Hoektronics/Shukongji/scripts/pcb-gcode-3.6.0.1/docs/images/isolation.jpg

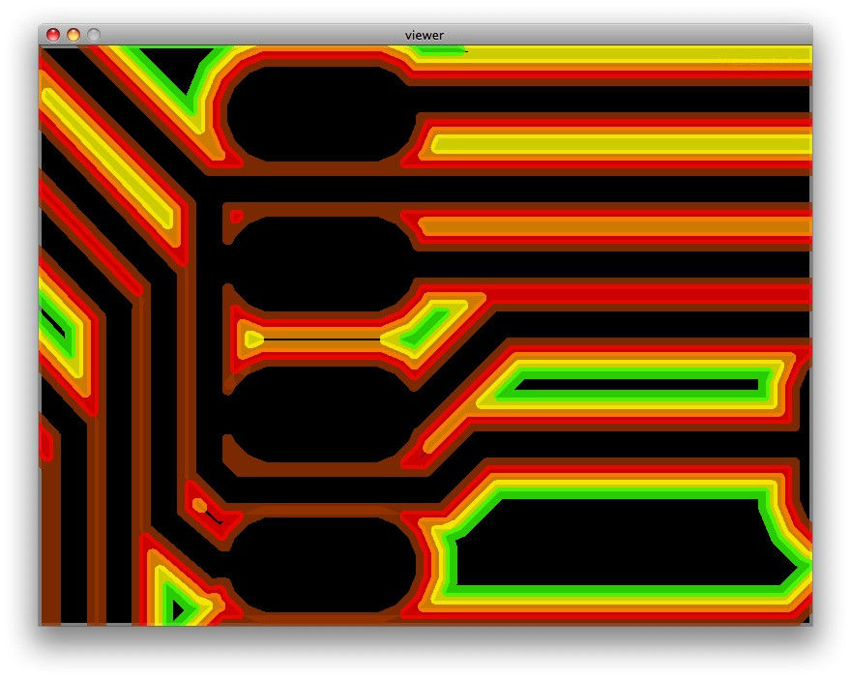
scripts/pcb-gcode-3.6.0.1/docs/images/isolation.jpg
