Hoektronics/Shukongji/scripts/pcb-gcode-3.6.0.1/docs/images/0_007.jpg

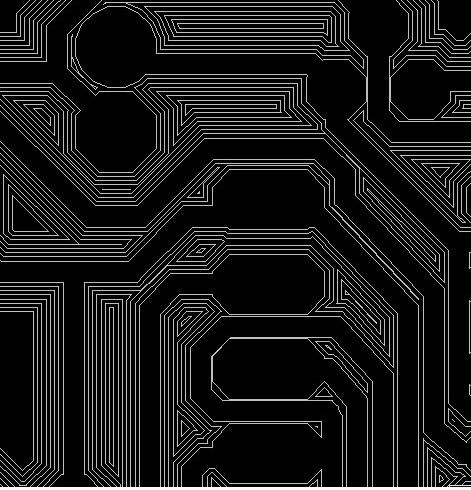
scripts/pcb-gcode-3.6.0.1/docs/images/0_007.jpg
