Hoektronics/Shukongji/scripts/pcb-gcode-3.6.0.1/docs/images/clr0_007.jpg

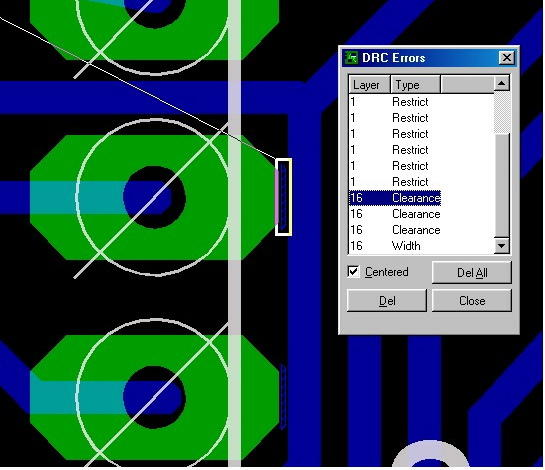
scripts/pcb-gcode-3.6.0.1/docs/images/clr0_007.jpg
