Hoektronics/Shukongji/scripts/pcb-gcode-3.6.0.1/docs/images/isolation_settings.jpg

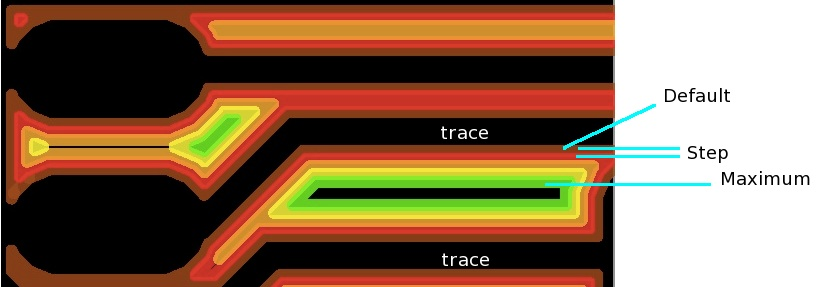
scripts/pcb-gcode-3.6.0.1/docs/images/isolation_settings.jpg
