Hoektronics/Shukongji/scripts/pcb-gcode-3.6.0.1/docs/images/pcb.jpg

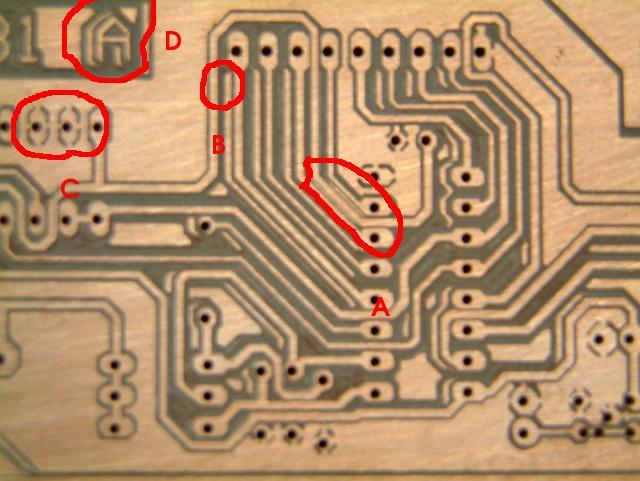
scripts/pcb-gcode-3.6.0.1/docs/images/pcb.jpg
