Hoektronics/Shukongji/scripts/pcb-gcode-3.6.0.1/docs/images/setting_other_clr_0_007.jpg

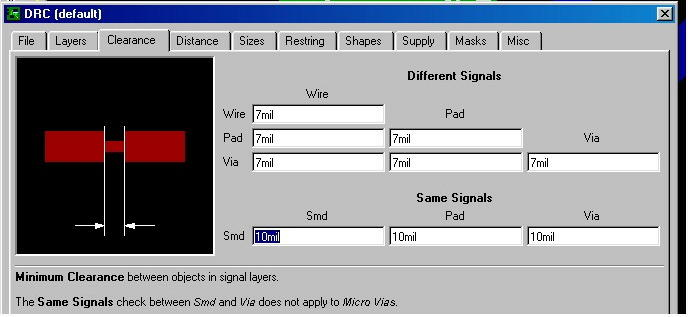
scripts/pcb-gcode-3.6.0.1/docs/images/setting_other_clr_0_007.jpg
