Hoektronics/Shukongji/electronics/hoekdrive17/bill-of-materials.xls

Qty | Value | Device | Parts | Manufacturer | Manufacturer P/N
2 | 8 pins | .100" pitch breakaway header, male | JP1, JP2
1 | 680nF | CAPACITOR - 0805 - 10% - 25V | C1
2 | 220nF | CAPACITOR - 0603 - 10% - 25V | C2, C7
3 | 100nF | CAPACITOR - 0603 - 10% - 25V | C3, C5, C6
1 | 33k | RESISTOR - 0603 - 1% | R1
4 | 100k | RESISTOR - 0603 - 5% | R2, R3, R4, R6
1 | 12k | RESISTOR - 0603 - 1% | R5
2 | 0.27R | RESISTOR - 0805 - 1% | R7, R8
1 | 1k | RESISTOR - 0805 - 5% | R9
1 | GREEN | LED - 0805 - GREEN | POWER
1 | A4982 | A4982 | A4982 | Allegro | A4982SETTR-T
