Hoektronics/Shukongji/electronics/cnc-controller/mega-pin-allocation.xls

Sheet: Overview
i/o requirements:
module | pins | instances | total
usb / serial | 2 | 1 | 2 | ok
axes steppers | 3 | 5 | 15 | ok
endstops | 1 | 6 | 6 | ok
sd card | 1 | 1 | 1 | ok
buzzer | 1 | 1 | 1 | ok
debug led | 1 | 1 | 1 | ok
led mosfets | 3 | 1 | 3 | ok
spi | 3 | 1 | 3 | ok
tool zeroing | 1 | 1 | 1 | ok
door | 1 | 1 | 1 | ok
spindle rpm | 1 | 1 | 1 | ok
spindle on/off | 1 | 1 | 1 | ok
vacuum on/off | 1 | 1 | 1 | ok
spindle speed (spi) | 1 | 1 | 1 | ok
user uarts | 2 | 3 | 6 | ok
i2c | 2 | 1 | 2 | ok
lcd interface | 6 | 1 | 6
 |  | total | 52
 |  | available | 54
 |  | remaining | 2

Sheet: Pin Allocation
Pin Name | Alt1 | Alt2 | Alt3 | My Usage | peripheral allocation
D0 | RX0 |  |  | USB SERIAL | uart0 | serial
D1 | TX0 |  |  | USB SERIAL | uart1 | user
D2 | PWM | INTERRUPT |  | TACHOMETER | uart2 | user
D3 | PWM | INTERRUPT |  | VACUUM RELAY | uart3 | user
D4 | PWM |  |  | SPINDLE SPEED | i2c | user
D5 | PWM |  |  | BUZZER | spi | sd / digipot / user
D6 | PWM |  |  | GREEN
D7 | PWM |  |  | RED
D8 | PWM |  |  | BLUE
D9 | PWM |  |  | LCD_RS
D10 | PWM |  |  | LCD_EN
D11 | PWM |  |  | LCD_D7
D12 | PWM |  |  | LCD_D6
D13 | PWM | DEBUG |  | DEBUG LED
D14 | TX3 |  |  | ENC_A
D15 | RX3 |  |  | ENC_B
D16 | TX2 |  |  | user
D17 | RX2 |  |  | user
D18 | TX1 | INTERRUPT |  | user
D19 | RX1 | INTERRUPT |  | user
D20 | SDA | INTERRUPT |  | I2C
D21 | SCL | INTERRUPT |  | I2C
D22 |  |  |  | LCD_D5
D23 |  |  |  | LCD_D4
D24 |  |  |  | OK_BUTTON
D25 |  |  |  | DOOR
D26 |  |  |  | TOOLZERO
D27 |  |  |  | XMIN
D28 |  |  |  | XMAX
D29 |  |  |  | YMIN
D30 |  |  |  | YMAX
D31 |  |  |  | ZMIN
D32 |  |  |  | ZMAX
D33 |  |  |  | XSTEP
D34 |  |  |  | XDIR
D35 |  |  |  | XENABLE
D36 |  |  |  | YSTEP
D37 |  |  |  | YDIR
D38 |  |  |  | YENABLE
D39 |  |  |  | ZSTEP
D40 |  |  |  | ZDIR
D41 |  |  |  | ZENABLE
D42 |  |  |  | ASTEP
D43 |  |  |  | ADIR
D44 | PWM |  |  | AENABLE
D45 | PWM |  |  | BSTEP
D46 | PWM |  |  | BDIR
D47 |  |  |  | BENABLE
D48 |  |  |  | DIGIPOT SELECT
D49 |  |  |  | SD SELECT
D50 | MISO |  |  | SPI
D51 | MOSI |  |  | SPI
D52 | SCK |  |  | SPI
D53 | SS |  |  | SPI
