Hoektronics/Shukongji/electronics/cnc-controller/power-budget.xls

Sheet: Sheet1
power budget |  | 3.3V (mA) |  |  | 5V (mA) |  |  | 24V (A)
module | qty | min | max | total | min | max | total | min | max | total
axes steppers | 4 | 0 | 0 | 0 | 0 | 5 | 20 | 0 | 4.8 | 19.2
lcpxpresso | 1 |  |  | 0 |  | 100 | 100 |  |  | 0
sd card | 1 |  | 100 | 100 |  |  | 0 |  |  | 0
level shifters | 2 |  | 100 | 200 |  | 50 | 100 |  |  | 0
bluetooth | 1 |  | 50 | 50 |  |  | 0 |  |  | 0
wifi | 1 |  | 212 | 212 |  |  | 0 |  |  | 0
3.3V | 1 |  |  | 0 |  | 370.92 | 370.92 |  |  | 0
5v | 1 |  |  | 0 |  |  | 0 |  | 0.1231083333 | 0.1231083333
 | total |  |  | 562 |  |  | 590.92 |  |  | 19.32310833

Sheet: Sheet2
Left Row |  |  | Right Row |  |  | Extras
Pin Name | Function | My Usage | Pin Name | Function | My Usage | Pin Name | Function | My Usage
P0.9 | MOSI | SD Card | P0.4 | CAN_RX |  | P2.9 | USB PULLUP | NONE
P0.8 | MISO | SD Card | P0.5 | CAN_TX | ASTEP | P0.20 |  | SPINSPD
P0.7 | SCK | SD Card | P0.10 | TX/I2C | ADIR | P0.19 |  | DOOR
P0.6 |  | SD Card | P0.11 | RX/I2C | ZENABLE | P4.29 |  | TOOLZERO
P0.0 | i2c / tx |  | P2.0 | PWM | MOSFET | P4.28 |  | x protect
P0.1 | i2c / rx |  | P2.1 | PWM | MOSFET | P3.26 |  | y protect
P0.18 | MOSI | AENABLE | P2.2 | PWM | MOSFET | P3.25 |  | z protect
P0.17 | MISO | ZSTEP | P2.3 | PWM | YENABLE | P1.29 |  | ZDIR
P0.15 | SCK / Tx | debug port | P2.4 | PWM | XSTEP | P1.28 |  | a protect
P0.16 | Rx | debug port | P2.5 | PWM | XDIR | P1.27
P0.23 | analog | CURRENT- | P2.6 |  |  | P1.26 |  | YSTEP
P0.24 | analog | CURRENT+ | P2.7 |  |  | P1.25 |  | BUZZER
P0.25 | analog |  | P2.8 |  |  | P1.24 |  | SPINDLE RELAY
P0.26 | analog | VOUT | P2.10 |  |  | P1.23 |  | YDIR
P1.30 | analog |  | P2.11 |  |  | P1.22
P1.31 | analog | YSTOP | P2.12 |  |  | P1.21 |  | XSTOP
P0.2 |  | ZSTOP |  |  |  | P1.20 |  | XENABLE
P0.3 |  | ASTOP |  |  |  | P1.19
P0.21 |  |  |  |  |  | P1.18
P0.22
P0.27
P0.28
P2.13
