Hoektronics/Shukongji/mechanical/Mechanical Switch.SLDASM

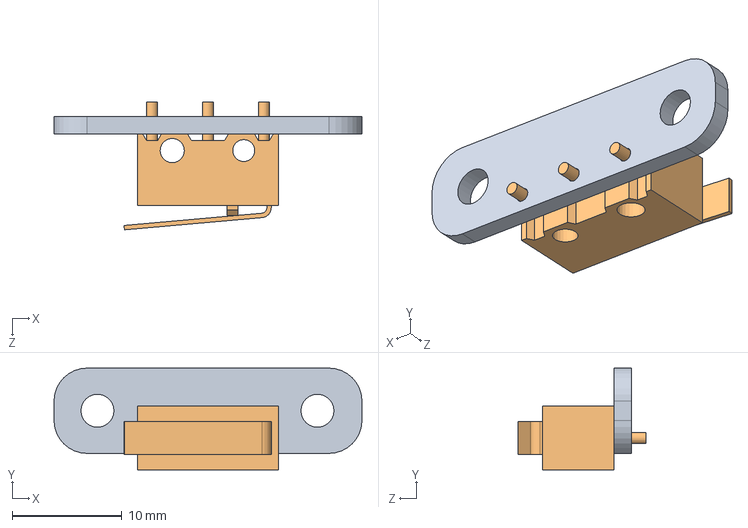
[picture p11: CAD file, 2013-03-05]
mechanical/Mechanical Switch.SLDASM
28.0 x 9.25 x 11.6 mm
Switch-PCB
D2F-Switch
