Hoektronics/Shukongji/mechanical/X-Axis.SLDASM

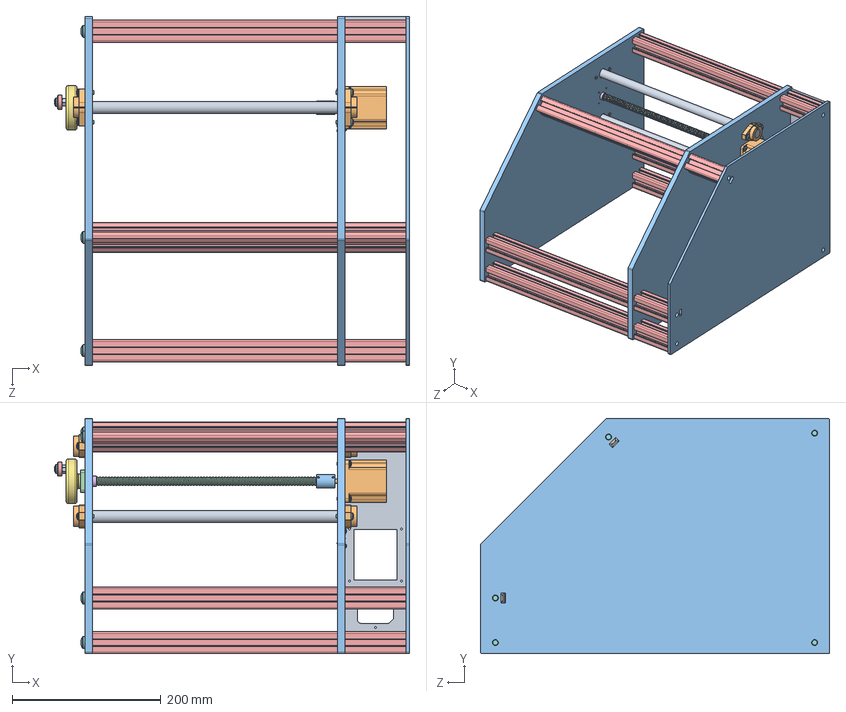
[picture p12: CAD file, 2013-03-05]
mechanical/X-Axis.SLDASM
478.5 x 317.0 x 470.0 mm
X-Rod x 2
nema23
flexible-coupling
SFUXXXX-Ball-Screw
626ZZ x 2
F6-14-Thrust-Bearing
Hand-Wheel
pan cross head_am x 25
hex nut style 1_am x 4
SHF16 x 4
Side-Panel x 2
626-Bearing-Mount
Frame-Base-Width x 11
flat washer narrow_am
Switch-PCB
D2F-Switch
Rear-Panel
LED-Strip x 2
LED-Cover x 2
