Hoektronics/Shukongji/mechanical/Hand-Wheel.SLDASM

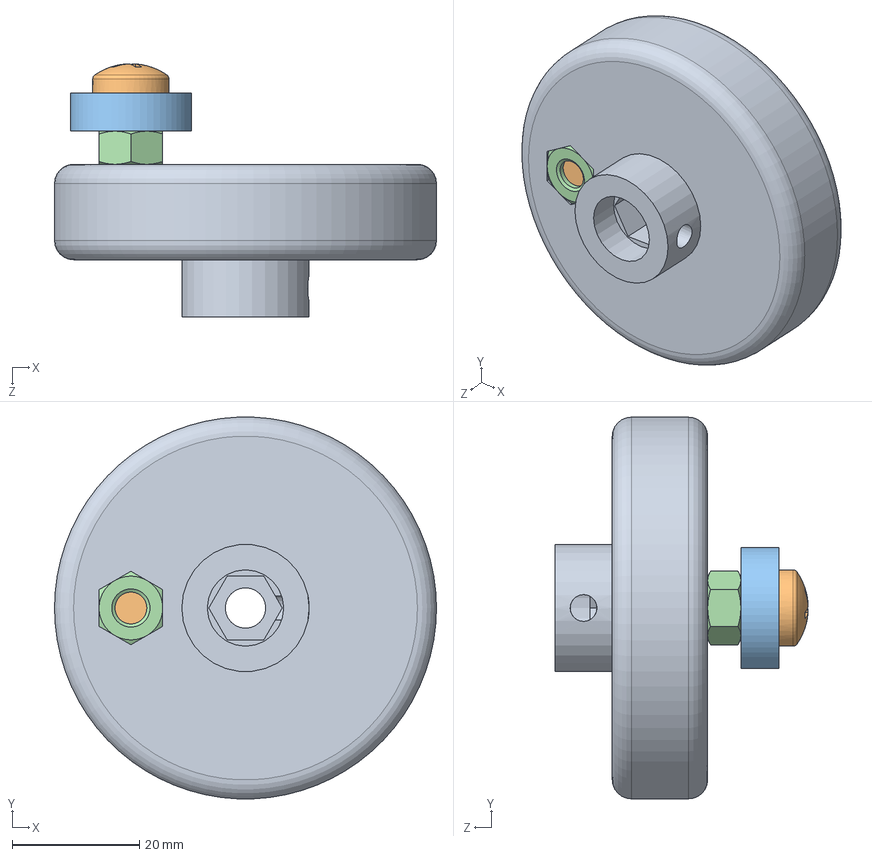
[picture p13: CAD file, 2013-03-05]
mechanical/Hand-Wheel.SLDASM
60.0 x 59.9 x 39.8 mm
Hand-Wheel
pan cross head_am
626ZZ
hex nut style 1_am x 2
