Hoektronics/Shukongji/mechanical/Y-Drive.SLDASM

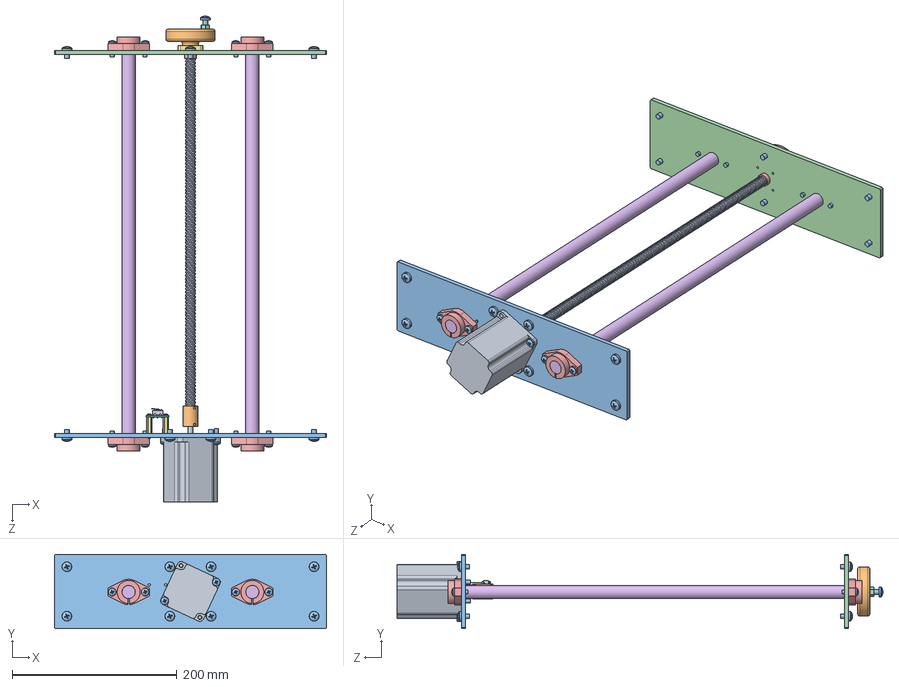
[picture p14: CAD file, 2013-03-05]
mechanical/Y-Drive.SLDASM
330.0 x 90.0 x 589.5 mm
flexible-coupling
Y-Plate-Front
Y-Plate-Rear
SHF16 x 4
Y-Rod x 2
626-Bearing-Mount
626ZZ
SFUXXXX-Ball-Screw
F6-14-Thrust-Bearing
flat washer narrow_am
hex nut style 1_am x 2
pan cross head_am x 30
Hex-Standoff x 2
Switch-PCB
D2F-Switch
