Hoektronics/Shukongji/mechanical/Spindle Assembly.SLDASM

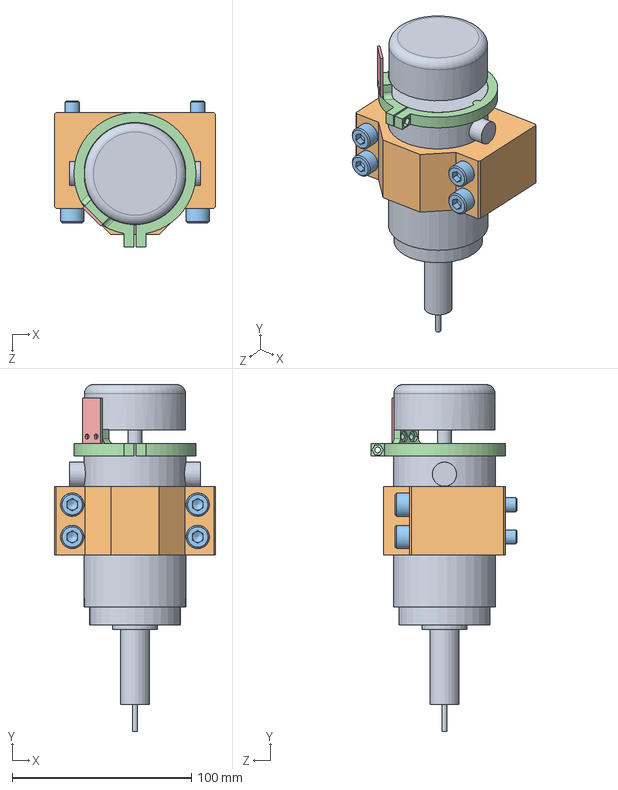
[picture p15: CAD file, 2013-03-05]
mechanical/Spindle Assembly.SLDASM
90.0 x 193.5 x 81.5 mm
E240-Spindle
Spindle-Clamp
socket head cap screw_am x 4
Tachometer-Mount
Tachometer-PCB
