Hoektronics/Shukongji/mechanical/Z-Axis.SLDASM

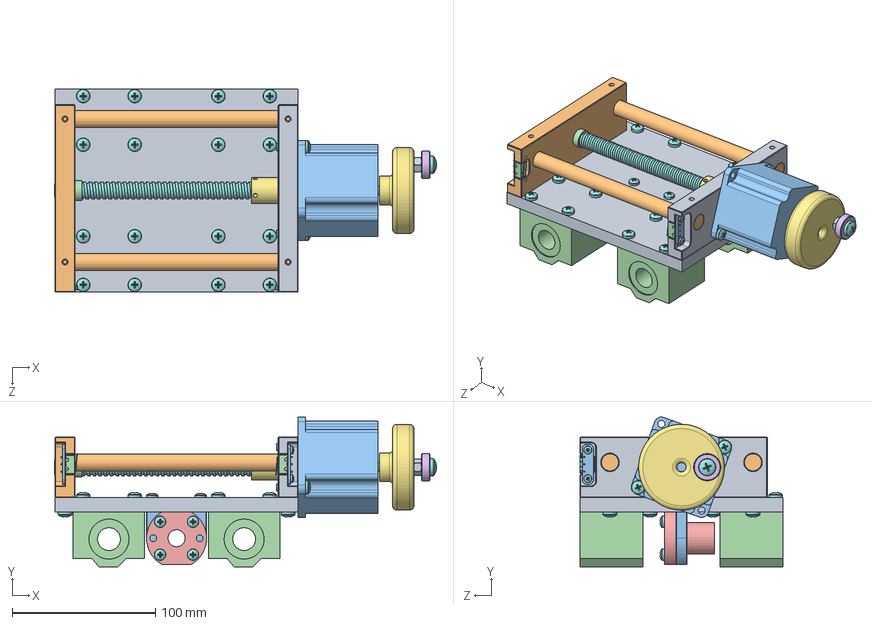
[picture p16: CAD file, 2013-03-05]
mechanical/Z-Axis.SLDASM
267.1 x 104.8 x 142.0 mm
Z-Plate
Z-Rod x 2
nema23
SC16UU x 4
SFU1204-Nut
626ZZ x 2
flexible-coupling
SFUXXXX-Ball-Screw
XY-Motor-Mount
XY-Bearing-Mount
SFU1204-Nut-Mount
F6-14-Thrust-Bearing
hex nut jam_am
flat washer narrow_am
Hand-Wheel
pan cross head_am x 35
hex nut style 1_am x 2
socket set screw flat point_am x 4
Switch-PCB x 2
D2F-Switch x 2
