Hoektronics/Shukongji/mechanical/Y-Stage.SLDASM

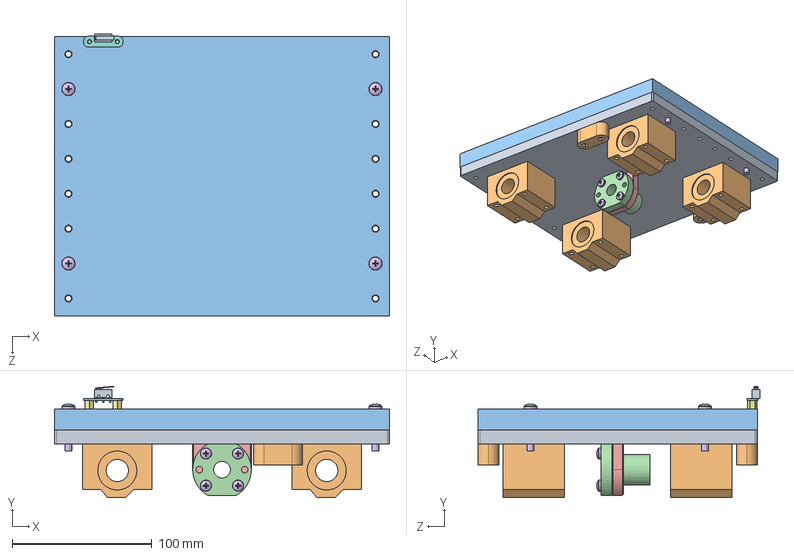
[picture p17: CAD file, 2013-03-05]
mechanical/Y-Stage.SLDASM
240.0 x 79.8 x 201.9 mm
Y-Stage-Plate
SC16UU x 4
Y-Stage
SFU1204-Nut
SFU1204-Nut-Mount
pan cross head_am x 26
Hex-Standoff x 2
Switch-PCB
D2F-Switch
Y-Endstop-Trigger x 2
