Hoektronics/Shukongji/mechanical/Z-Stage.SLDASM

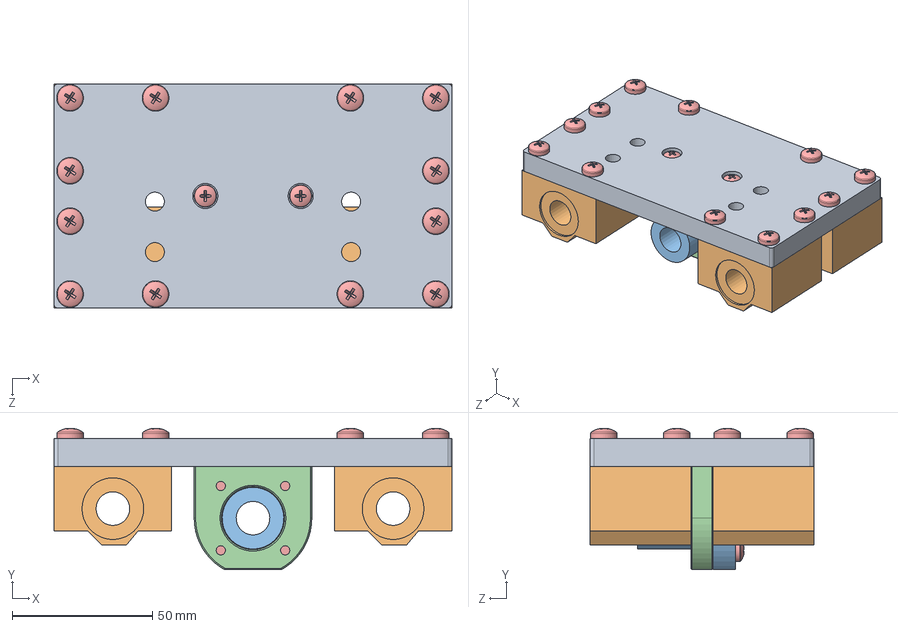
[picture p18: CAD file, 2013-03-05]
mechanical/Z-Stage.SLDASM
142.0 x 50.5 x 80.0 mm
Z-Stage
SC12UU x 4
SFU1204-Nut
SFU1204-Nut-Mount
pan cross head_am x 18
