Hoektronics/Shukongji/mechanical/Main Assembly.SLDASM

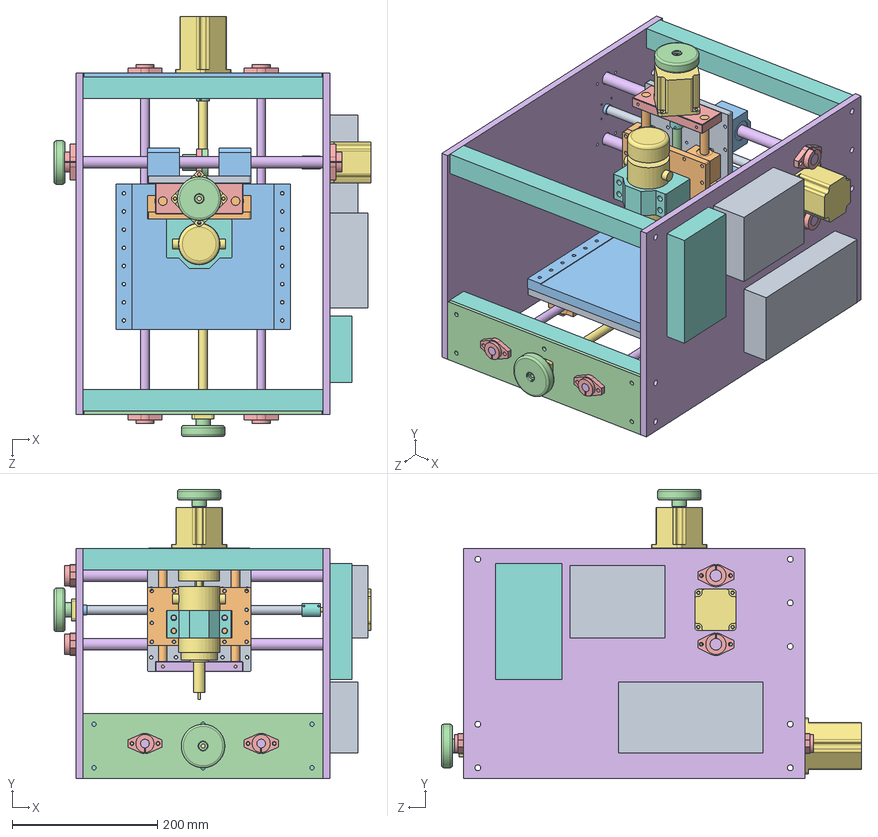
[picture p19: CAD file, 2012-12-18]
mechanical/Main Assembly.SLDASM
436.0 x 398.2 x 578.0 mm
Y-Stage-Plate
SC12UU x 8
Y-Stage
SFU1204-Nut x 3
SFU1204-Nut-Mount x 3
X-Rod x 2
nema23 x 3
flexible-coupling x 3
X-Drive-Rod
626ZZ x 3
F6-14-Thrust-Bearing x 3
Hand-Wheel x 3
SHF16 x 4
Side-Panel x 2
626-Bearing-Mount x 2
Frame-Base-Width x 6
Z-Plate
Z-Rod x 2
SC16UU x 4
Z-Drive-Rod
XY-Motor-Mount
XY-Bearing-Mount
E240-Spindle
Spindle-Clamp
PSU-12V-10A
Z-Stage
Y-Plate-Front
Y-Plate-Rear
SHF12 x 4
Y-Rod x 2
Y-Drive-Rod
3-Axis-Driver
Spindle-PSU
