Hoektronics/Shukongji/mechanical/Frame.SLDASM

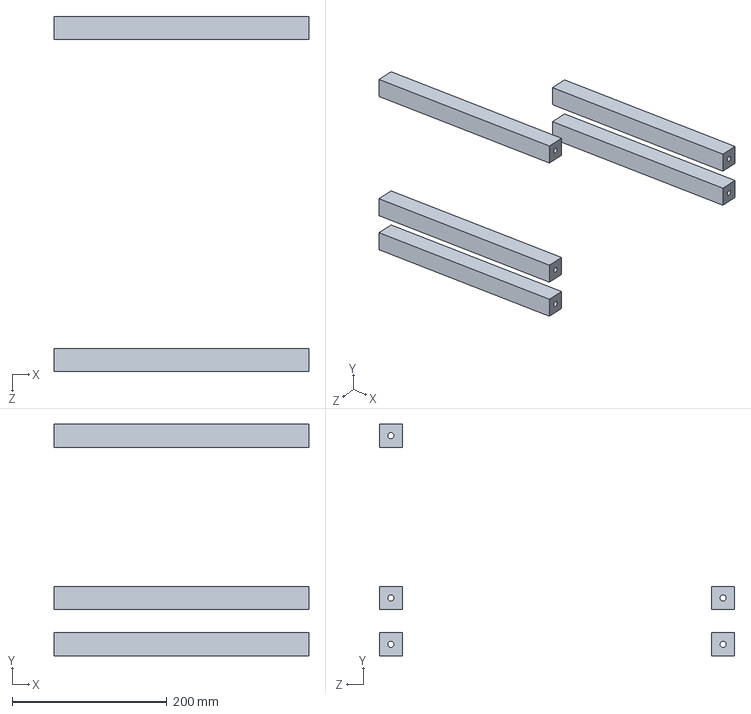
[picture p20: CAD file, 2012-12-17]
mechanical/Frame.SLDASM
330.0 x 300.0 x 460.0 mm
Frame-Base-Width x 5
