Hoektronics/Shukongji/mechanical/Exterior.SLDASM

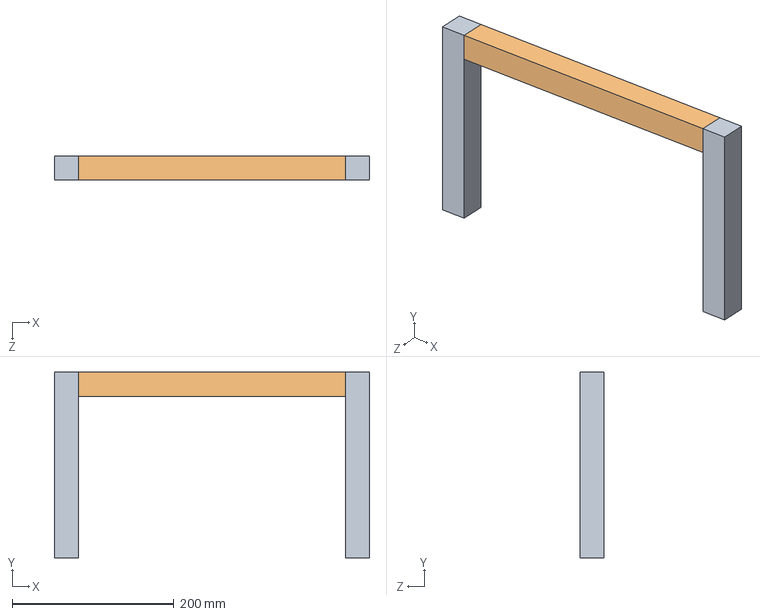
[picture p21: CAD file, 2012-10-28]
mechanical/Exterior.SLDASM
390.0 x 230.0 x 30.0 mm
Frame-Front-Column x 2
Frame-Top-Column
