Hoektronics/Shukongji/mechanical/Tachometer-Mount.SLDPRT

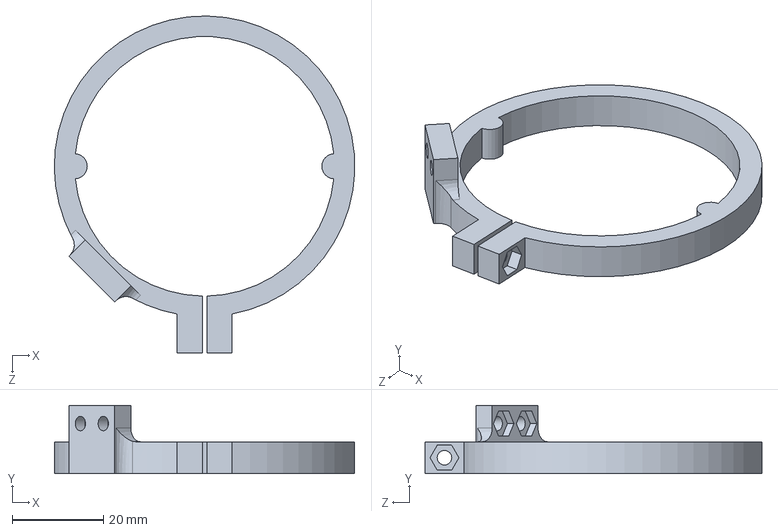
[picture p22: CAD file, 2013-03-05]
mechanical/Tachometer-Mount.SLDPRT
66.0 x 15.0 x 74.0 mm
