Hoektronics/Shukongji/scripts/meshcam/double-side-frame.SLDPRT

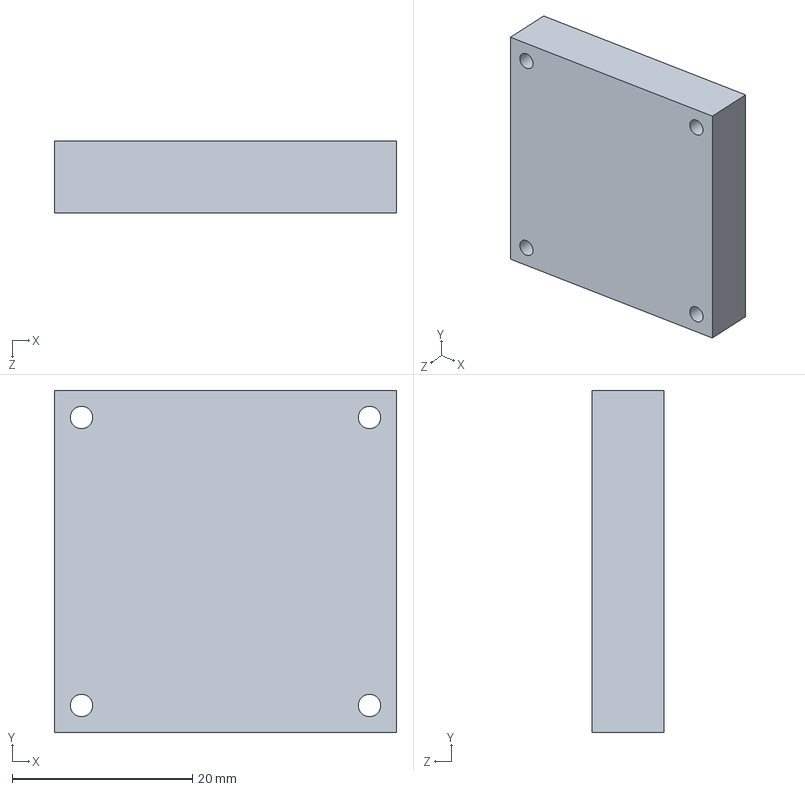
[picture p23: CAD file, 2013-03-19]
scripts/meshcam/double-side-frame.SLDPRT
38.0 x 38.0 x 8.00 mm
