Hoektronics/Shukongji/mechanical/Tachometer-PCB.SLDPRT

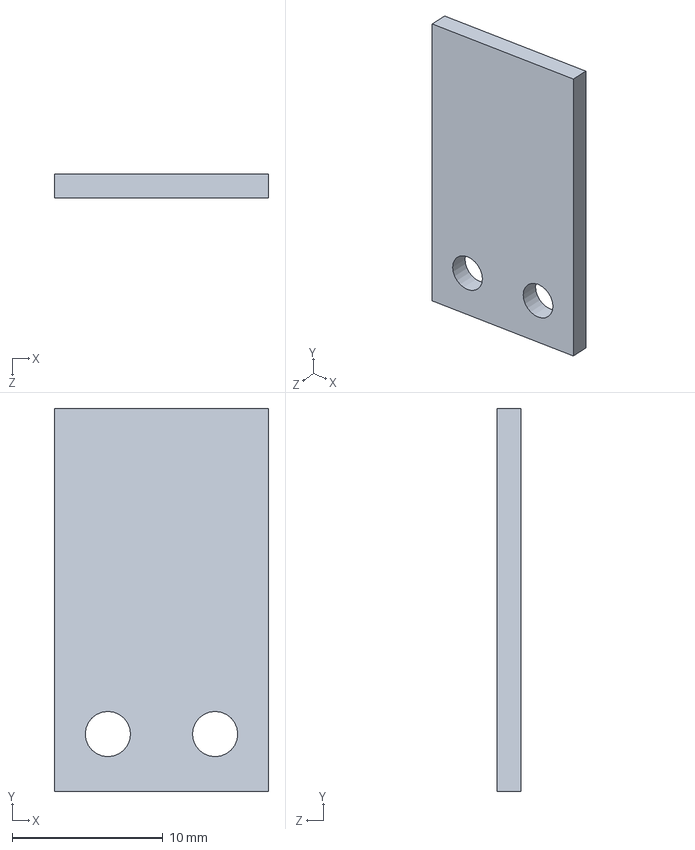
[picture p24: CAD file, 2013-03-05]
mechanical/Tachometer-PCB.SLDPRT
14.2 x 25.4 x 1.60 mm
