Hoektronics/Shukongji/mechanical/626-Bearing-Mount.SLDPRT

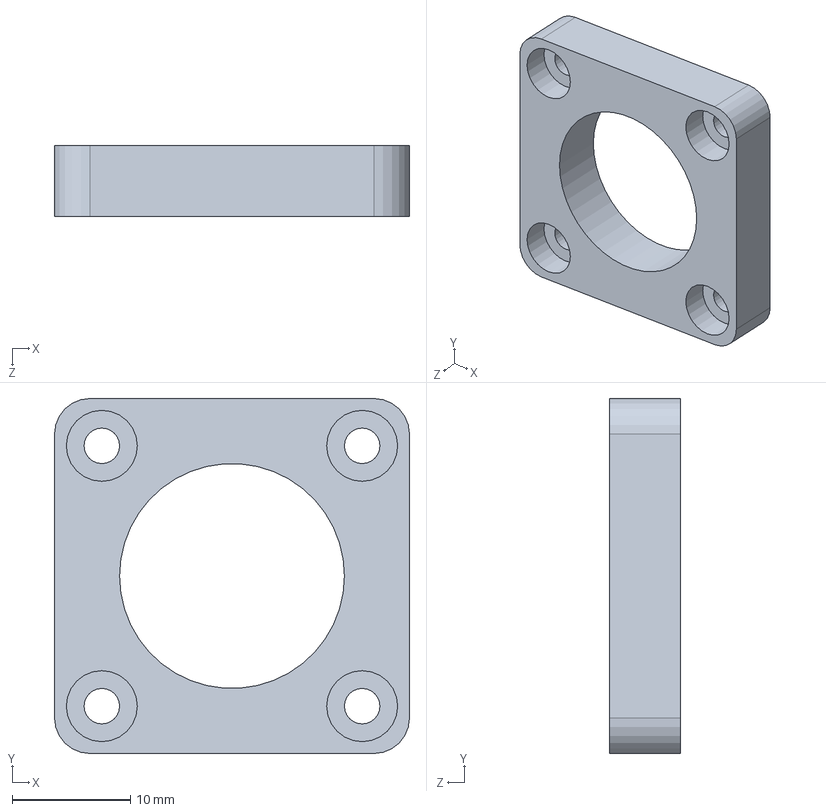
[picture p25: CAD file, 2013-03-05]
mechanical/626-Bearing-Mount.SLDPRT
30.0 x 30.0 x 6.00 mm
