Hoektronics/Shukongji/mechanical/Y-Plate-Front.SLDPRT

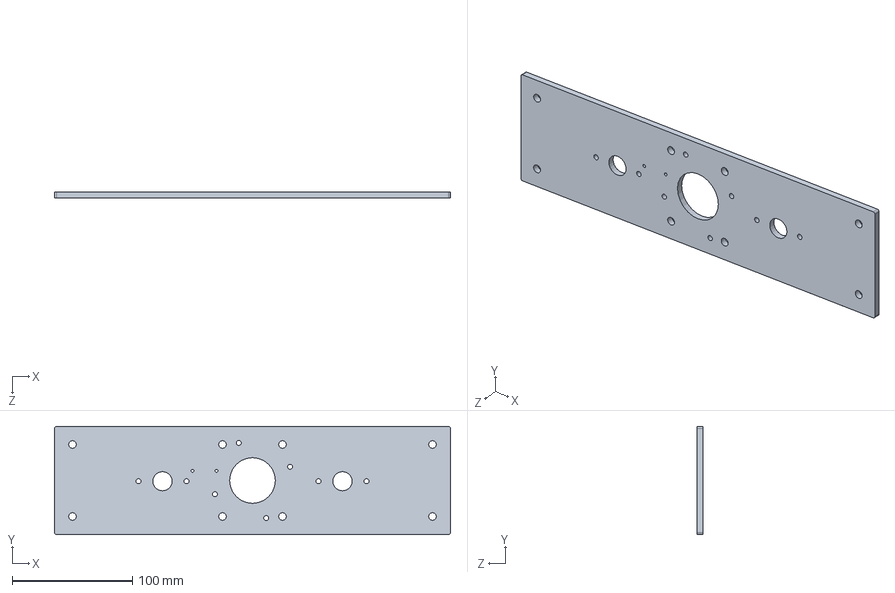
[picture p26: CAD file, 2013-03-05]
mechanical/Y-Plate-Front.SLDPRT
330.0 x 90.0 x 5.00 mm
