Hoektronics/Shukongji/mechanical/Side-Panel.SLDPRT

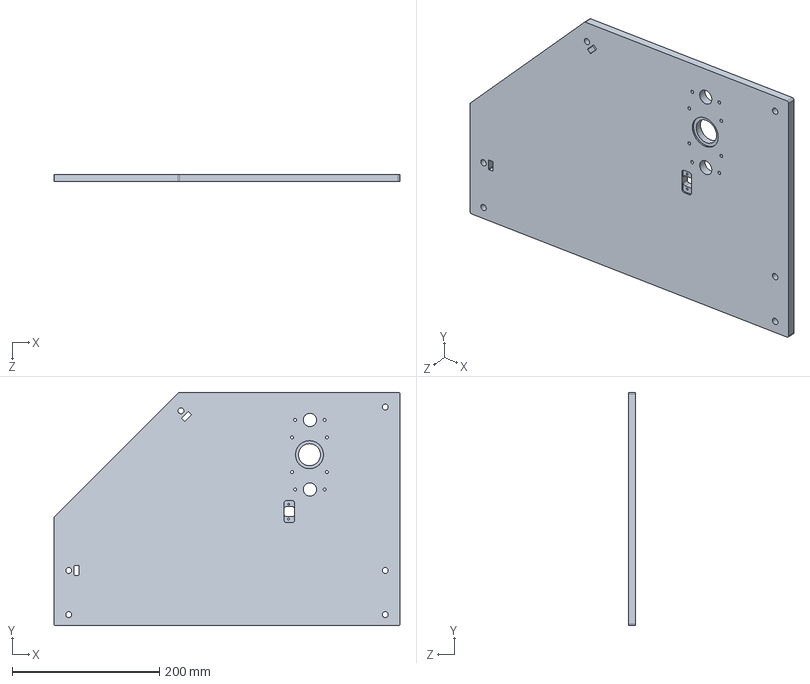
[picture p27: CAD file, 2013-03-05]
mechanical/Side-Panel.SLDPRT
470.0 x 317.0 x 10.0 mm
