Hoektronics/Shukongji/mechanical/XY-Motor-Mount.SLDPRT

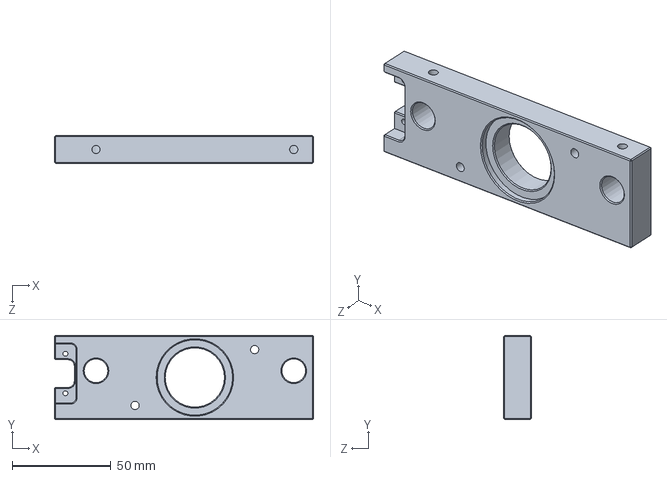
[picture p28: CAD file, 2013-03-05]
mechanical/XY-Motor-Mount.SLDPRT
131.0 x 42.5 x 14.0 mm
