Hoektronics/Shukongji/mechanical/PSU-12V-10A.SLDPRT

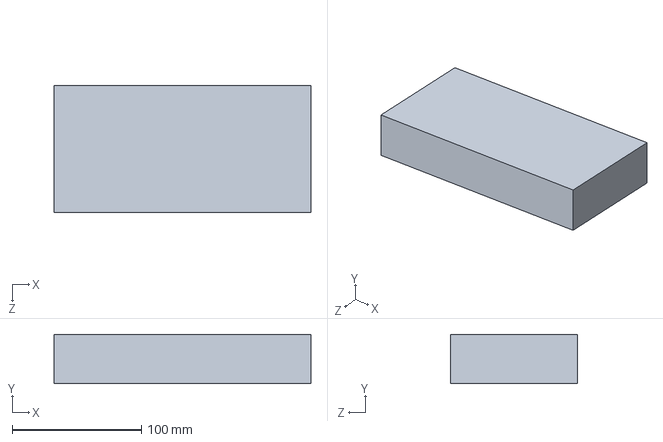
[picture p29: CAD file, 2013-03-05]
mechanical/PSU-12V-10A.SLDPRT
199.0 x 38.0 x 98.0 mm
