Hoektronics/Shukongji/mechanical/X-Rod.SLDPRT

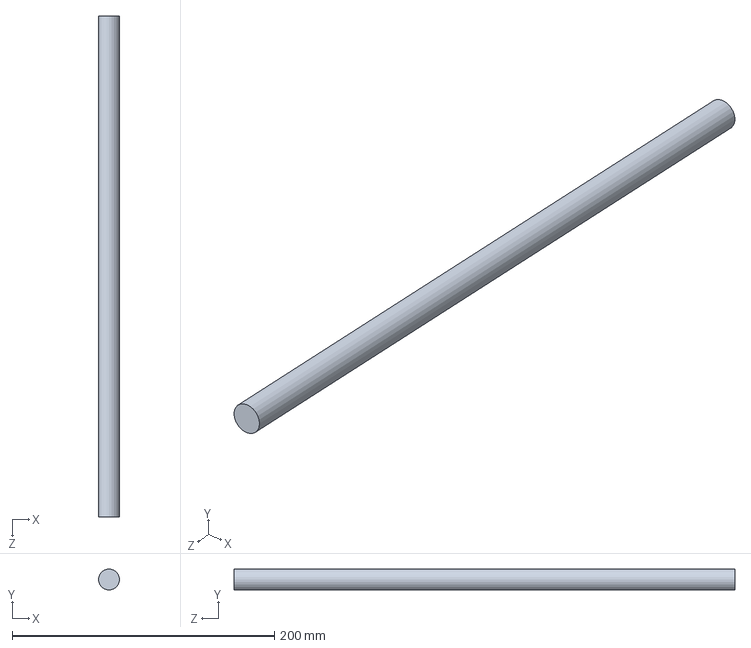
[picture p30: CAD file, 2013-03-05]
mechanical/X-Rod.SLDPRT
16.0 x 16.0 x 382.0 mm
