Hoektronics/Shukongji/mechanical/F6-14-Thrust-Bearing.SLDPRT

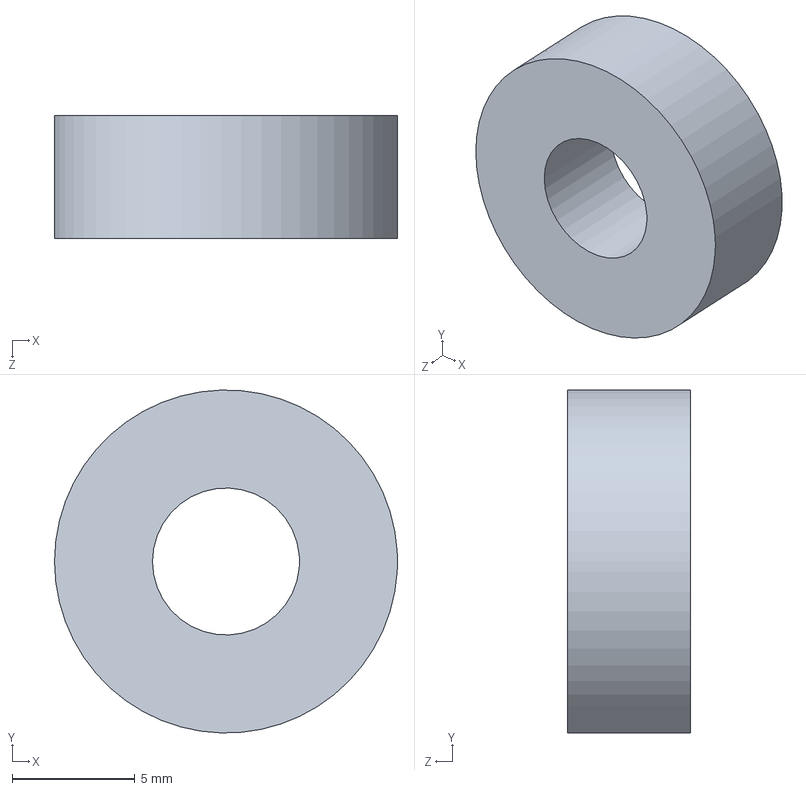
[picture p31: CAD file, 2013-03-05]
mechanical/F6-14-Thrust-Bearing.SLDPRT
14.0 x 14.0 x 5.00 mm
