Hoektronics/Shukongji/mechanical/XY-Bearing-Mount.SLDPRT

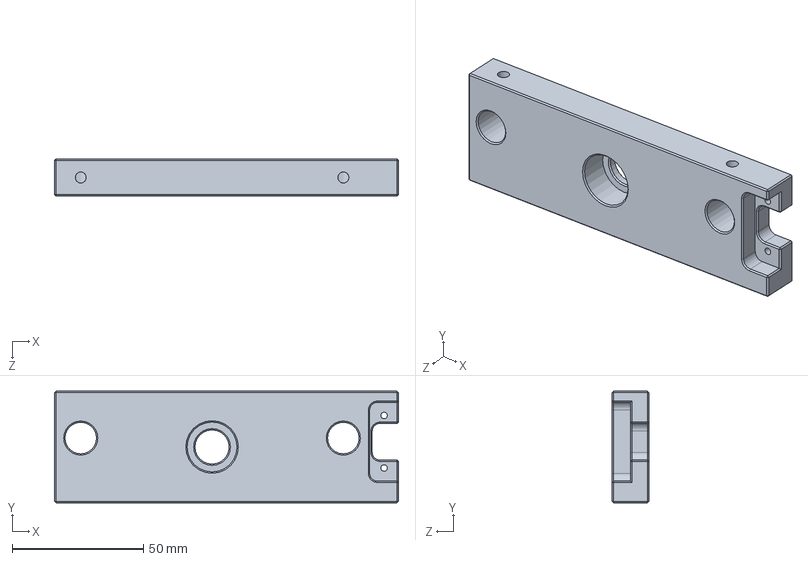
[picture p32: CAD file, 2013-03-05]
mechanical/XY-Bearing-Mount.SLDPRT
131.0 x 42.5 x 14.0 mm
