Hoektronics/Shukongji/mechanical/nema23.SLDPRT

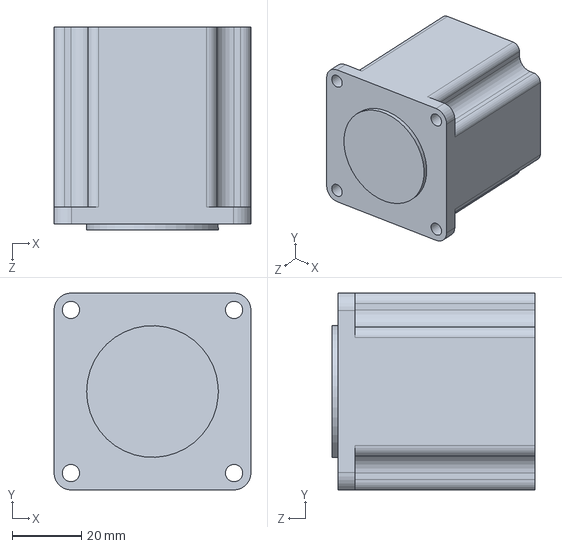
[picture p33: CAD file, 2013-03-05]
mechanical/nema23.SLDPRT
57.0 x 57.0 x 58.6 mm
