Hoektronics/Shukongji/mechanical/Y-Stage-Plate.SLDPRT

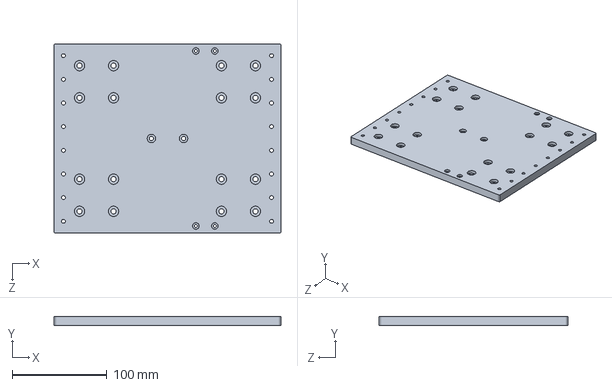
[picture p34: CAD file, 2013-03-05]
mechanical/Y-Stage-Plate.SLDPRT
240.0 x 10.0 x 200.0 mm
