Hoektronics/Shukongji/mechanical/Z-Plate.SLDPRT

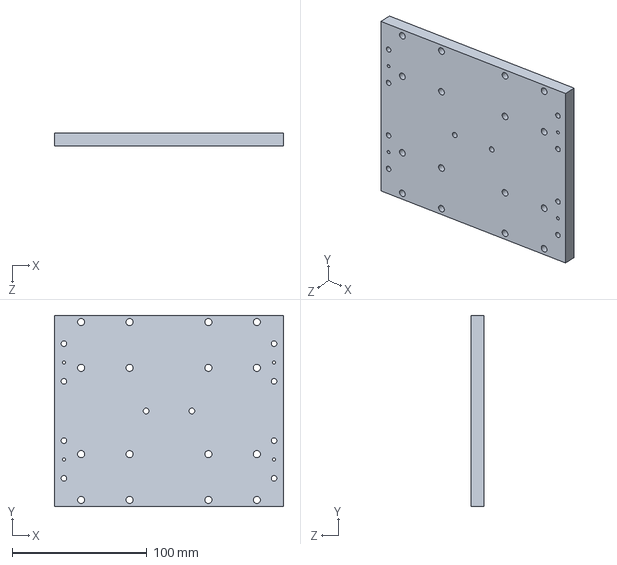
[picture p35: CAD file, 2013-03-05]
mechanical/Z-Plate.SLDPRT
170.0 x 142.0 x 10.0 mm
