Hoektronics/Shukongji/mechanical/Spindle-PSU.SLDPRT

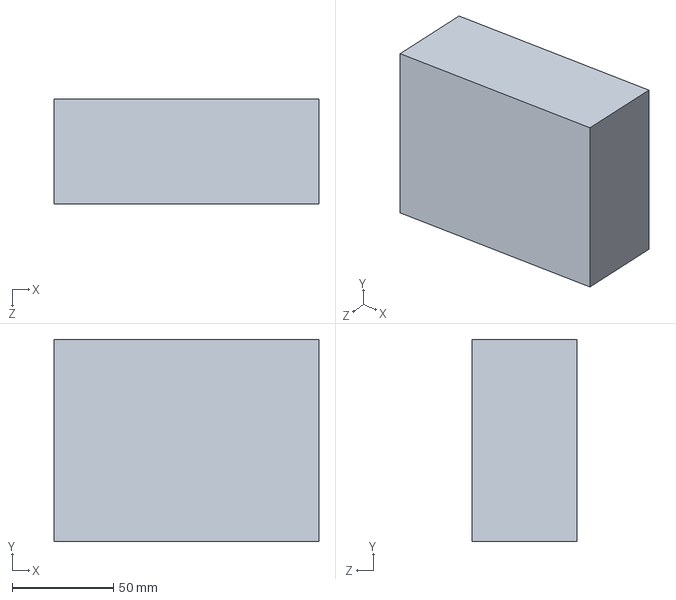
[picture p36: CAD file, 2013-03-05]
mechanical/Spindle-PSU.SLDPRT
131.0 x 100.0 x 52.0 mm
