Hoektronics/Shukongji/mechanical/LED-Cover.SLDPRT

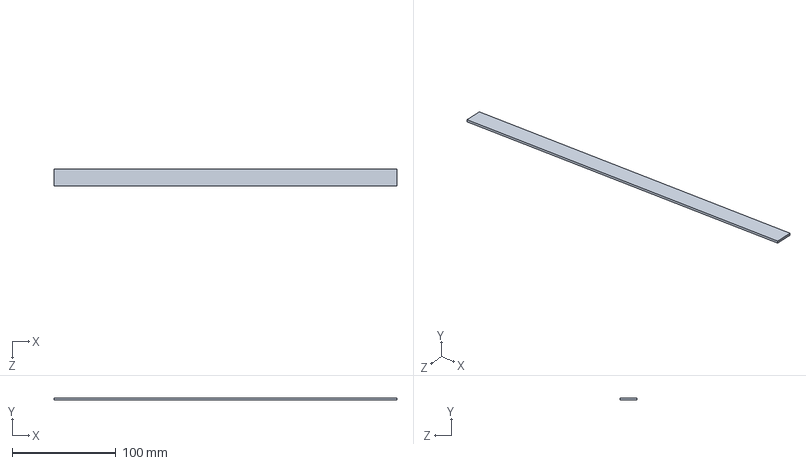
[picture p37: CAD file, 2013-03-05]
mechanical/LED-Cover.SLDPRT
330.0 x 2.00 x 16.8 mm
