Hoektronics/Shukongji/mechanical/626ZZ.SLDPRT

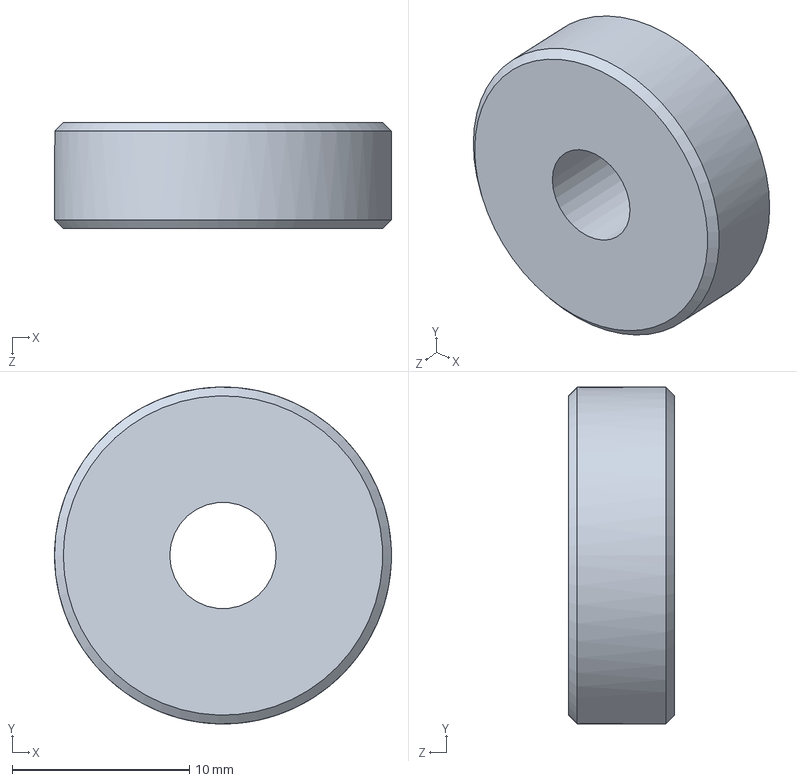
[picture p38: CAD file, 2013-03-05]
mechanical/626ZZ.SLDPRT
19.0 x 19.0 x 6.00 mm
