Hoektronics/Shukongji/mechanical/Frame-Base-Width.SLDPRT

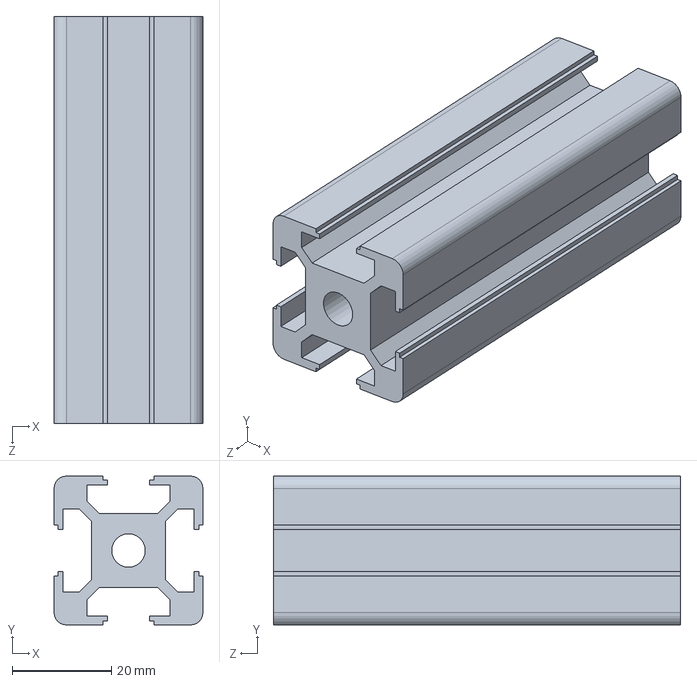
[picture p39: CAD file, 2013-03-05]
mechanical/Frame-Base-Width.SLDPRT
30.0 x 30.0 x 82.0 mm
