Hoektronics/Shukongji/mechanical/Vacuum-AC-Socket.SLDPRT

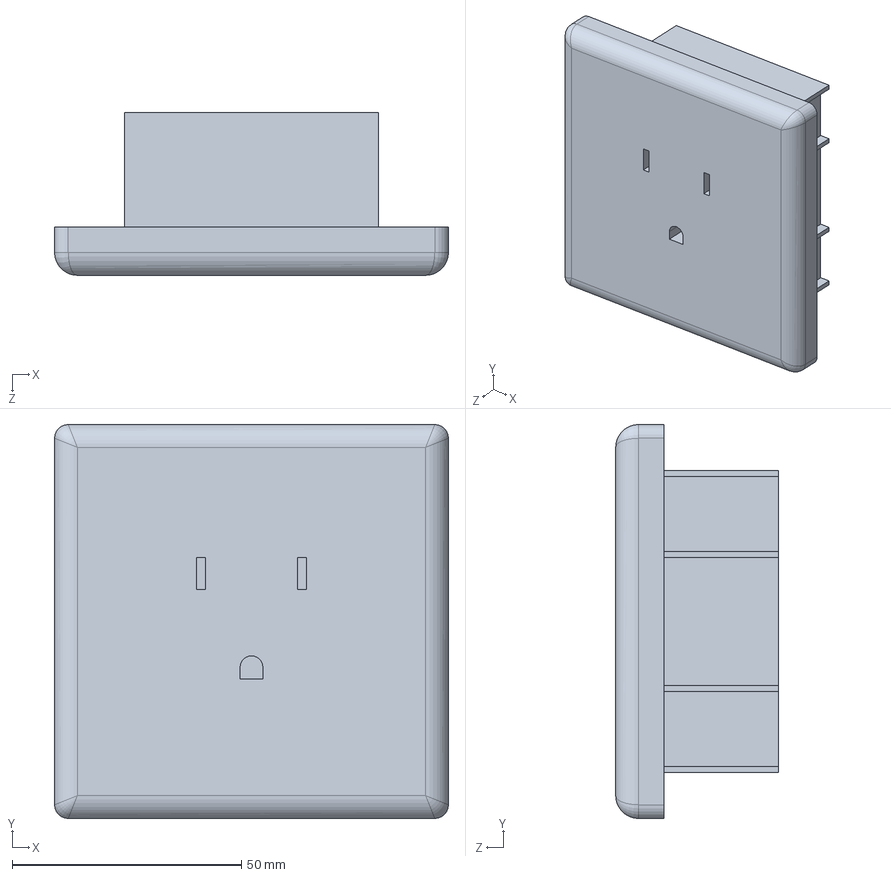
[picture p40: CAD file, 2013-03-05]
mechanical/Vacuum-AC-Socket.SLDPRT
86.0 x 86.0 x 35.5 mm
