Hoektronics/Shukongji/mechanical/Y-Endstop-Trigger.SLDPRT

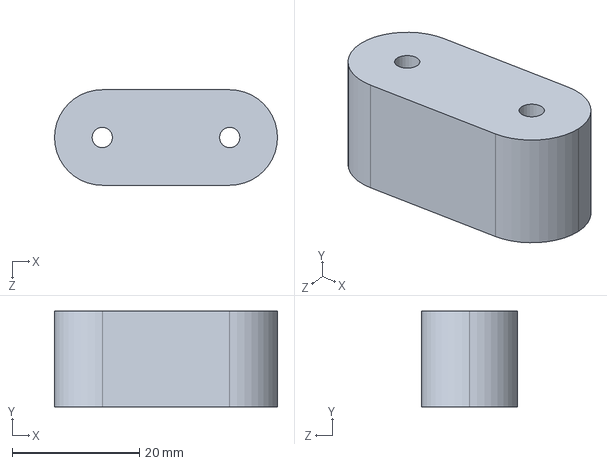
[picture p41: CAD file, 2013-03-05]
mechanical/Y-Endstop-Trigger.SLDPRT
35.0 x 15.0 x 15.0 mm
