Hoektronics/Shukongji/mechanical/30mm-Rubber-Foot.SLDPRT

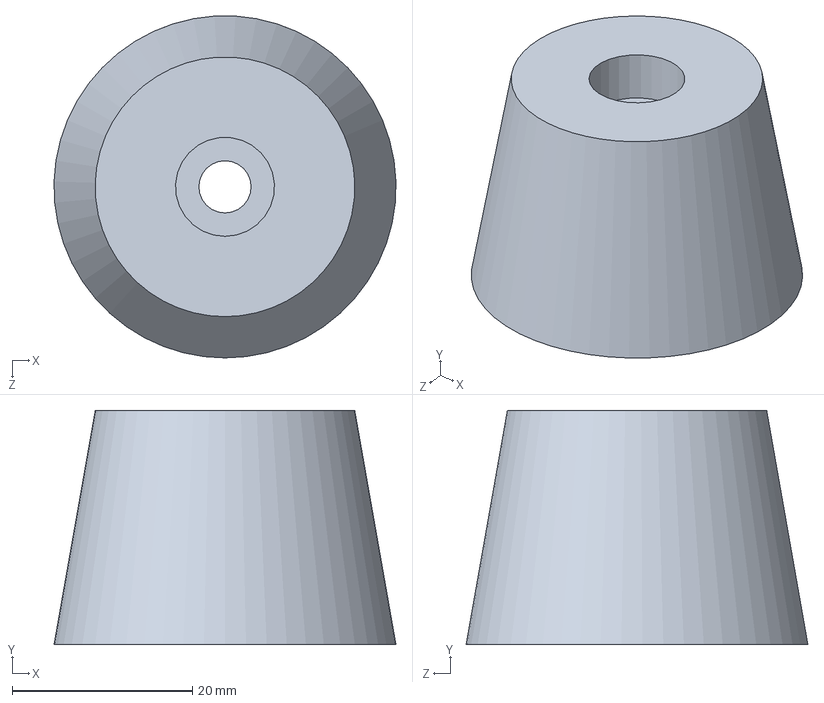
[picture p42: CAD file, 2013-03-05]
mechanical/30mm-Rubber-Foot.SLDPRT
38.0 x 26.0 x 38.0 mm
