Hoektronics/Shukongji/mechanical/Hex-Standoff.SLDPRT

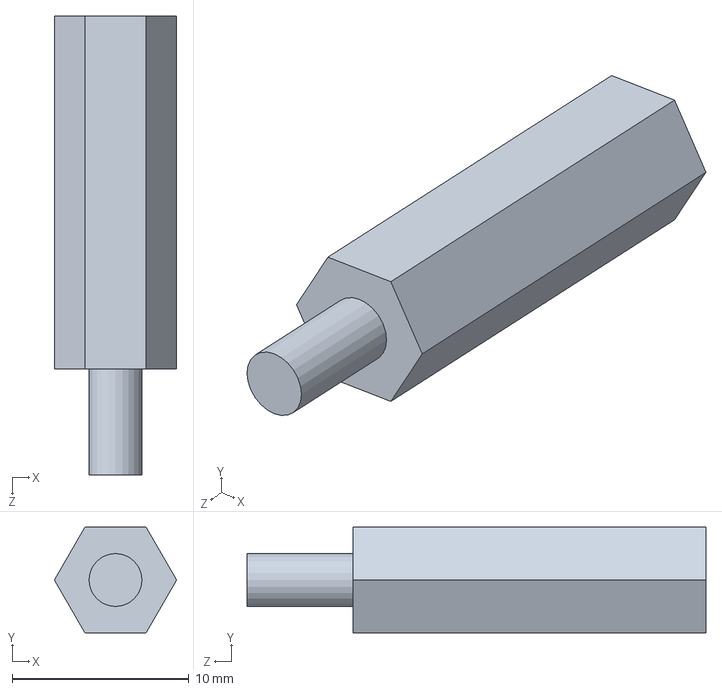
[picture p43: CAD file, 2013-03-05]
mechanical/Hex-Standoff.SLDPRT
6.93 x 6.00 x 26.0 mm
