Hoektronics/Shukongji/mechanical/SC16UU.SLDPRT

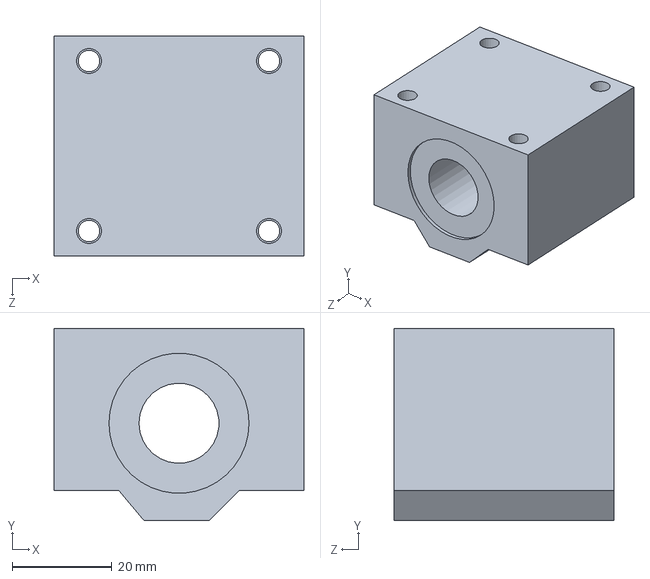
[picture p44: CAD file, 2013-03-05]
mechanical/SC16UU.SLDPRT
50.0 x 38.5 x 44.0 mm
