Hoektronics/Shukongji/mechanical/flexible-coupling.SLDPRT

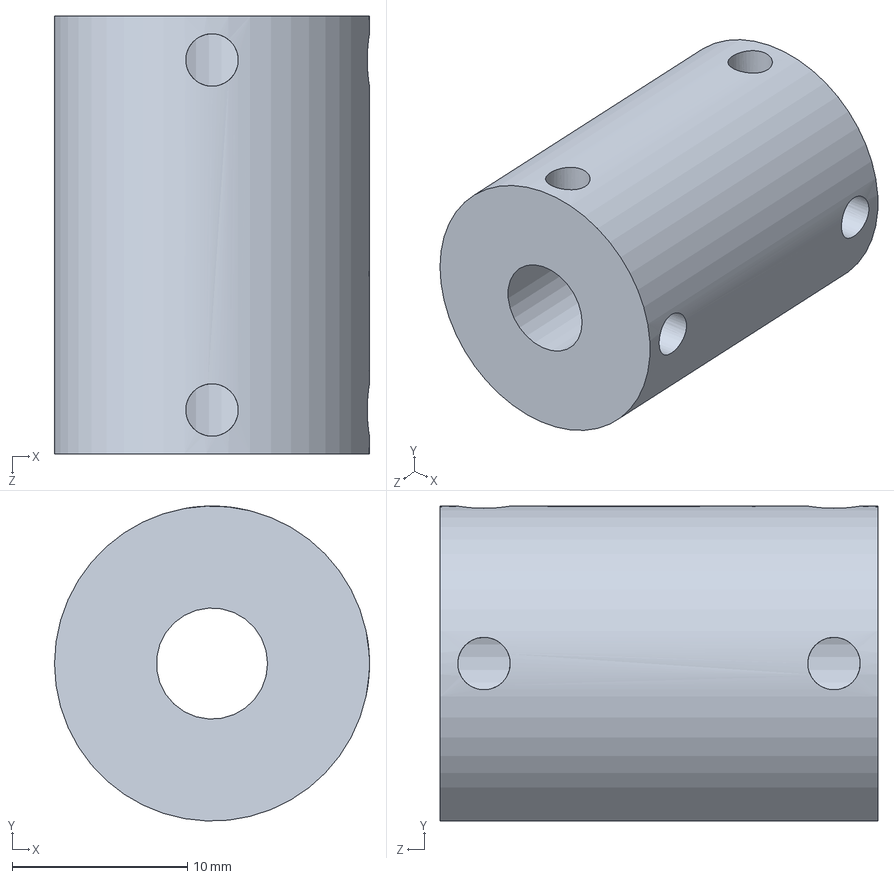
[picture p45: CAD file, 2013-03-05]
mechanical/flexible-coupling.SLDPRT
18.0 x 18.0 x 25.0 mm
