Hoektronics/Shukongji/mechanical/SC12UU.SLDPRT

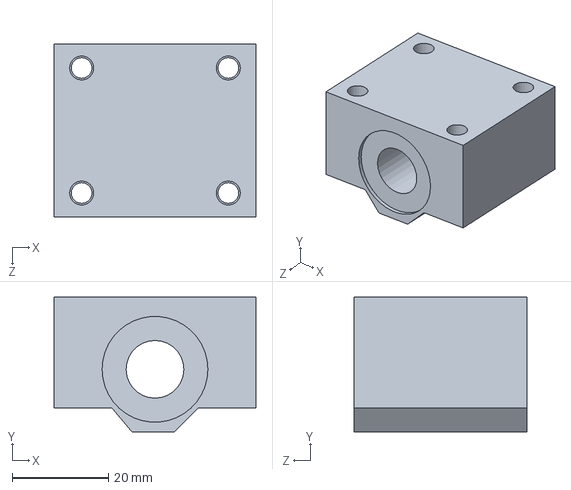
[picture p46: CAD file, 2013-03-05]
mechanical/SC12UU.SLDPRT
42.0 x 28.0 x 36.0 mm
