Hoektronics/Shukongji/mechanical/E240-Spindle.SLDPRT

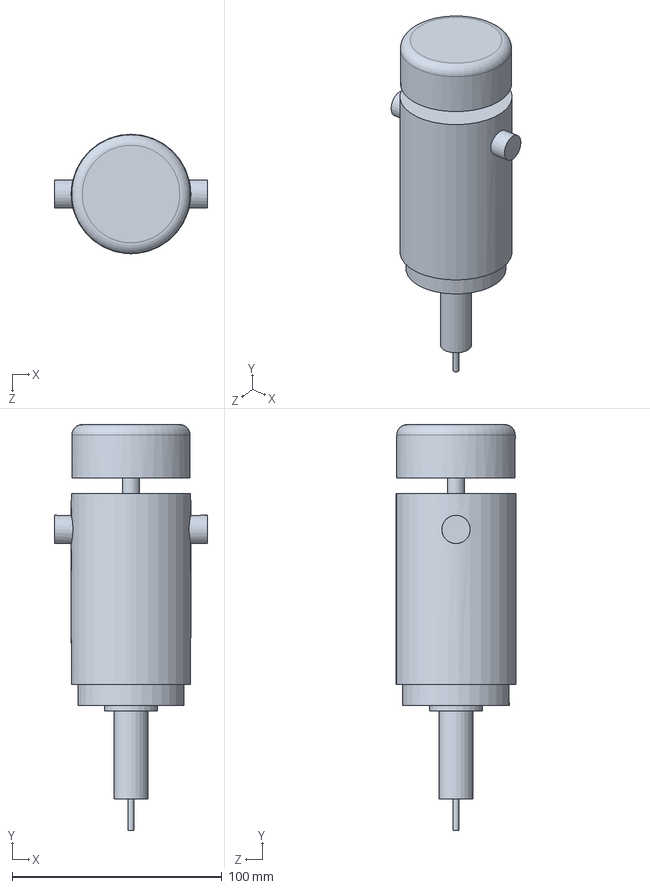
[picture p47: CAD file, 2013-03-05]
mechanical/E240-Spindle.SLDPRT
73.0 x 193.5 x 57.0 mm
