Hoektronics/Shukongji/mechanical/Bottom-Plate.SLDPRT

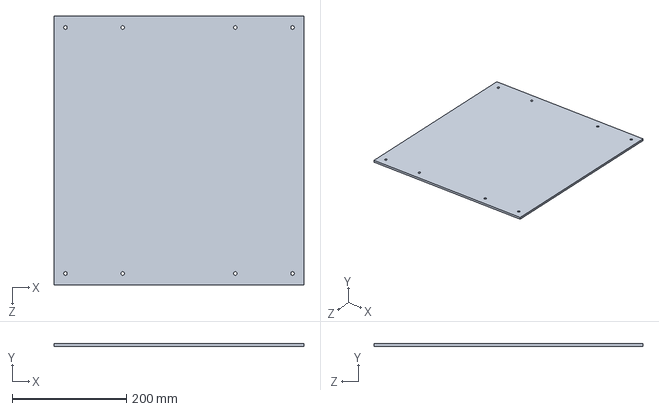
[picture p48: CAD file, 2013-03-05]
mechanical/Bottom-Plate.SLDPRT
437.0 x 5.00 x 470.0 mm
