Hoektronics/Shukongji/mechanical/Rear-Panel.SLDPRT

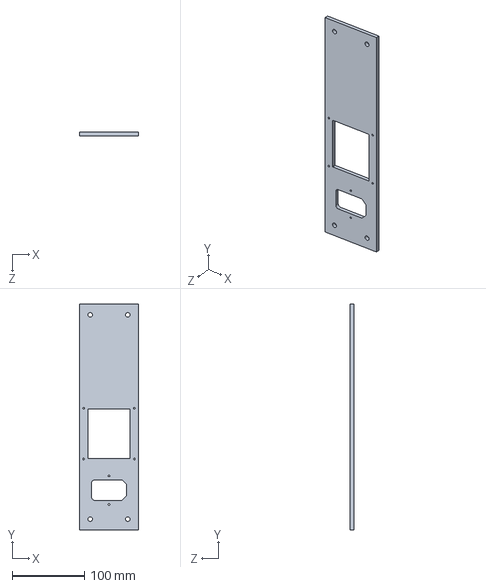
[picture p49: CAD file, 2013-03-05]
mechanical/Rear-Panel.SLDPRT
82.0 x 312.0 x 5.00 mm
