Hoektronics/Shukongji/mechanical/Spindle-Clamp.SLDPRT

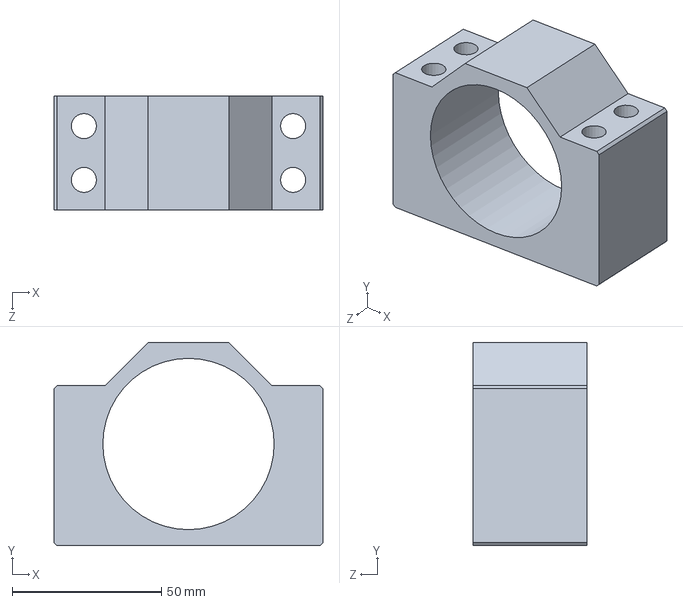
[picture p50: CAD file, 2013-03-05]
mechanical/Spindle-Clamp.SLDPRT
90.0 x 68.0 x 38.0 mm
