Hoektronics/Shukongji/mechanical/Interface-Panel.SLDPRT

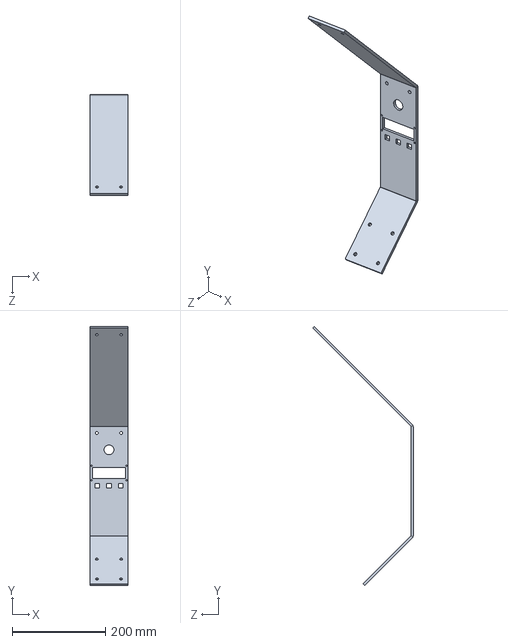
[picture p51: CAD file, 2013-03-05]
mechanical/Interface-Panel.SLDPRT
82.0 x 556.6 x 216.1 mm
