Hoektronics/Shukongji/mechanical/3-Axis-Driver.SLDPRT

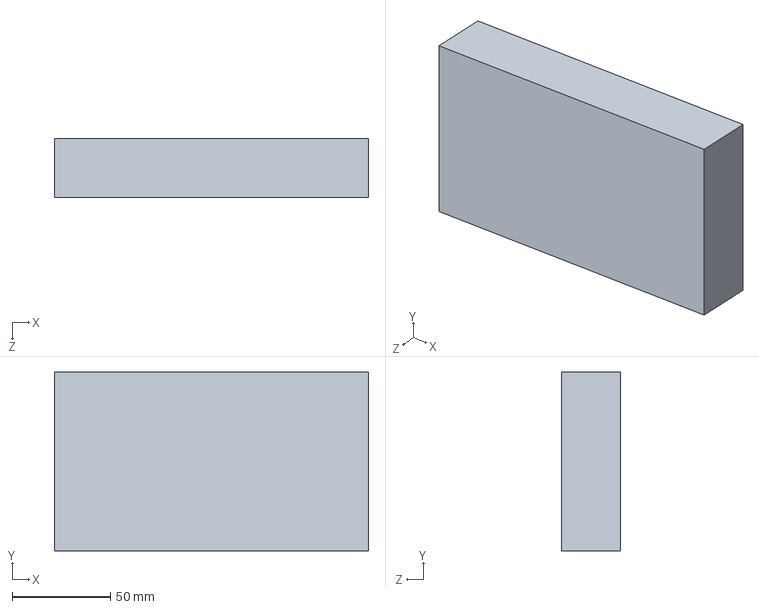
[picture p52: CAD file, 2013-03-05]
mechanical/3-Axis-Driver.SLDPRT
160.0 x 91.0 x 30.0 mm
