Hoektronics/Shukongji/mechanical/D2F-Switch.SLDPRT

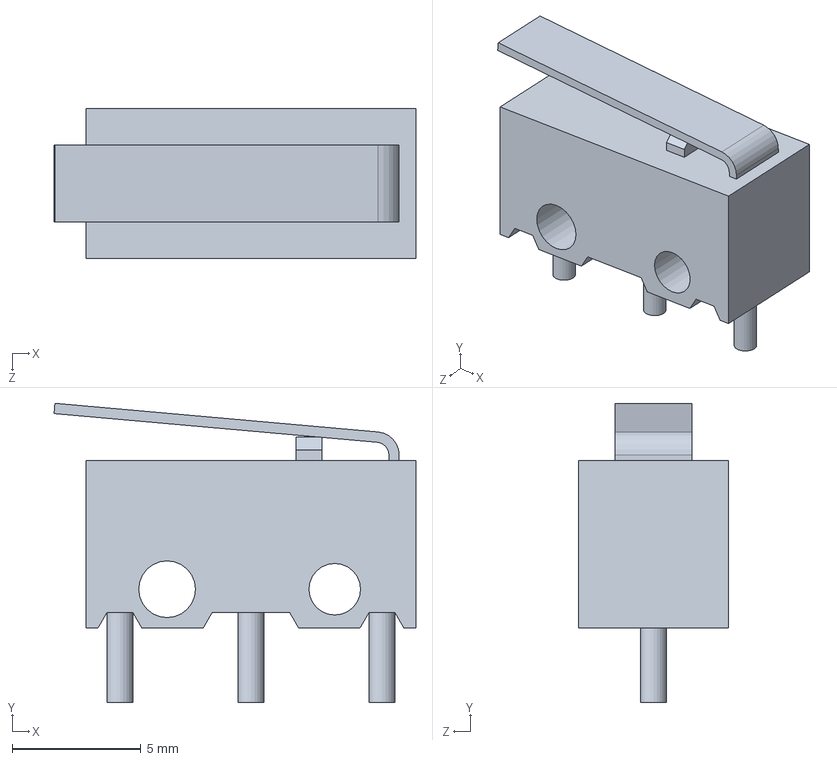
[picture p53: CAD file, 2013-03-05]
mechanical/D2F-Switch.SLDPRT
14.0 x 11.6 x 5.80 mm
