Hoektronics/Shukongji/mechanical/Y-Rod.SLDPRT

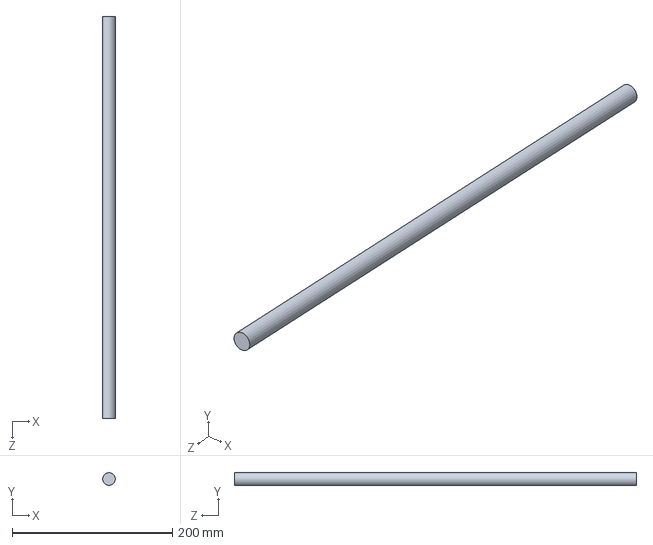
[picture p54: CAD file, 2013-03-05]
mechanical/Y-Rod.SLDPRT
16.0 x 16.0 x 502.0 mm
