Hoektronics/Shukongji/mechanical/Switch-PCB.SLDPRT

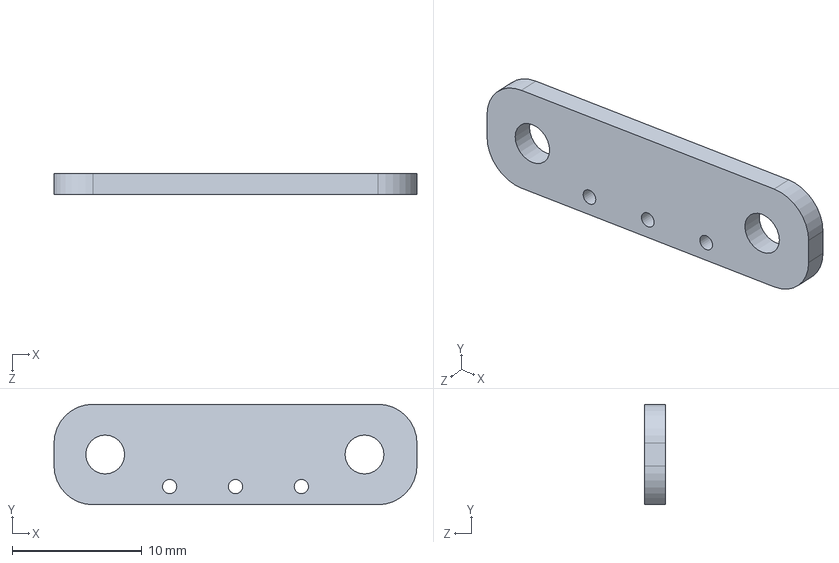
[picture p55: CAD file, 2013-03-05]
mechanical/Switch-PCB.SLDPRT
28.0 x 7.75 x 1.60 mm
