Hoektronics/Shukongji/mechanical/Y-Plate-Rear.SLDPRT

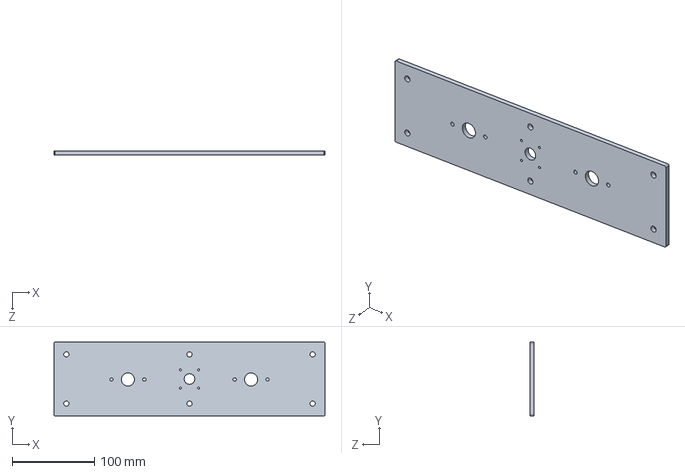
[picture p56: CAD file, 2013-03-05]
mechanical/Y-Plate-Rear.SLDPRT
330.0 x 90.0 x 5.00 mm
