Hoektronics/Shukongji/mechanical/SHF16.SLDPRT

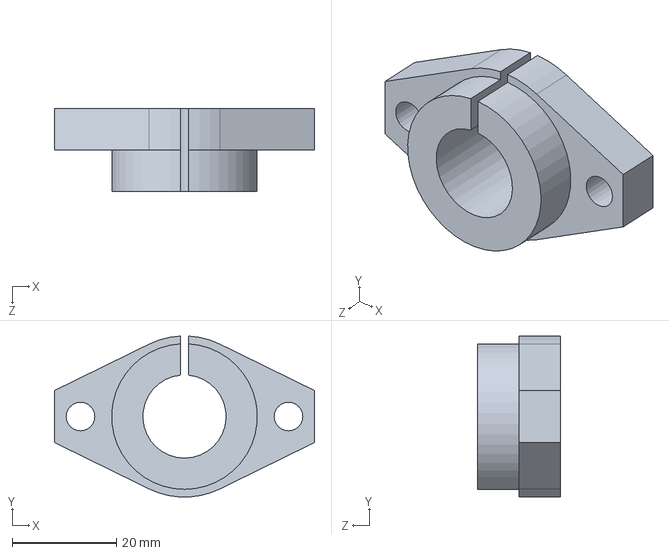
[picture p57: CAD file, 2013-03-05]
mechanical/SHF16.SLDPRT
50.0 x 30.9 x 16.0 mm
