Hoektronics/Shukongji/mechanical/Z-Rod.SLDPRT

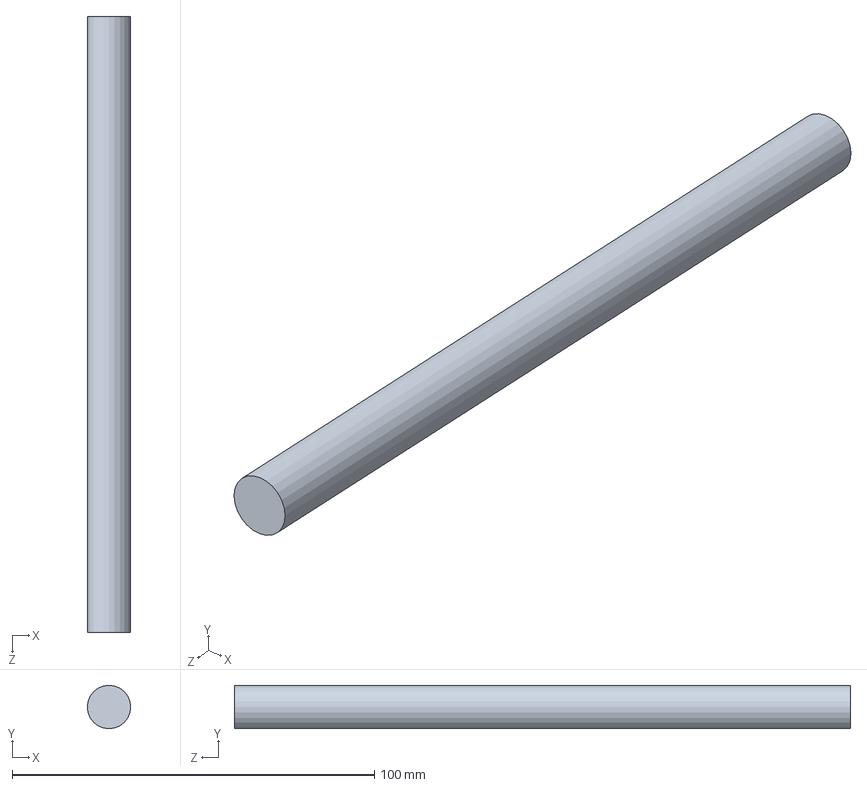
[picture p58: CAD file, 2013-03-05]
mechanical/Z-Rod.SLDPRT
12.0 x 12.0 x 170.0 mm
