Hoektronics/Shukongji/mechanical/LED-Strip.SLDPRT

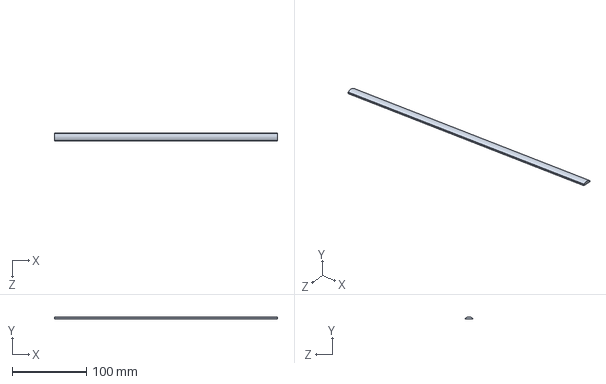
[picture p59: CAD file, 2013-03-05]
mechanical/LED-Strip.SLDPRT
300.0 x 3.04 x 10.1 mm
