Hoektronics/Shukongji/mechanical/Power-Socket.SLDPRT

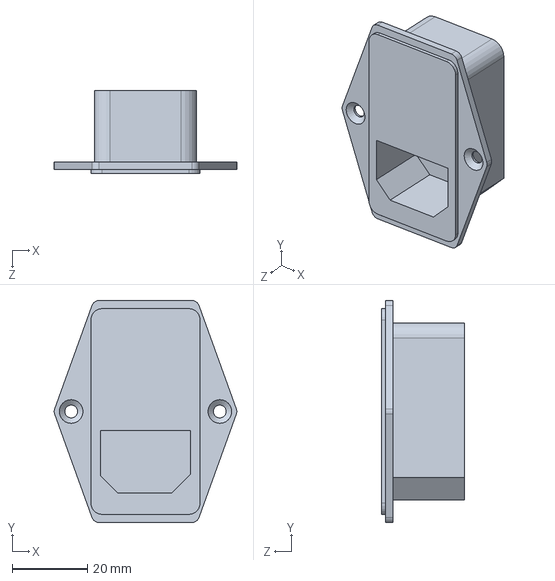
[picture p60: CAD file, 2013-03-05]
mechanical/Power-Socket.SLDPRT
48.5 x 59.0 x 22.0 mm
