Hoektronics/Shukongji/mechanical/LCD.SLDPRT

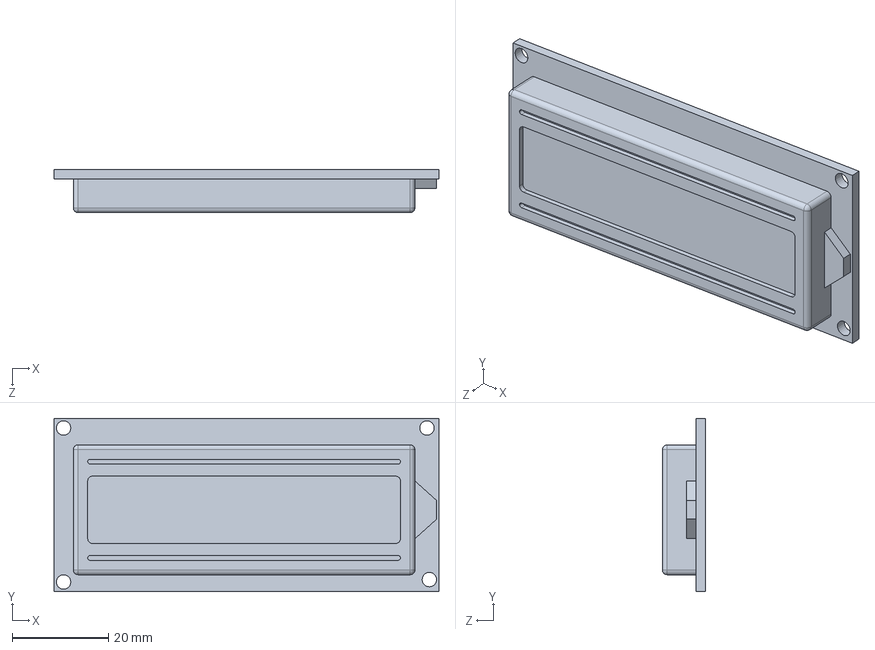
[picture p61: CAD file, 2013-03-01]
mechanical/LCD.SLDPRT
80.0 x 36.0 x 9.00 mm
