Hoektronics/Shukongji/mechanical/Electronics-Board.SLDPRT

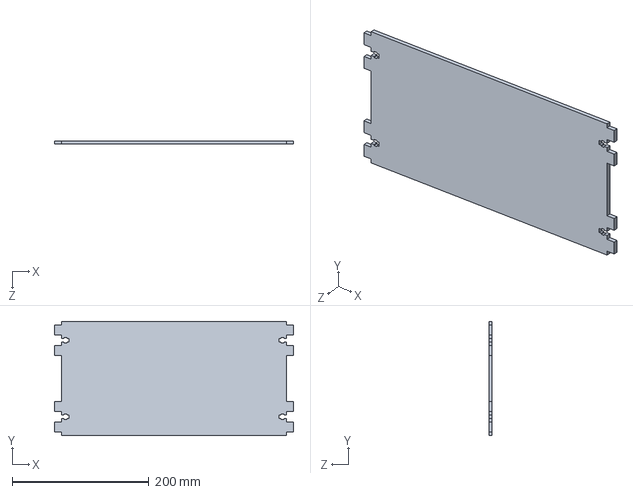
[picture p62: CAD file, 2012-12-17]
mechanical/Electronics-Board.SLDPRT
350.0 x 167.0 x 5.00 mm
