Hoektronics/Shukongji/mechanical/Right-Side.SLDPRT

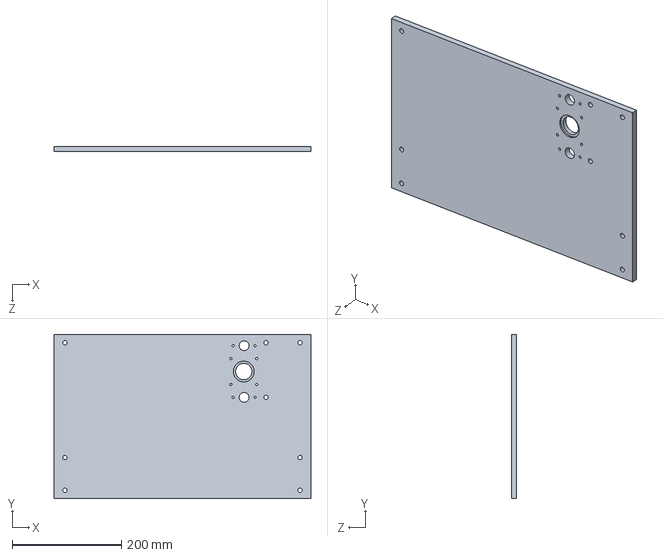
[picture p63: CAD file, 2012-11-27]
mechanical/Right-Side.SLDPRT
470.0 x 300.0 x 10.0 mm
