Hoektronics/Shukongji/mechanical/Frame-Rear-Brace.SLDPRT

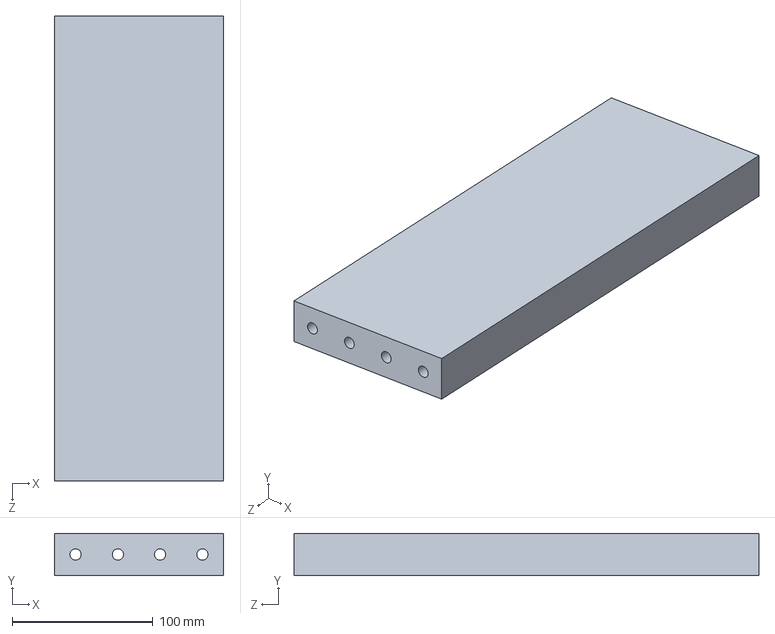
[picture p64: CAD file, 2012-11-16]
mechanical/Frame-Rear-Brace.SLDPRT
120.0 x 30.0 x 330.0 mm
