Hoektronics/Shukongji/mechanical/X-Plate.SLDPRT

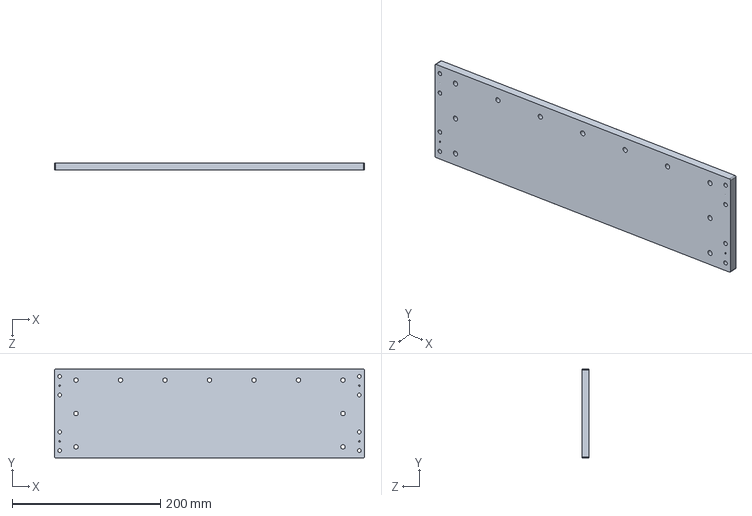
[picture p65: CAD file, 2012-11-06]
mechanical/X-Plate.SLDPRT
418.0 x 120.0 x 10.0 mm
