Hoektronics/Shukongji/mechanical/606-Bearing-Mount.SLDPRT

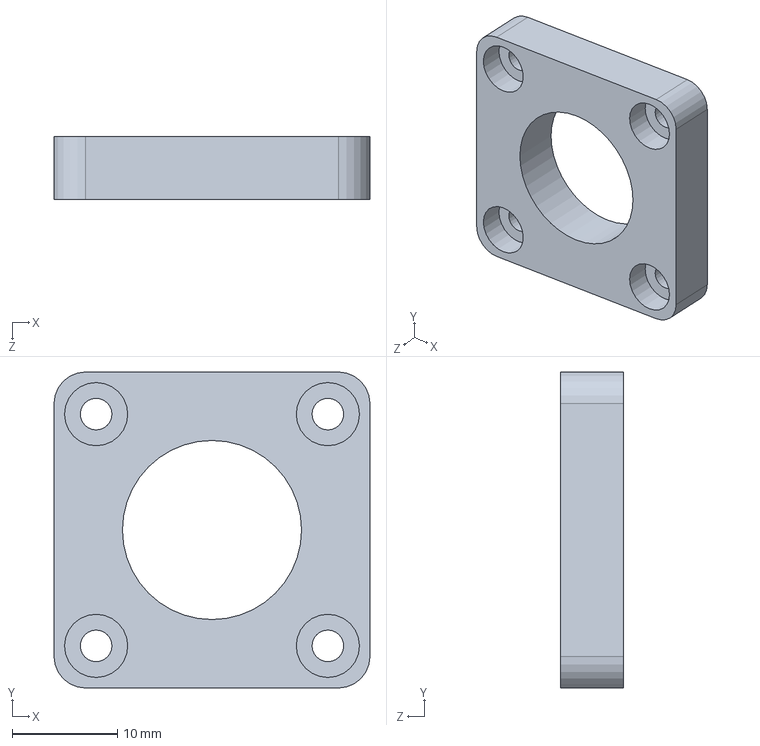
[picture p66: CAD file, 2012-11-06]
mechanical/606-Bearing-Mount.SLDPRT
30.0 x 30.0 x 6.00 mm
