Hoektronics/Shukongji/mechanical/Frame-Vertical-Column.SLDPRT

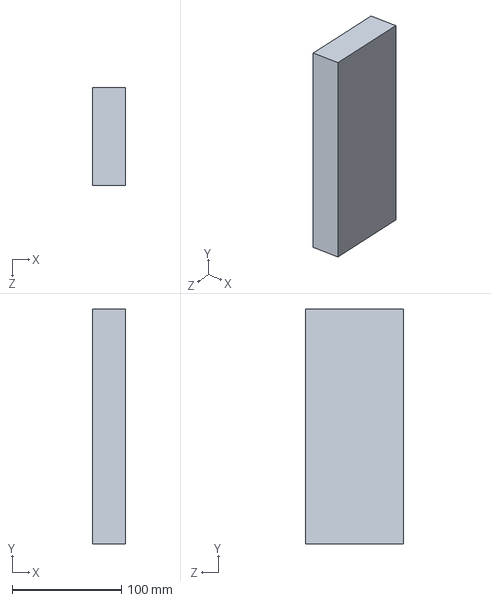
[picture p67: CAD file, 2012-11-02]
mechanical/Frame-Vertical-Column.SLDPRT
30.0 x 215.0 x 90.0 mm
