Hoektronics/Shukongji/mechanical/Frame-Base-Length.SLDPRT

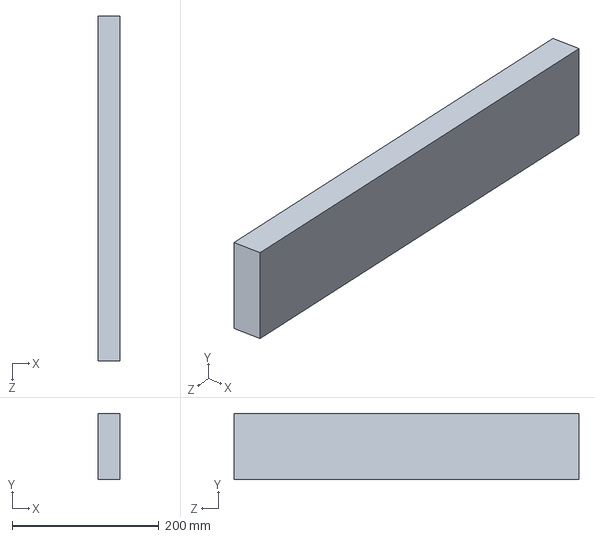
[picture p68: CAD file, 2012-10-28]
mechanical/Frame-Base-Length.SLDPRT
30.0 x 90.0 x 470.0 mm
