Hoektronics/Shukongji/mechanical/3030-Corner.SLDPRT

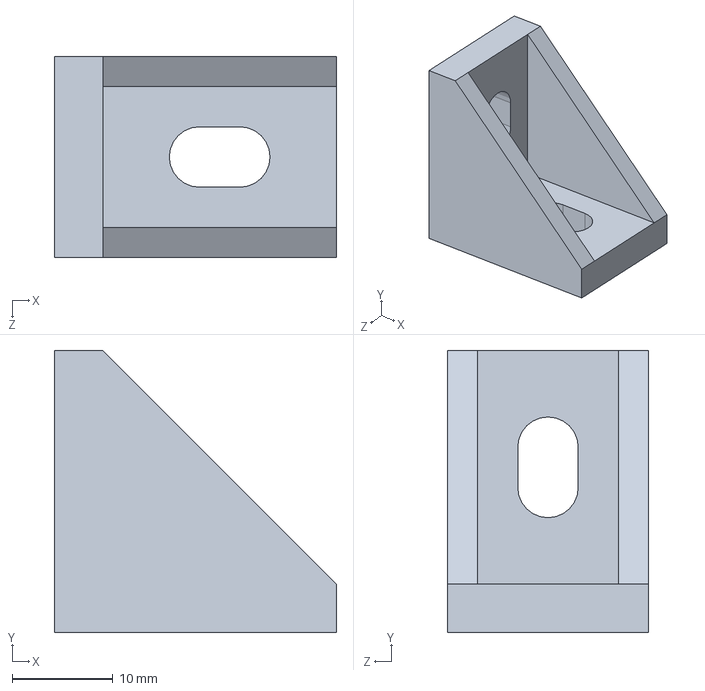
[picture p69: CAD file, 2012-10-28]
mechanical/3030-Corner.SLDPRT
28.0 x 28.0 x 20.0 mm
