Hoektronics/Shukongji/mechanical/Frame-Front-Column.SLDPRT

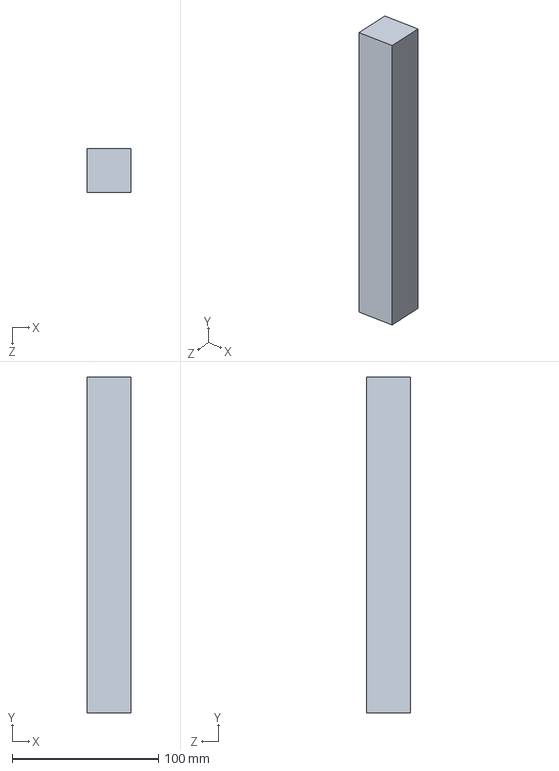
[picture p70: CAD file, 2012-10-15]
mechanical/Frame-Front-Column.SLDPRT
30.0 x 230.0 x 30.0 mm
