Hoektronics/Shukongji/mechanical/Frame-Top-Column.SLDPRT

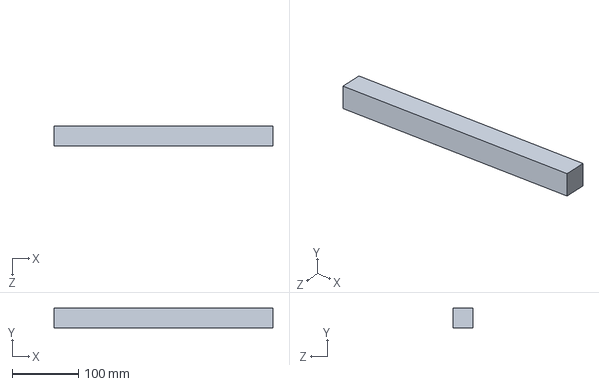
[picture p71: CAD file, 2012-10-15]
mechanical/Frame-Top-Column.SLDPRT
330.0 x 30.0 x 30.0 mm
