Hoektronics/Shukongji/mechanical/Radial-Bearing-Vertical.SLDPRT

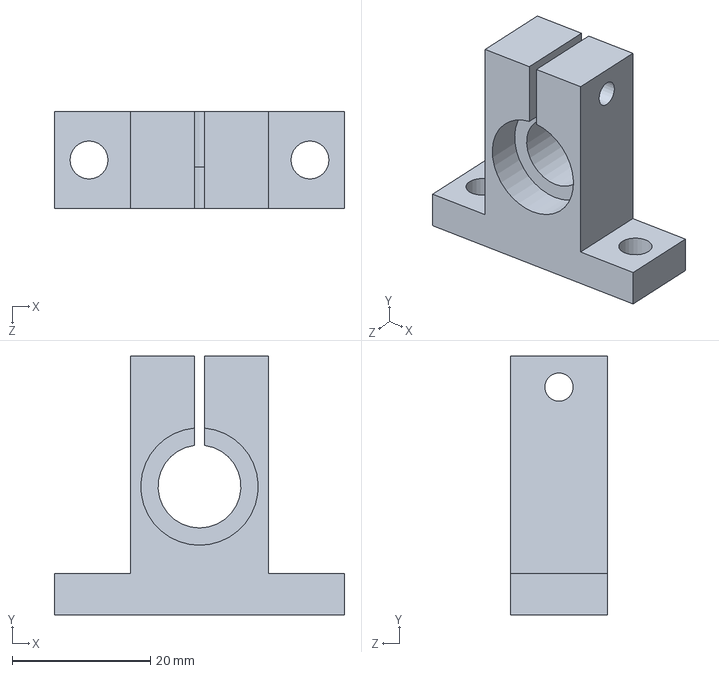
[picture p72: CAD file, 2012-10-12]
mechanical/Radial-Bearing-Vertical.SLDPRT
42.0 x 37.5 x 14.0 mm
