Hoektronics/Shukongji/mechanical/X-Stage.SLDPRT

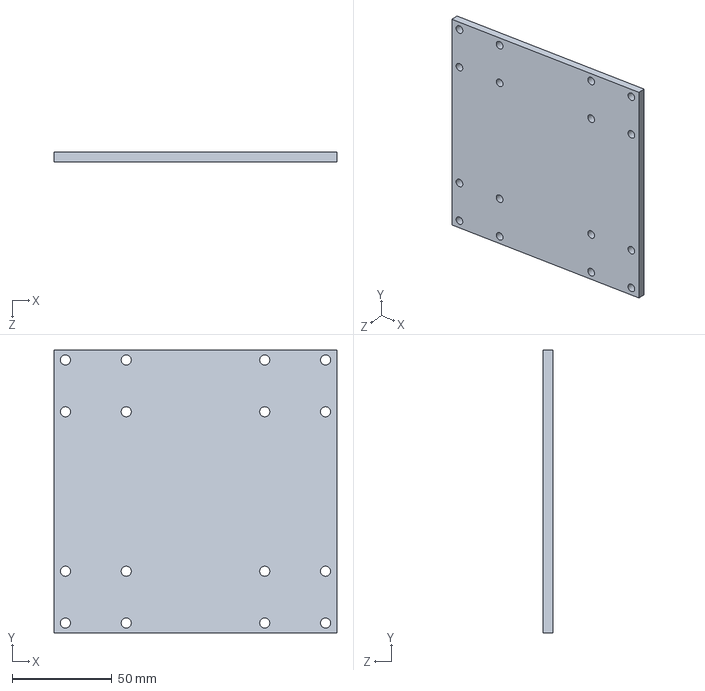
[picture p73: CAD file, 2012-10-12]
mechanical/X-Stage.SLDPRT
142.0 x 142.0 x 5.00 mm
