Hoektronics/Shukongji/mechanical/Optical-Encoder.SLDPRT

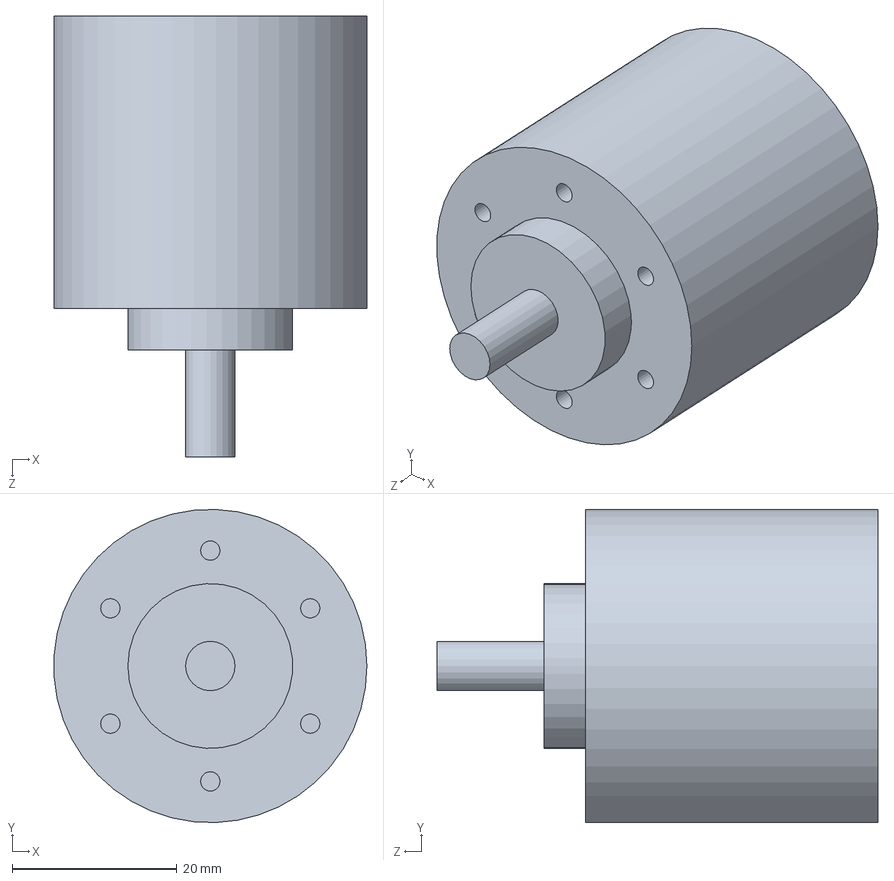
[picture p74: CAD file, 2012-10-09]
mechanical/Optical-Encoder.SLDPRT
38.0 x 38.0 x 53.5 mm
