Hoektronics/Shukongji/mechanical/nema17.SLDPRT

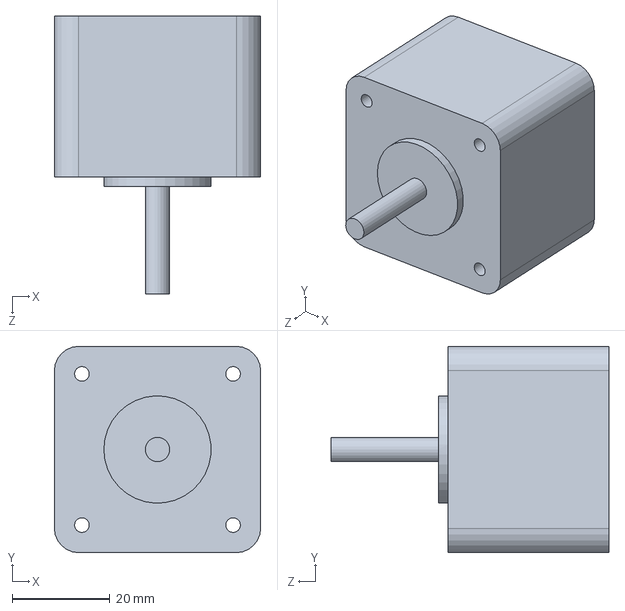
[picture p75: CAD file, 2012-10-09]
mechanical/nema17.SLDPRT
42.3 x 42.3 x 57.0 mm
