Hoektronics/Shukongji/mechanical/606ZZ.SLDPRT

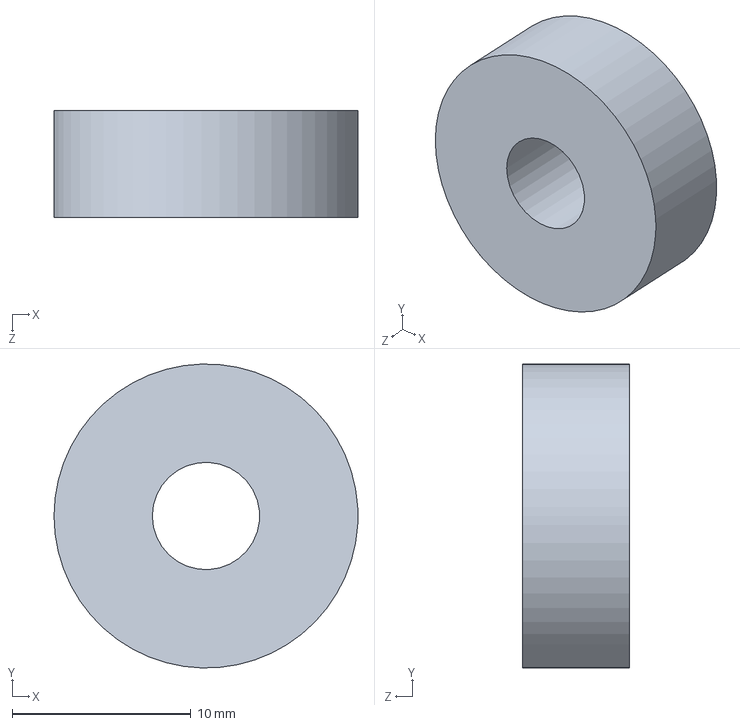
[picture p76: CAD file, 2012-10-03]
mechanical/606ZZ.SLDPRT
17.0 x 17.0 x 6.00 mm
