Hoektronics/Shukongji/mechanical/SHF12.SLDPRT

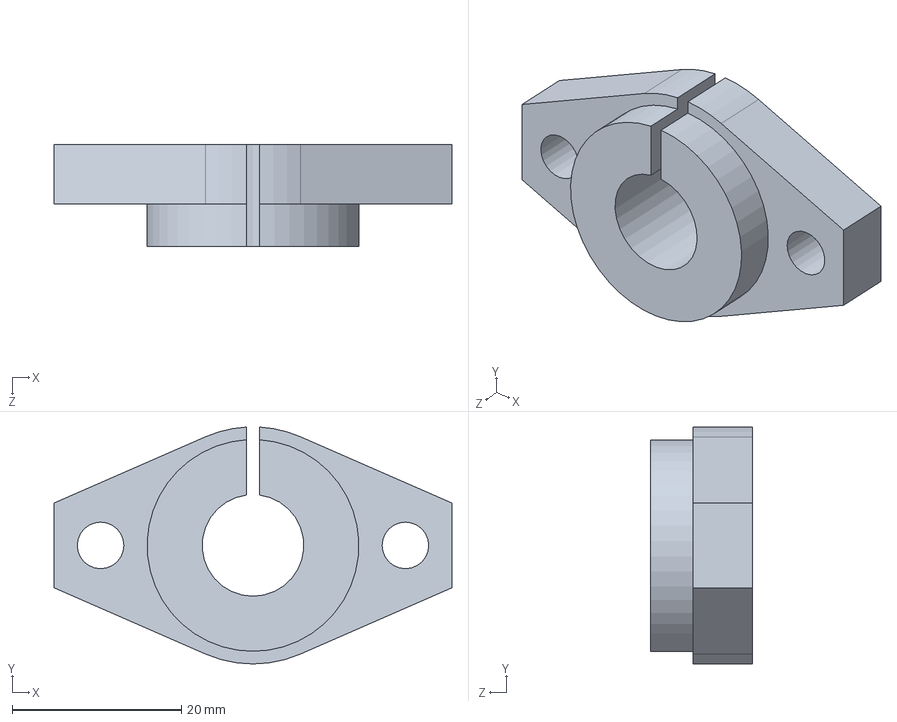
[picture p77: CAD file, 2012-10-03]
mechanical/SHF12.SLDPRT
47.0 x 28.0 x 12.0 mm
