Hoektronics/Shukongji/(list of files, cad)

Other CAD files:
mechanical/Hand-Wheel.SLDPRT
mechanical/SFU1204-Nut-Mount.SLDDRW
mechanical/SFU1204-Nut-Mount.SLDPRT
mechanical/SFU1204-Nut.SLDPRT
mechanical/SFUXXXX-Ball-Screw.SLDDRW
mechanical/SFUXXXX-Ball-Screw.SLDPRT
mechanical/Side-Panel.SLDDRW
mechanical/X-Plate.SLDDRW
mechanical/X-Rod.SLDDRW
mechanical/XY-Motor-Mount.SLDDRW
mechanical/Y-Plate-Front.SLDDRW
mechanical/Y-Plate-Rear.SLDDRW
mechanical/Y-Rod.SLDDRW
mechanical/Y-Stage-Plate.SLDDRW
mechanical/Y-Stage.SLDDRW
mechanical/Y-Stage.SLDPRT
mechanical/Z-Plate.SLDDRW
mechanical/Z-Rod.SLDDRW
mechanical/Z-Stage.SLDDRW
mechanical/Z-Stage.SLDPRT
