Hoektronics/Shukongji/scripts/pcb-gcode-3.6.0.1/todo.txt

* add milling feedrate from preferences.
