Hoektronics/Shukongji/electronics/interface-board/interface-board.pdf

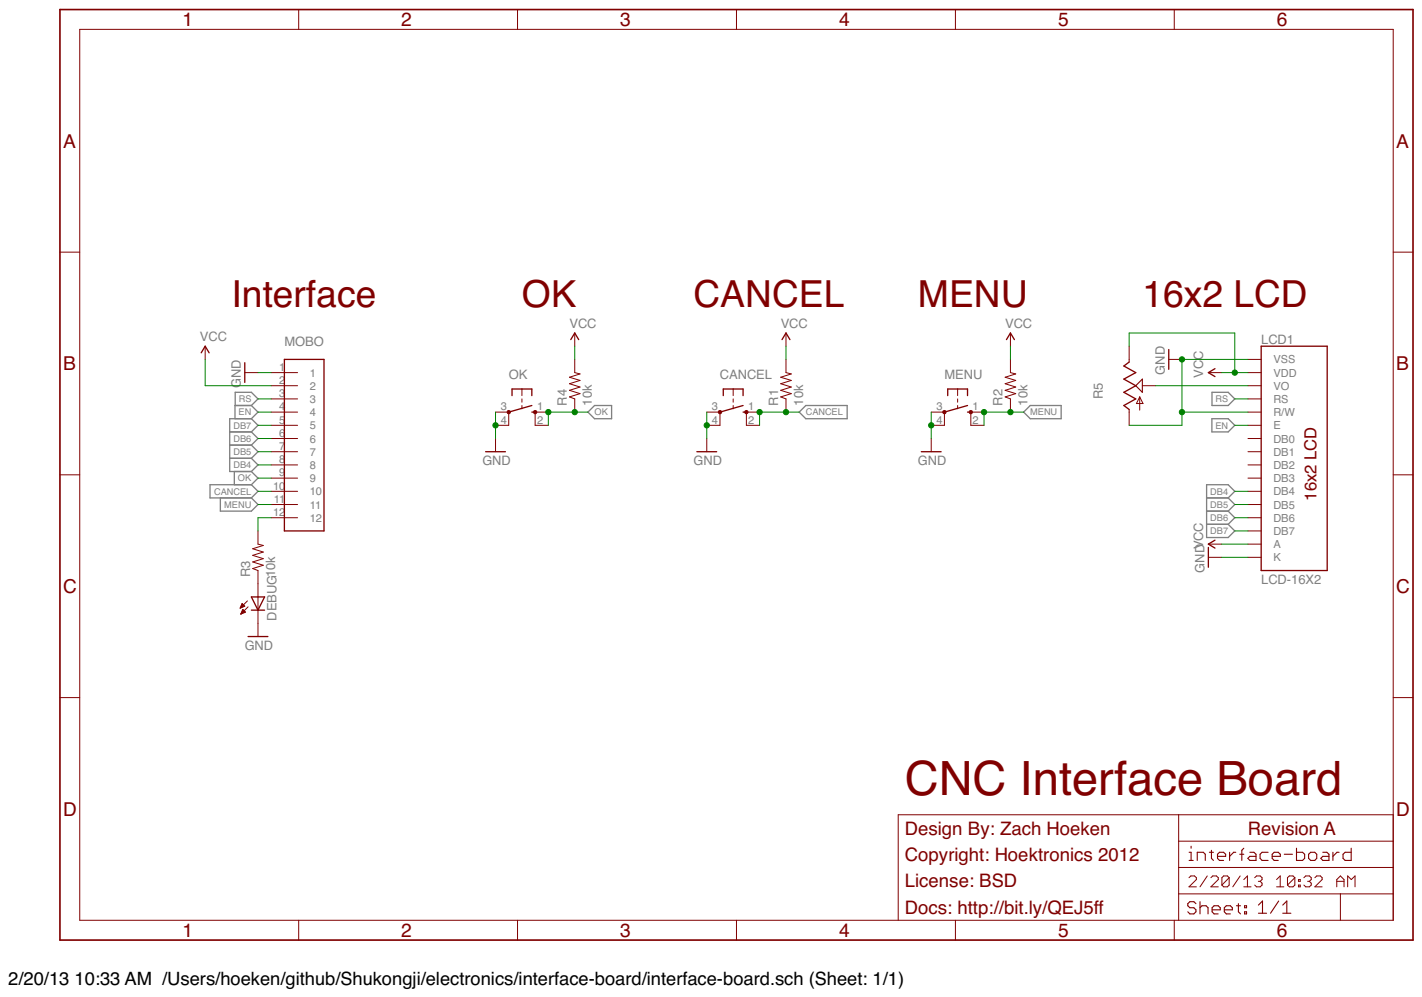
[picture p78: page 1]

Design By: Zach Hoeken
Copyright: Hoektronics 2012
License: BSD
Docs: http://bit.ly/QEJ5ff

2/20/13 10:33 AM /Users/hoeken/github/Shukongji/electronics/interface-board/interface-board.sch (Sheet: 1/1)
