Hoektronics/Shukongji/electronics/hoekdrive23/hoekdrive23.pdf

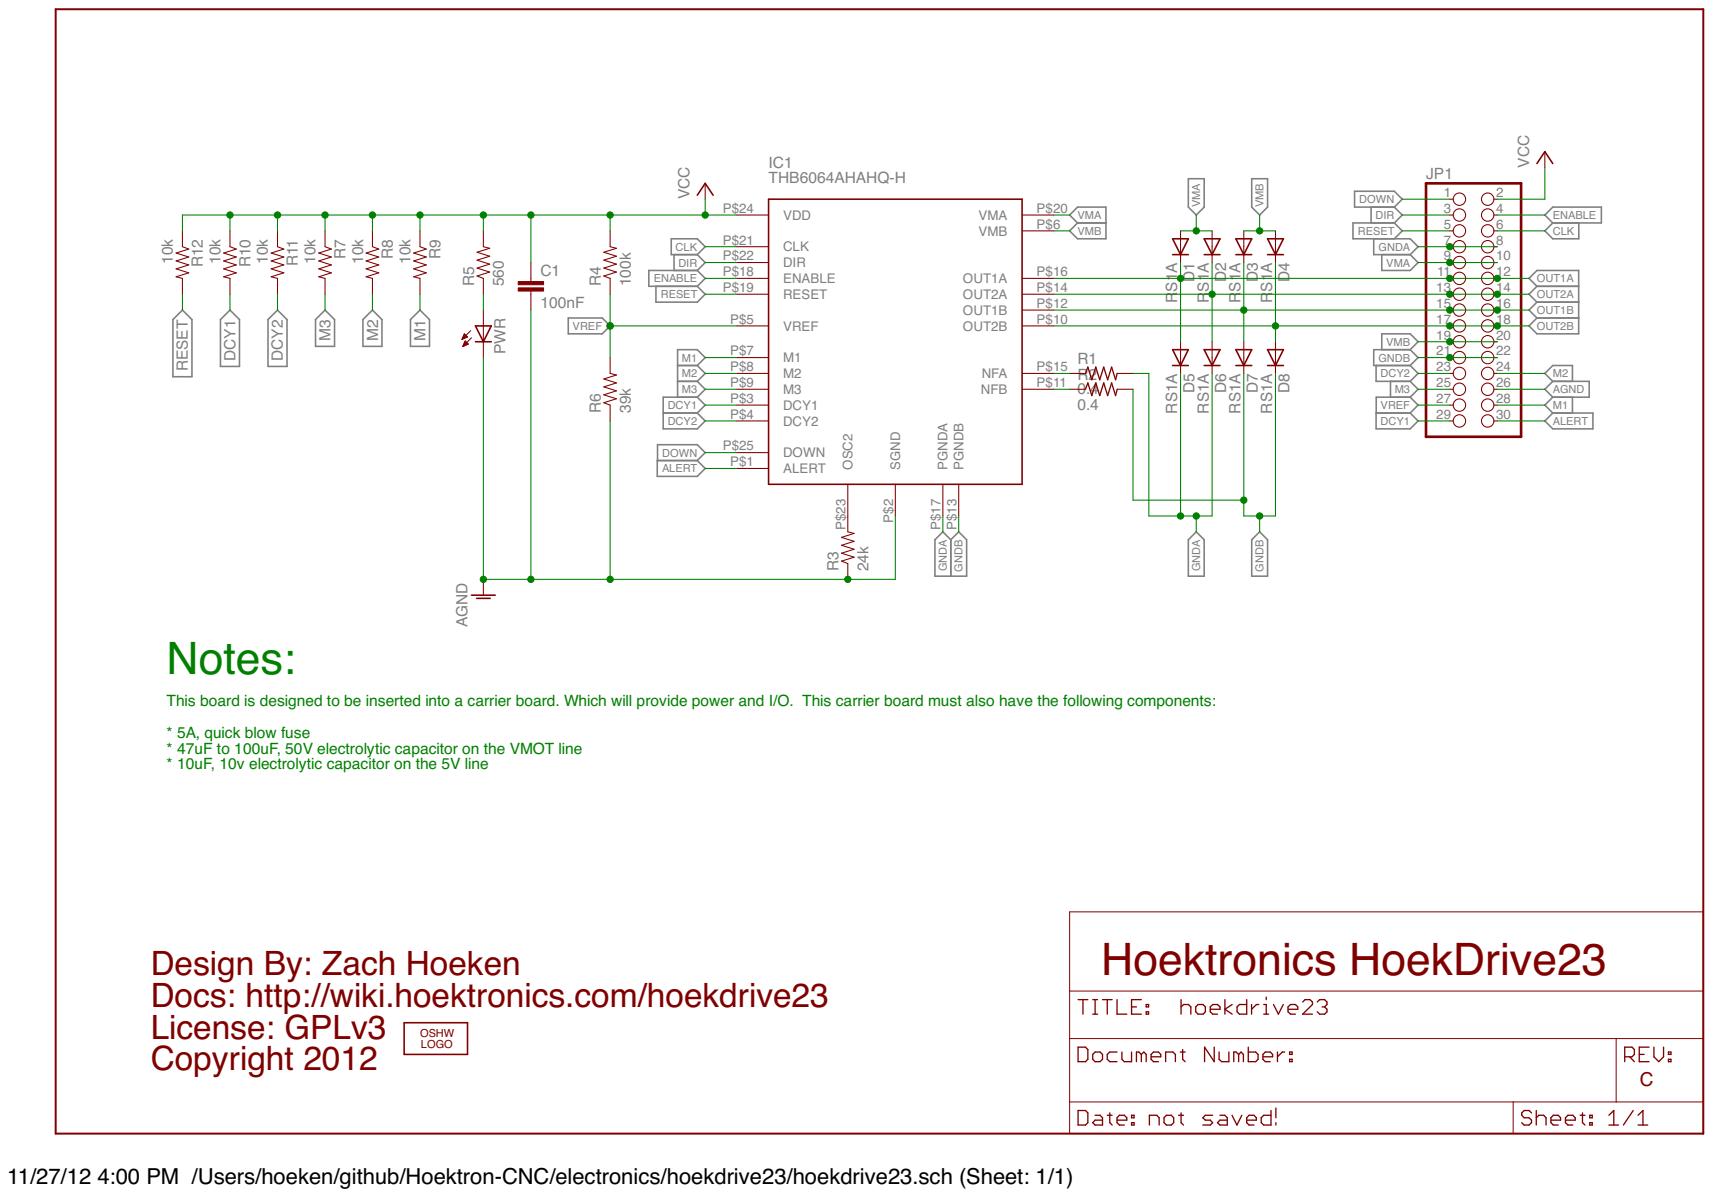
[picture p79: page 1]

This board is designed to be inserted into a carrier board. Which will provide power and I/O. This carrier board must also have the following components: * 5A, quick blow fuse

* 47uF to 100uF, 50V electrolytic capacitor on the VMOT line
* 10uF, 10v electrolytic capacitor on the 5V line

Design By: Zach Hoeken
Docs: http://wiki.hoektronics.com/hoekdrive23
License: GPLv3
Copyright 2012

11/27/12 4:00 PM /Users/hoeken/github/Hoektron-CNC/electronics/hoekdrive23/hoekdrive23.sch (Sheet: 1/1)
