Hoektronics/Shukongji/electronics/RN-131-Carrier-Board/RN-131-Carrier-Board.pdf

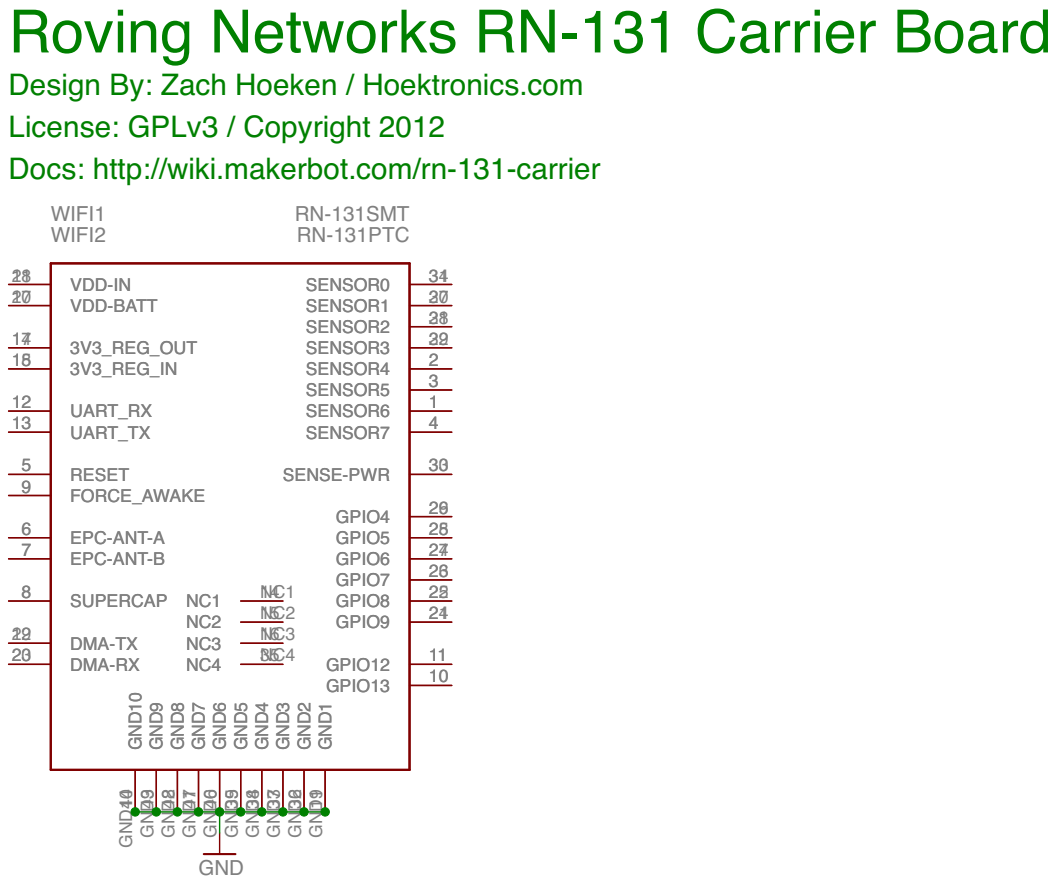
[picture p80: page 1]

Roving Networks RN-131 Carrier Board

Design By: Zach Hoeken / Hoektronics.com
License: GPLv3 / Copyright 2012
Docs: http://wiki.makerbot.com/rn-131-carrier
