Hoektronics/Shukongji/electronics/tachometer/tachometer.pdf

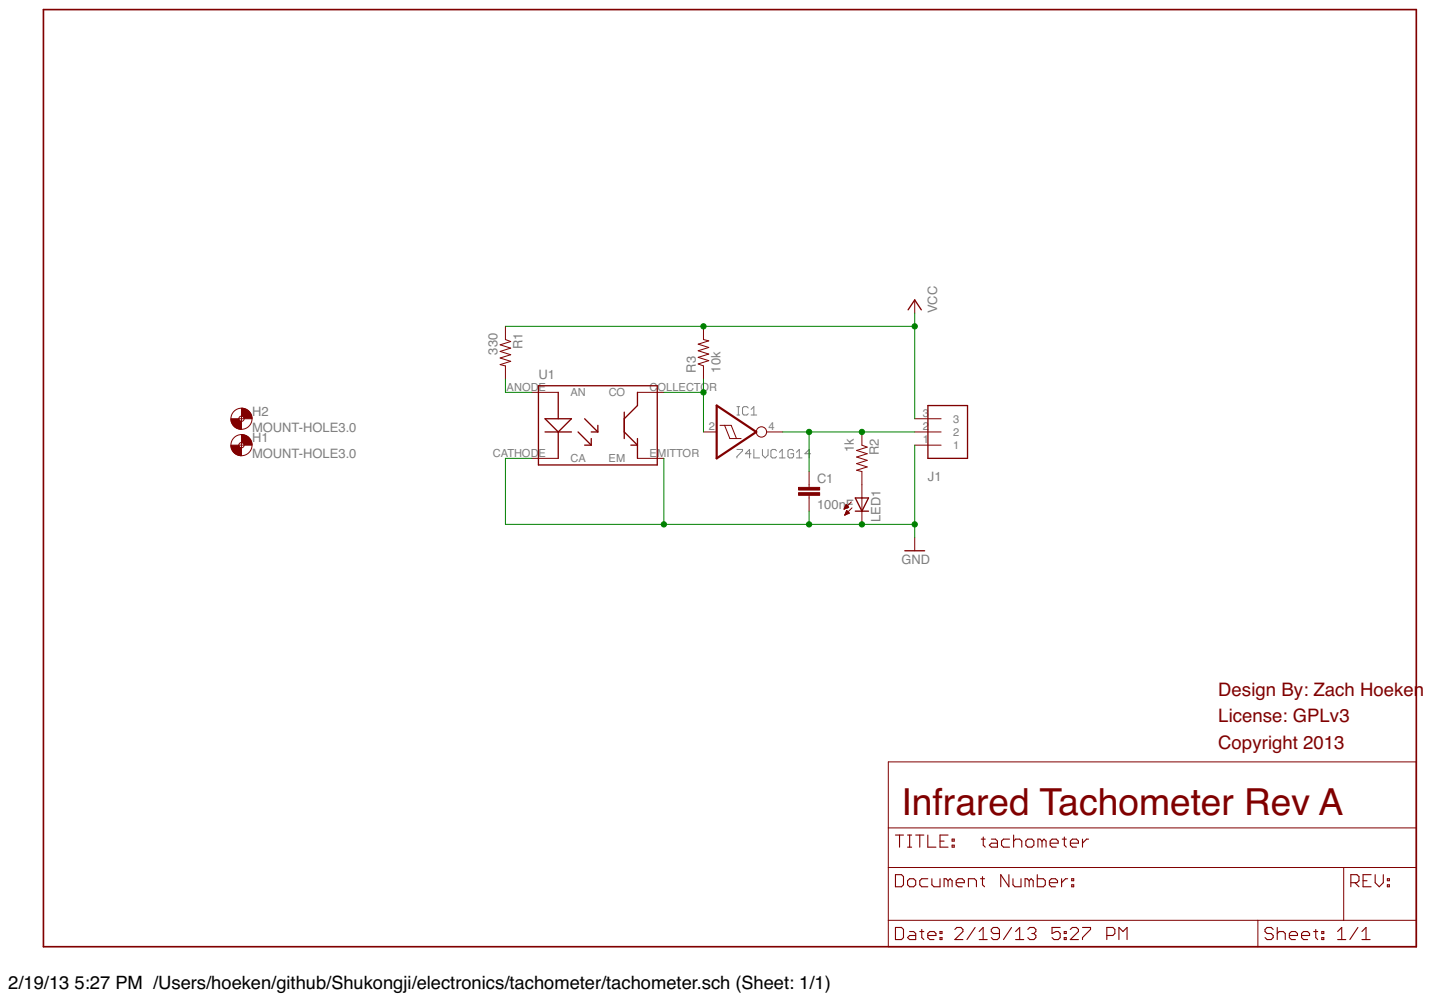
[picture p81: page 1]

Design By: Zach Hoeken
License: GPLv3
Copyright 2013

2/19/13 5:27 PM /Users/hoeken/github/Shukongji/electronics/tachometer/tachometer.sch (Sheet: 1/1)
