Hoektronics/Shukongji/electronics/MAX6675-Breakout/MAX6675-Breakout.pdf

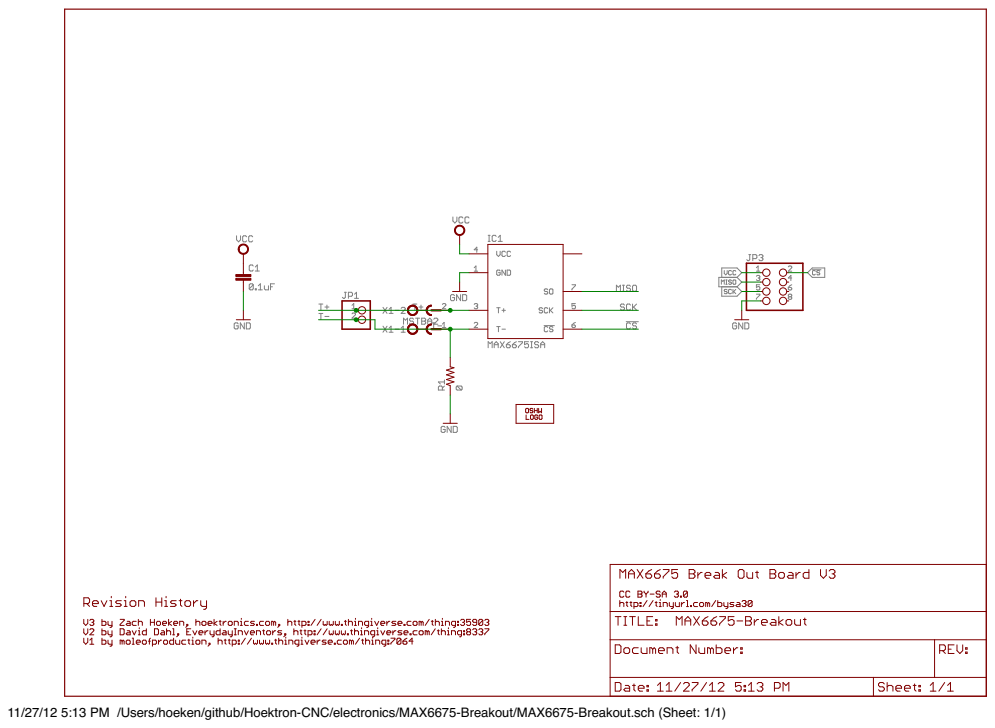
[picture p82: page 1]

11/27/12 5:13 PM /Users/hoeken/github/Hoektron-CNC/electronics/MAX6675-Breakout/MAX6675-Breakout.sch (Sheet: 1/1)
