Hoektronics/Shukongji/electronics/hoekdrive17/hoekdrive17.pdf

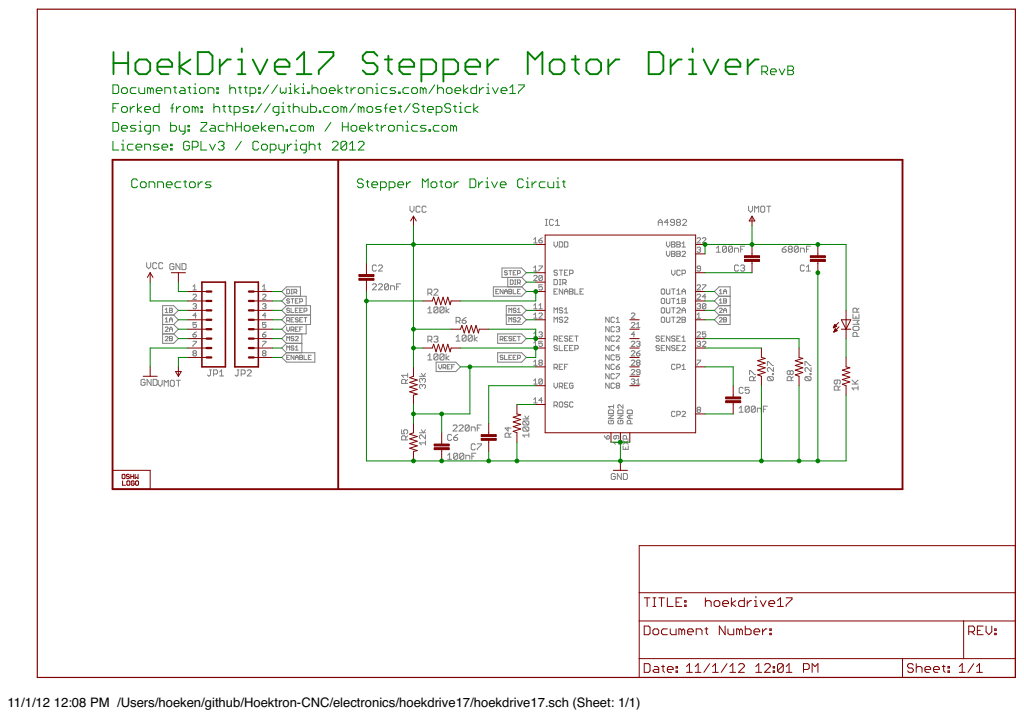
[picture p83: page 1]

11/1/12 12:08 PM /Users/hoeken/github/Hoektron-CNC/electronics/hoekdrive17/hoekdrive17.sch (Sheet: 1/1)
