Hoektronics/Shukongji/electronics/RN-42-Carrier-Board/RN-42-Carrier-Board.pdf

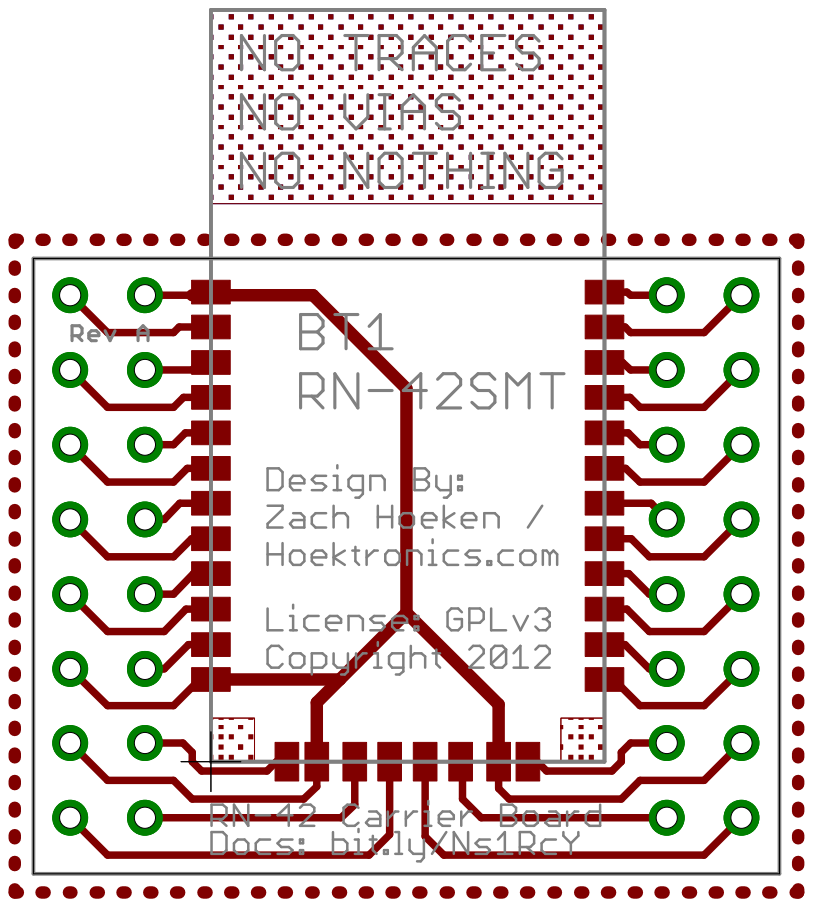
[picture p84: page 1]
