Hoektronics/Shukongji/electronics/spindle-driver/spindle-driver.brd

## EAGLE design electronics/spindle-driver/spindle-driver.brd (2013-12-12)

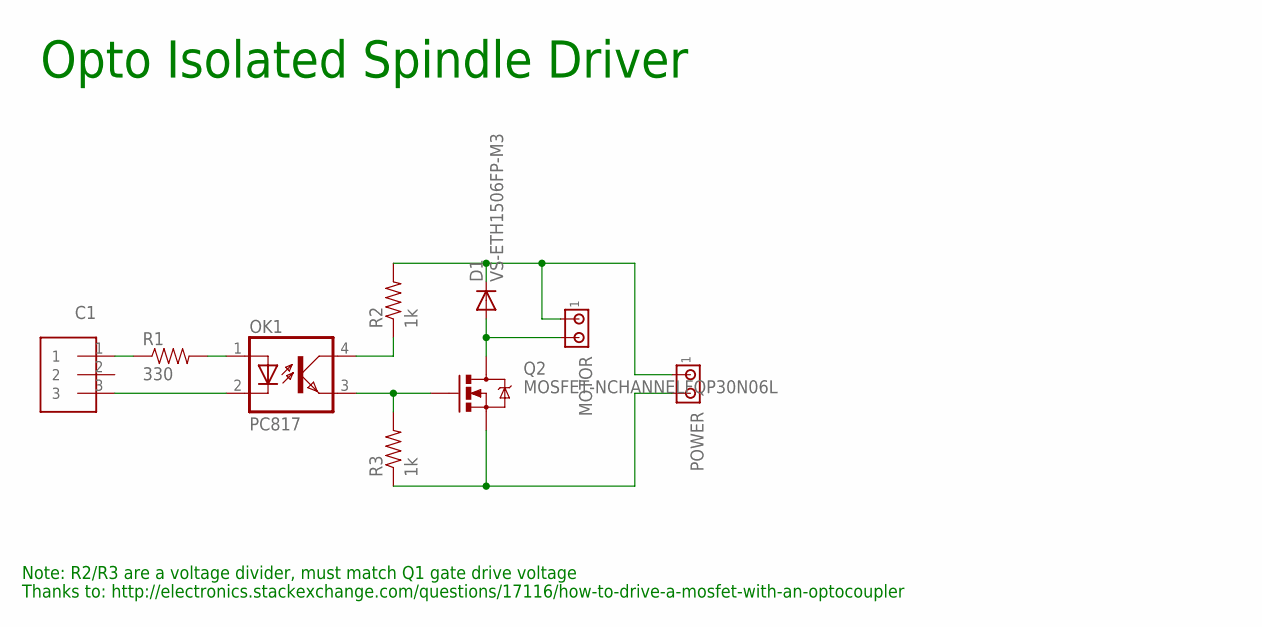
[picture p85: schematic spindle-driver.sch]

Parts:
C1: CONN-3XH-3; XH-3
D1: VS-ETH1506FP-M3; SMB
MOTOR: MTA02-156; 1X2MTA
OK1: PC817; DIL04
POWER: MTA02-156; 1X2MTA
Q2: MOSFET-NCHANNELFQP30N06L; TO220V
R1: 330; 0805-RC
R2, R3: 1k; 0805-RC

Connections:
unnamed: C1.3, OK1.2 (C)
unnamed: OK1.1 (A), R1.2
unnamed: C1.1, R1.1
unnamed: D1.C, MOTOR.1, POWER.1, R2.2
unnamed: OK1.4 (COL), R2.1
unnamed: OK1.3 (EMIT), Q2.1 (G), R3.2
unnamed: POWER.2, Q2.3 (S), R3.1
unnamed: D1.A, MOTOR.2, Q2.2 (D)

Notes on the sheet:
Thanks to: http://electronics.stackexchange.com/questions/17116/how-to-drive-a-mosfet-with-an-optocoupler
Note: R2/R3 are a voltage divider, must match Q1 gate drive voltage
Opto Isolated Spindle Driver

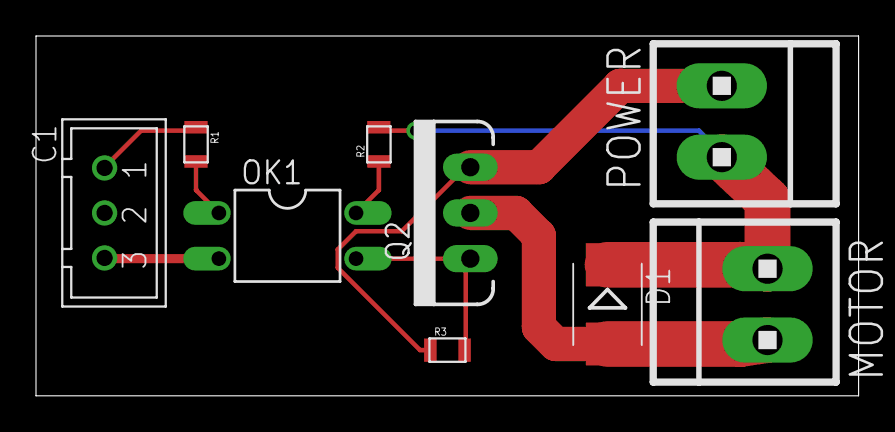
[picture p86: board spindle-driver.brd from above]

Board: 2 copper layers, 45.7 x 20.0 mm, 9 parts (0 on the bottom side), 8 nets.
