Hoektronics/Shukongji/electronics/interface-board/interface-board.brd

## EAGLE design electronics/interface-board/interface-board.brd (2013-12-12)

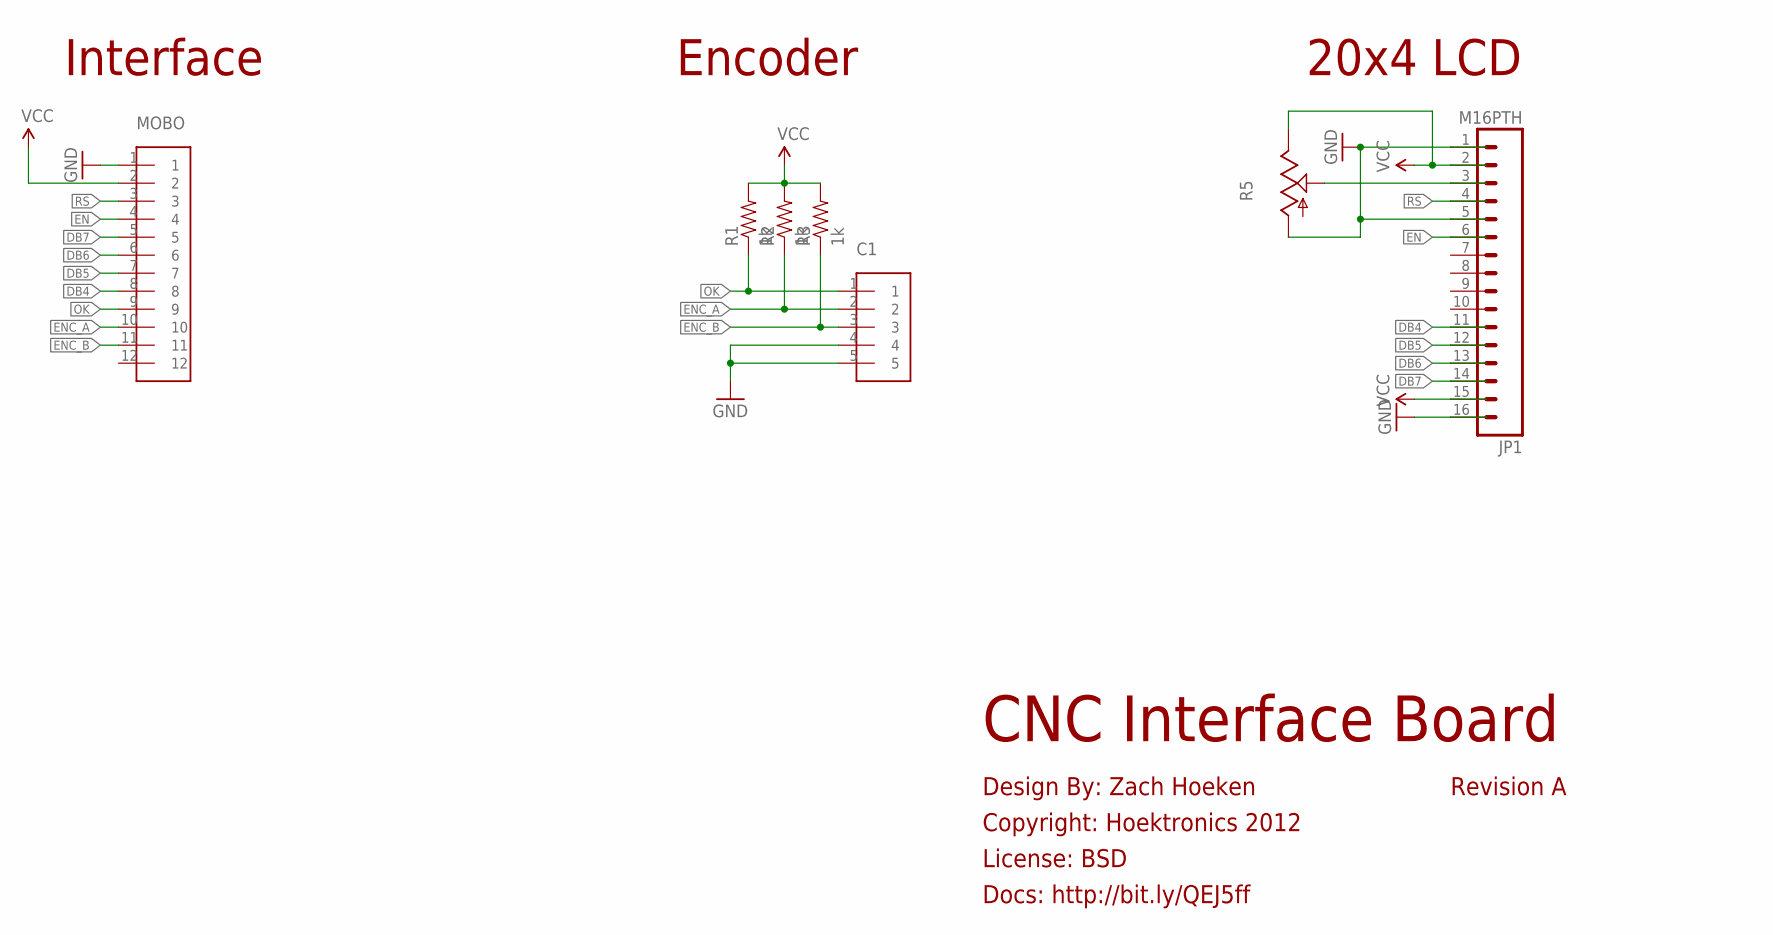
[picture p87: schematic interface-board.sch]

Parts:
C1: CONN-5; XH-5
JP1: M16PTH; 1X16
MOBO: CONN-12; XH-12
R1, R2, R3: 1k; 0805-RC
R5: TRIM_US-B25P; B25P

Connections:
DB4: JP1.11, MOBO.8
DB5: JP1.12, MOBO.7
DB6: JP1.13, MOBO.6
DB7: JP1.14, MOBO.5
EN: JP1.6, MOBO.4
ENC_A: C1.2, MOBO.10, R2.1
ENC_B: C1.3, MOBO.11, R3.1
GND: C1.4, C1.5, JP1.1, JP1.5, JP1.16, MOBO.1, R5.A
unnamed: JP1.3, R5.S
OK: C1.1, MOBO.9, R1.1
RS: JP1.4, MOBO.3
VCC: JP1.2, JP1.15, MOBO.2, R1.2, R2.2, R3.2, R5.E

Notes on the sheet:
CNC Interface Board
Docs: http://bit.ly/QEJ5ff
License: BSD
Copyright: Hoektronics 2012
Design By: Zach Hoeken
20x4 LCD
Revision A
Interface
Encoder

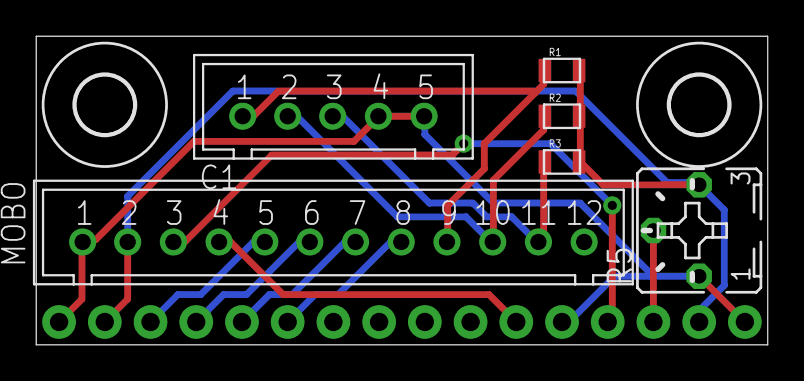
[picture p88: board interface-board.brd from above]

Board: 2 copper layers, 40.6 x 17.1 mm, 9 parts (1 on the bottom side), 12 nets.

Other parts of the board:
U$1, U$2: 3,2
