Hoektronics/Shukongji/electronics/cnc-controller/cnc-controller.brd

## EAGLE design electronics/cnc-controller/cnc-controller.brd (2013-12-12)

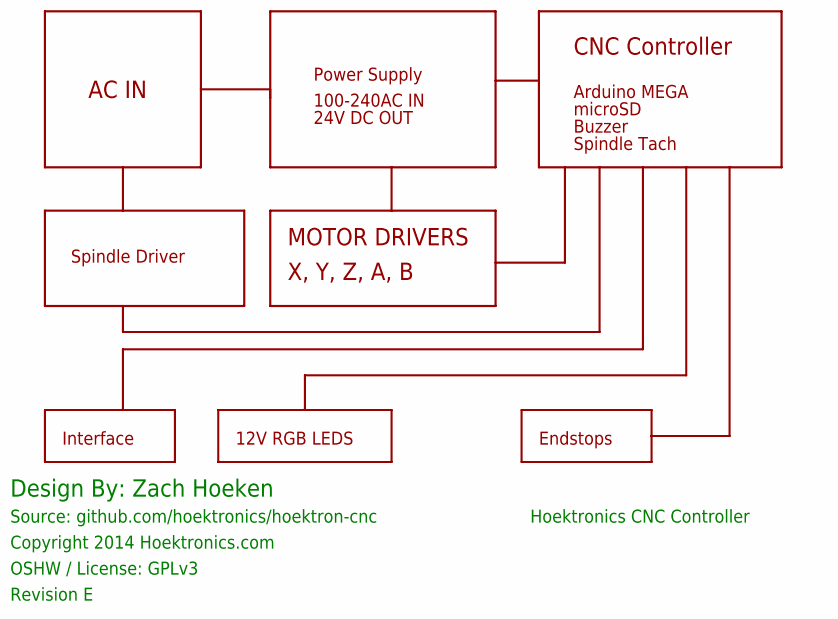
[picture p89: schematic cnc-controller.sch, sheet 1]

Notes on the sheet:
Hoektronics CNC Controller
Design By: Zach Hoeken
Source: github.com/hoektronics/hoektron-cnc
Copyright 2014 Hoektronics.com
Power Supply
X, Y, Z, A, B
CNC Controller
microSD
Endstops
Buzzer
OSHW / License: GPLv3
12V RGB LEDS
24V DC OUT
Interface
Revision E
Arduino MEGA
100-240AC IN
AC IN
MOTOR DRIVERS
Spindle Tach
Spindle Driver

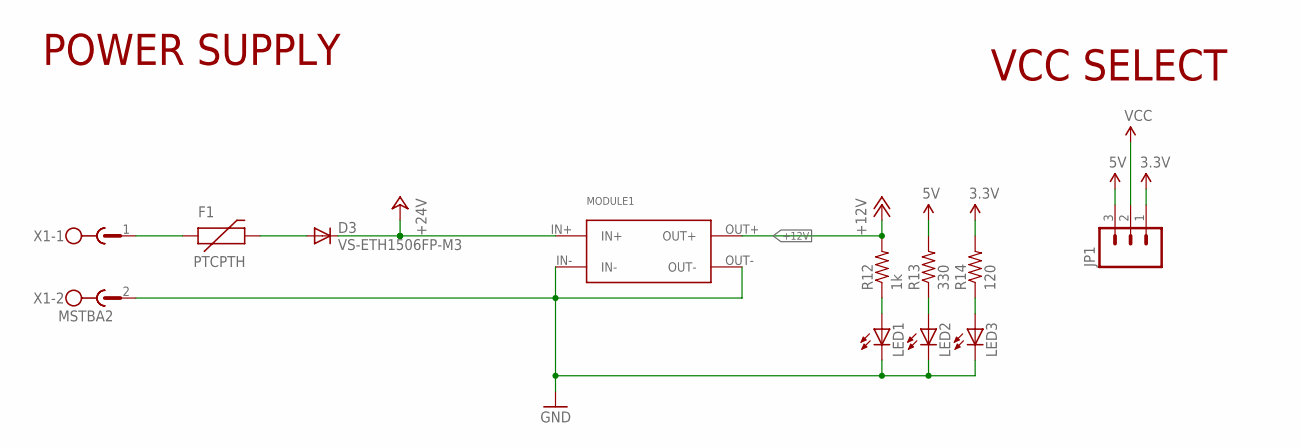
[picture p90: schematic cnc-controller.sch, sheet 2]

Parts:
D3: VS-ETH1506FP-M3; SMB
F1: PTCPTH; PTC
JP1: M03PTH; 1X03
LED1, LED2, LED3: LED0805; 0805-LED
MODULE1: DC-DC-CONVERTER; DC-DC-MODULE
R12: 1k; 0603-RC
R13: 330; 0603-RC
R14: 120; 0603-RC
X1: MSTBA2

Connections:
3.3V: JP1.1, R14.2; also elsewhere on the board
5V: JP1.3, R13.2; also elsewhere on the board
+12V: MODULE1.OUT+, R12.2; also elsewhere on the board
+24V: D3.C, MODULE1.IN+
GND: LED1.C, LED2.C, LED3.C, MODULE1.IN-, MODULE1.OUT-, X1.2; also elsewhere on the board
unnamed: LED1.A, R12.1
unnamed: D3.A, F1.P$2 (2)
unnamed: LED2.A, R13.1
unnamed: LED3.A, R14.1
PRE24: F1.P$1 (1), X1.1
VCC: JP1.2; also elsewhere on the board

Notes on the sheet:
POWER SUPPLY
VCC SELECT

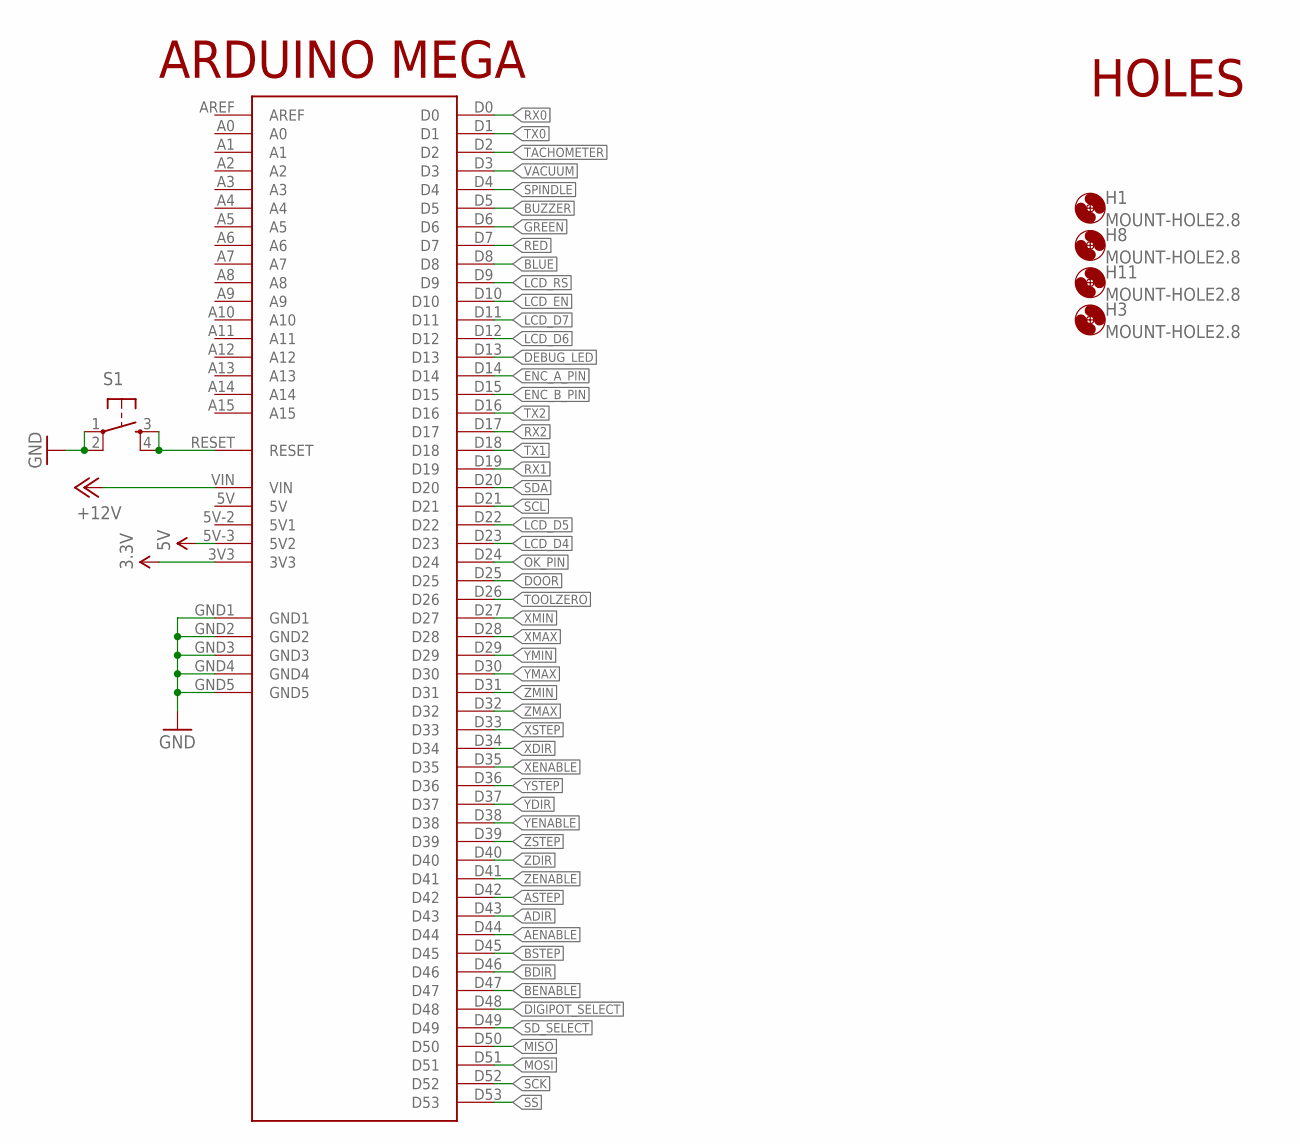
[picture p91: schematic cnc-controller.sch, sheet 3]

Parts:
H1, H3, H8, H11: MOUNT-HOLE2.8; 2,8
S1: TAC_SWITCHSMD; TACTILE_SWITCH_SMD
U$1: ARDUINO-MEGA

Connections:
3.3V: U$1.3V3; also elsewhere on the board
5V: U$1.5V-3 (5V2); also elsewhere on the board
+12V: U$1.VIN; also elsewhere on the board
ADIR: U$1.D43; also elsewhere on the board
AENABLE: U$1.D44; also elsewhere on the board
ASTEP: U$1.D42; also elsewhere on the board
BDIR: U$1.D46; also elsewhere on the board
BENABLE: U$1.D47; also elsewhere on the board
BLUE: U$1.D8; also elsewhere on the board
BSTEP: U$1.D45; also elsewhere on the board
BUZZER: U$1.D5; also elsewhere on the board
DEBUG_LED: U$1.D13
DIGIPOT_SELECT: U$1.D48
DOOR: U$1.D25; also elsewhere on the board
ENC_A_PIN: U$1.D14; also elsewhere on the board
ENC_B_PIN: U$1.D15; also elsewhere on the board
GND: S1.1, S1.2, U$1.GND1, U$1.GND2, U$1.GND3, U$1.GND4, U$1.GND5; also elsewhere on the board
GREEN: U$1.D6; also elsewhere on the board
LCD_D4: U$1.D23; also elsewhere on the board
LCD_D5: U$1.D22; also elsewhere on the board
LCD_D6: U$1.D12; also elsewhere on the board
LCD_D7: U$1.D11; also elsewhere on the board
LCD_EN: U$1.D10; also elsewhere on the board
LCD_RS: U$1.D9; also elsewhere on the board
MISO: U$1.D50; also elsewhere on the board
MOSI: U$1.D51; also elsewhere on the board
unnamed: S1.3, S1.4, U$1.RESET
OK_PIN: U$1.D24; also elsewhere on the board
RED: U$1.D7; also elsewhere on the board
RX0: U$1.D0
RX1: U$1.D19; also elsewhere on the board
RX2: U$1.D17; also elsewhere on the board
SCK: U$1.D52; also elsewhere on the board
SCL: U$1.D21; also elsewhere on the board
SDA: U$1.D20; also elsewhere on the board
SD_SELECT: U$1.D49; also elsewhere on the board
SPINDLE: U$1.D4; also elsewhere on the board
SS: U$1.D53; also elsewhere on the board
TACHOMETER: U$1.D2; also elsewhere on the board
TOOLZERO: U$1.D26; also elsewhere on the board
TX0: U$1.D1
TX1: U$1.D18; also elsewhere on the board
TX2: U$1.D16; also elsewhere on the board
VACUUM: U$1.D3; also elsewhere on the board
XDIR: U$1.D34; also elsewhere on the board
XENABLE: U$1.D35; also elsewhere on the board
XMAX: U$1.D28; also elsewhere on the board
XMIN: U$1.D27; also elsewhere on the board
XSTEP: U$1.D33; also elsewhere on the board
YDIR: U$1.D37; also elsewhere on the board
YENABLE: U$1.D38; also elsewhere on the board
YMAX: U$1.D30; also elsewhere on the board
YMIN: U$1.D29; also elsewhere on the board
YSTEP: U$1.D36; also elsewhere on the board
ZDIR: U$1.D40; also elsewhere on the board
ZENABLE: U$1.D41; also elsewhere on the board
ZMAX: U$1.D32; also elsewhere on the board
ZMIN: U$1.D31; also elsewhere on the board
ZSTEP: U$1.D39; also elsewhere on the board

Notes on the sheet:
ARDUINO MEGA
HOLES

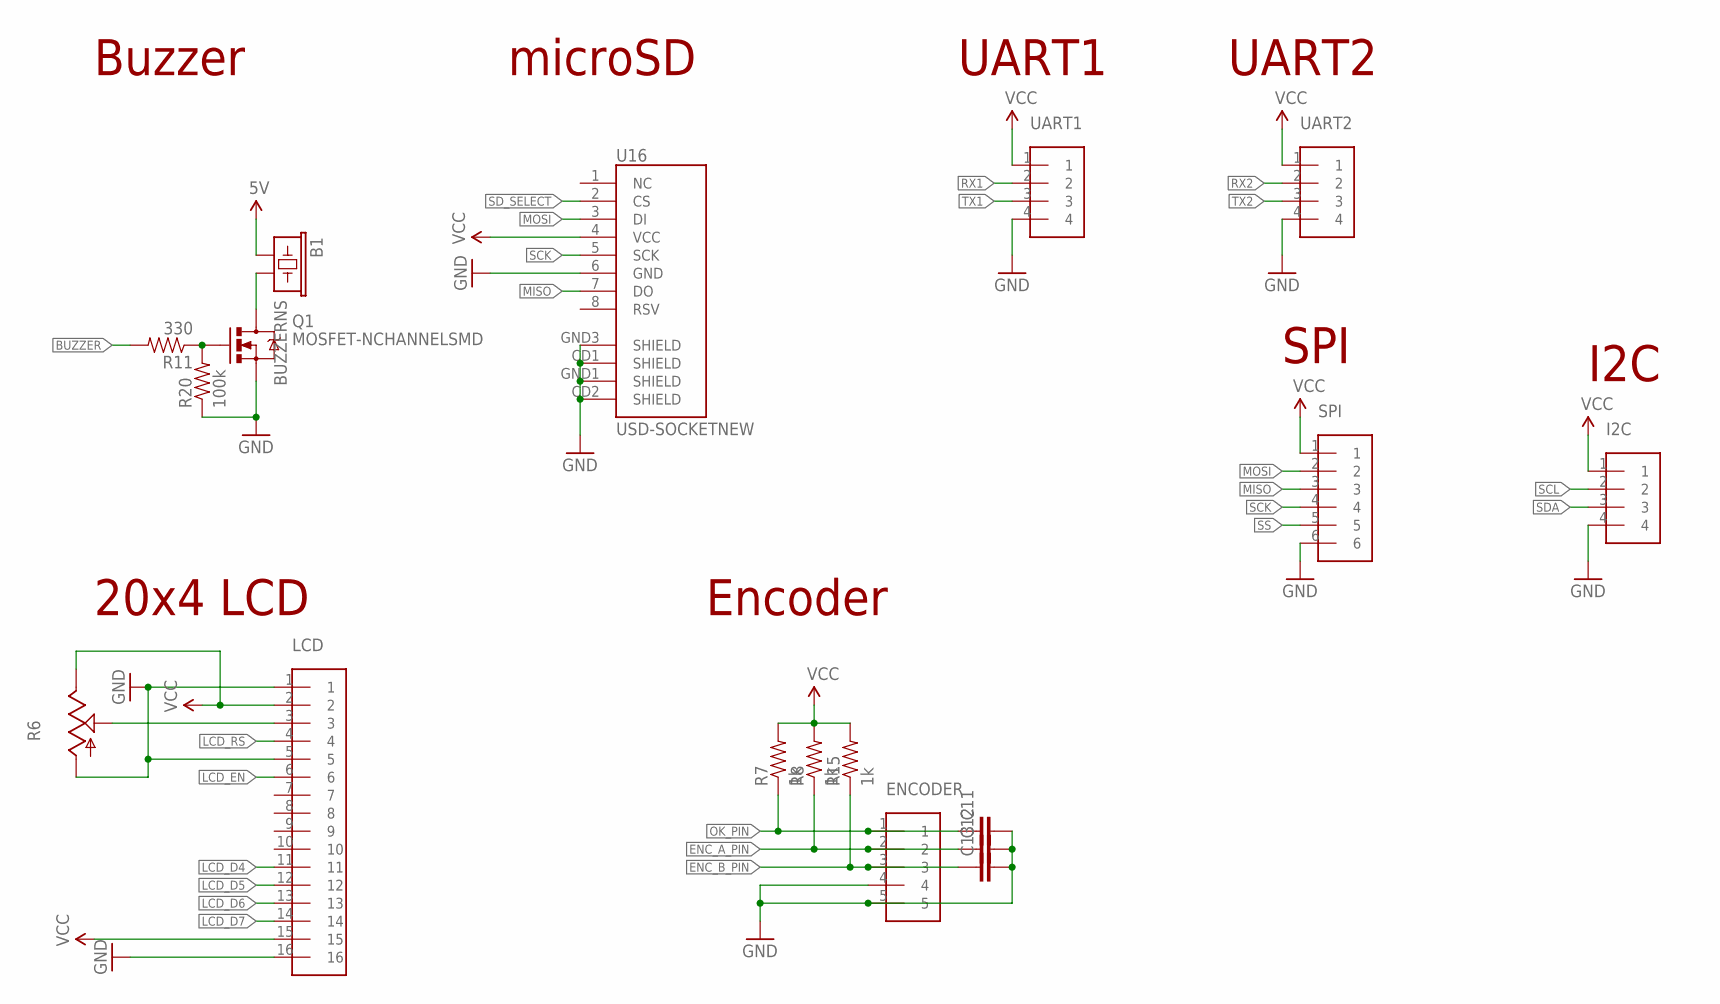
[picture p92: schematic cnc-controller.sch, sheet 4]

Parts:
B1: BUZZERNS; BUZZER-12MM-NS
C11, C12, C13: CAPACITOR0805; 0805-RC
ENCODER: CONN-5; XH-5
I2C: CONN-4; XH-4
LCD: CONN-16; XH-16
Q1: MOSFET-NCHANNELSMD; SOT23-3
R6: TRIM_US-B25P; B25P
R7, R8, R15: 1k; 0805-RC
R11: 330; 0603-RC
R20: 100k; 0603-RC
SPI: CONN-6; XH-6
U16: USD-SOCKETNEW; MICRO-SD-SOCKET-PP
UART1, UART2: CONN-4; XH-4

Connections:
5V: B1.+ (1); also elsewhere on the board
BUZZER: R11.2; also elsewhere on the board
ENC_A_PIN: C12.1, ENCODER.2, R8.1; also elsewhere on the board
ENC_B_PIN: C13.1, ENCODER.3, R15.1; also elsewhere on the board
GND: C11.2, C12.2, C13.2, ENCODER.4, ENCODER.5, I2C.4, LCD.1, LCD.5, LCD.16, Q1.2 (S), R6.A, R20.1, SPI.6, U16.6 (GND), U16.CD1 (SHIELD), U16.CD2 (SHIELD), U16.GND1 (SHIELD), U16.GND3 (SHIELD), UART1.4, UART2.4; also elsewhere on the board
LCD_D4: LCD.11; also elsewhere on the board
LCD_D5: LCD.12; also elsewhere on the board
LCD_D6: LCD.13; also elsewhere on the board
LCD_D7: LCD.14; also elsewhere on the board
LCD_EN: LCD.6; also elsewhere on the board
LCD_RS: LCD.4; also elsewhere on the board
MISO: SPI.3, U16.7 (DO); also elsewhere on the board
MOSI: SPI.2, U16.3 (DI); also elsewhere on the board
unnamed: LCD.3, R6.S
unnamed: Q1.1 (G), R11.1, R20.2
unnamed: B1.- (2), Q1.3 (D)
OK_PIN: C11.1, ENCODER.1, R7.1; also elsewhere on the board
RX1: UART1.2; also elsewhere on the board
RX2: UART2.2; also elsewhere on the board
SCK: SPI.4, U16.5 (SCK); also elsewhere on the board
SCL: I2C.2; also elsewhere on the board
SDA: I2C.3; also elsewhere on the board
SD_SELECT: U16.2 (CS); also elsewhere on the board
SS: SPI.5; also elsewhere on the board
TX1: UART1.3; also elsewhere on the board
TX2: UART2.3; also elsewhere on the board
VCC: I2C.1, LCD.2, LCD.15, R6.E, R7.2, R8.2, R15.2, SPI.1, U16.4 (VCC), UART1.1, UART2.1; also elsewhere on the board

Notes on the sheet:
Buzzer
microSD
SPI
I2C
UART2
UART1
20x4 LCD
Encoder

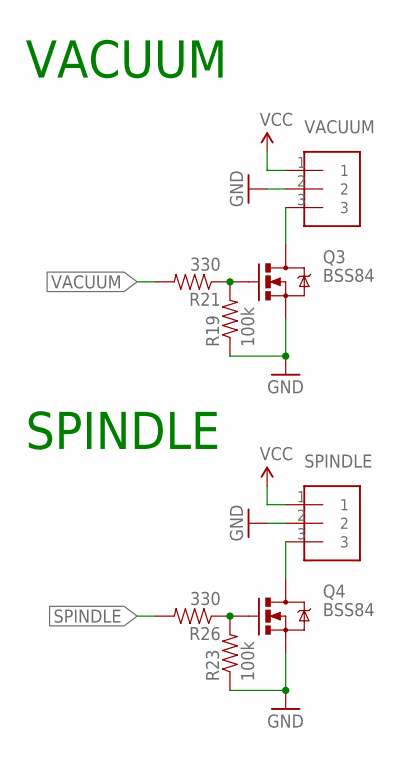
[picture p93: schematic cnc-controller.sch, sheet 5]

Parts:
Q3, Q4: BSS84; SOT23-3
R19, R23: 100k; 0603-RC
R21, R26: 330; 0603-RC
SPINDLE: CONN-3XH-3; XH-3
VACUUM: CONN-3XH-3; XH-3

Connections:
GND: Q3.2 (S), Q4.2 (S), R19.1, R23.1, SPINDLE.2, VACUUM.2; also elsewhere on the board
unnamed: Q3.1 (G), R19.2, R21.1
unnamed: Q4.1 (G), R23.2, R26.1
unnamed: Q3.3 (D), VACUUM.3
unnamed: Q4.3 (D), SPINDLE.3
SPINDLE: R26.2; also elsewhere on the board
VACUUM: R21.2; also elsewhere on the board
VCC: SPINDLE.1, VACUUM.1; also elsewhere on the board

Notes on the sheet:
VACUUM
SPINDLE

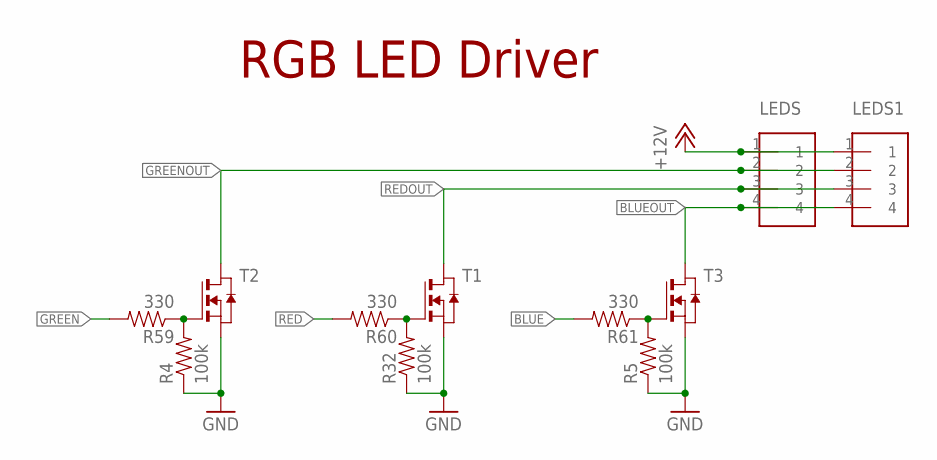
[picture p94: schematic cnc-controller.sch, sheet 6]

Parts:
LEDS, LEDS1: CONN-4; XH-4
R4, R5, R32: 100k; 0603-RC
R59, R60, R61: 330; 0603-RC
T1, T2, T3: NMOSSOT89; SOT89

Connections:
+12V: LEDS.1, LEDS1.1; also elsewhere on the board
BLUE: R61.2; also elsewhere on the board
BLUEOUT: LEDS.4, LEDS1.4, T3.2 (D)
GND: R4.1, R5.1, R32.1, T1.3 (S), T2.3 (S), T3.3 (S); also elsewhere on the board
GREEN: R59.2; also elsewhere on the board
GREENOUT: LEDS.2, LEDS1.2, T2.2 (D)
unnamed: R32.2, R60.1, T1.1 (G)
unnamed: R4.2, R59.1, T2.1 (G)
unnamed: R5.2, R61.1, T3.1 (G)
RED: R60.2; also elsewhere on the board
REDOUT: LEDS.3, LEDS1.3, T1.2 (D)

Notes on the sheet:
RGB LED Driver

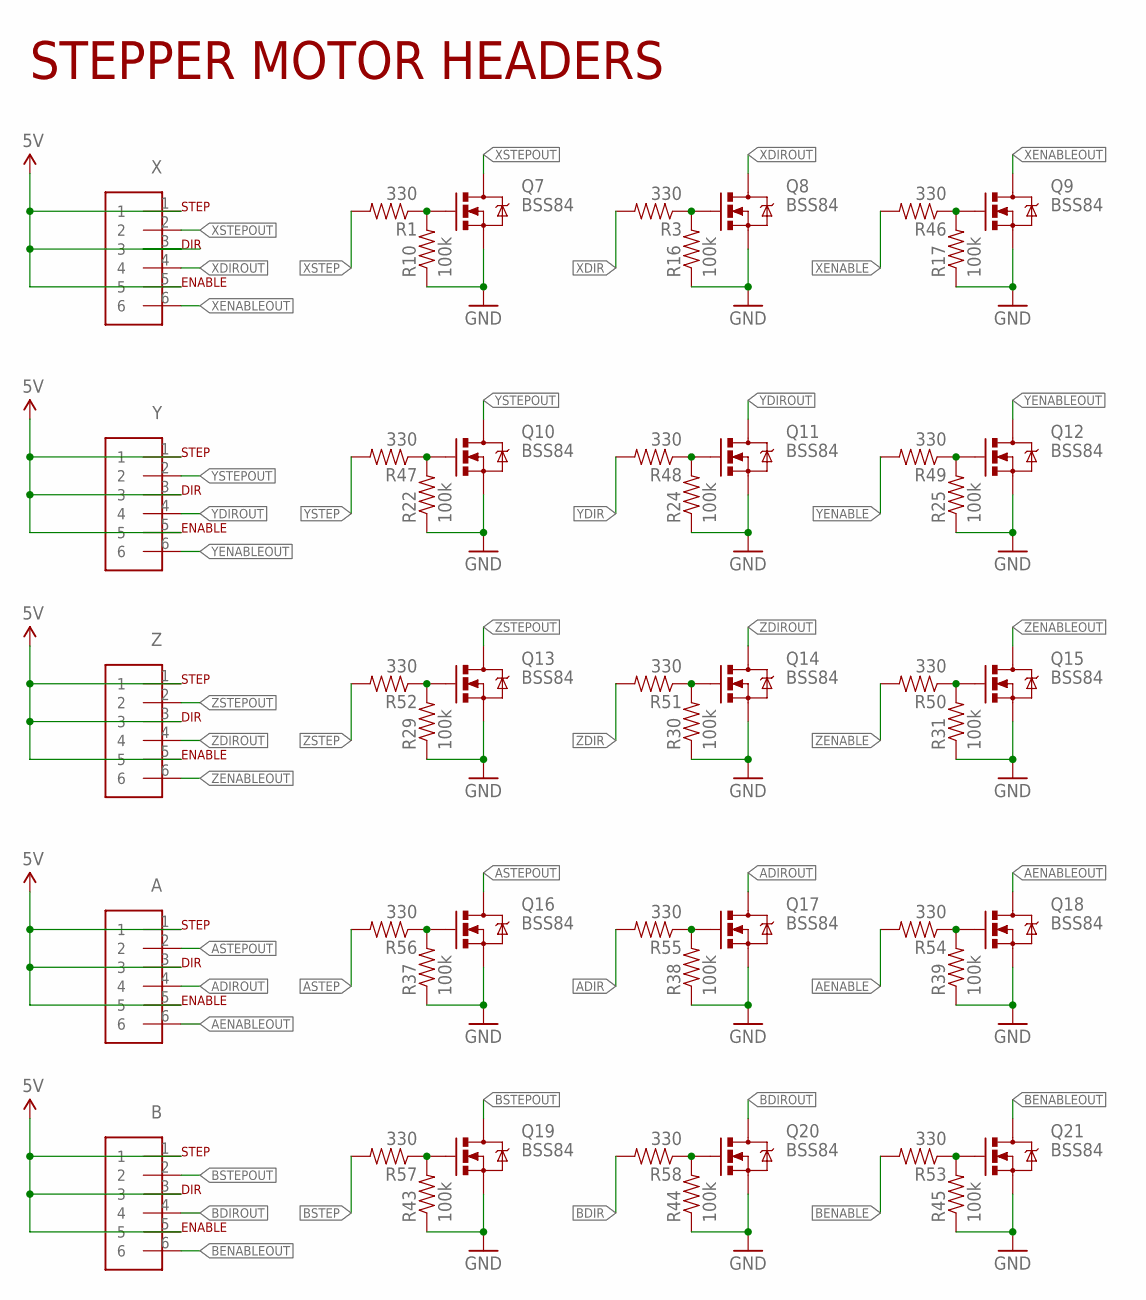
[picture p95: schematic cnc-controller.sch, sheet 7]

Parts:
A: CONN-6; XH-6
B: CONN-6; XH-6
Q7, Q8, Q9, Q10, Q11, Q12, Q13, Q14, Q15, Q16, Q17, Q18, Q19, Q20, Q21: BSS84; SOT23-3
R1, R3, R46, R47, R48, R49, R50, R51, R52, R53, R54, R55, R56, R57, R58: 330; 0603-RC
R10, R16, R17, R22, R24, R25, R29, R30, R31, R37, R38, R39, R43, R44, R45: 100k; 0603-RC
X: CONN-6; XH-6
Y: CONN-6; XH-6
Z: CONN-6; XH-6

Connections:
5V: A.1, A.3, A.5, B.1, B.3, B.5, X.1, X.3, X.5, Y.1, Y.3, Y.5, Z.1, Z.3, Z.5; also elsewhere on the board
ADIR: R55.2; also elsewhere on the board
ADIROUT: A.4, Q17.3 (D)
AENABLE: R54.2; also elsewhere on the board
AENABLEOUT: A.6, Q18.3 (D)
ASTEP: R56.2; also elsewhere on the board
ASTEPOUT: A.2, Q16.3 (D)
BDIR: R58.2; also elsewhere on the board
BDIROUT: B.4, Q20.3 (D)
BENABLE: R53.2; also elsewhere on the board
BENABLEOUT: B.6, Q21.3 (D)
BSTEP: R57.2; also elsewhere on the board
BSTEPOUT: B.2, Q19.3 (D)
GND: Q7.2 (S), Q8.2 (S), Q9.2 (S), Q10.2 (S), Q11.2 (S), Q12.2 (S), Q13.2 (S), Q14.2 (S), Q15.2 (S), Q16.2 (S), Q17.2 (S), Q18.2 (S), Q19.2 (S), Q20.2 (S), Q21.2 (S), R10.1, R16.1, R17.1, R22.1, R24.1, R25.1, R29.1, R30.1, R31.1, R37.1, R38.1, R39.1, R43.1, R44.1, R45.1; also elsewhere on the board
unnamed: Q10.1 (G), R22.2, R47.1
unnamed: Q19.1 (G), R43.2, R57.1
unnamed: Q20.1 (G), R44.2, R58.1
unnamed: Q21.1 (G), R45.2, R53.1
unnamed: Q16.1 (G), R37.2, R56.1
unnamed: Q17.1 (G), R38.2, R55.1
unnamed: Q18.1 (G), R39.2, R54.1
unnamed: Q11.1 (G), R24.2, R48.1
unnamed: Q12.1 (G), R25.2, R49.1
unnamed: Q15.1 (G), R31.2, R50.1
unnamed: Q14.1 (G), R30.2, R51.1
unnamed: Q13.1 (G), R29.2, R52.1
XDIR: R3.2; also elsewhere on the board
XDIRIN: Q8.1 (G), R3.1, R16.2
XDIROUT: Q8.3 (D), X.4
XENABLE: R46.2; also elsewhere on the board
XENABLEIN: Q9.1 (G), R17.2, R46.1
XENABLEOUT: Q9.3 (D), X.6
XSTEP: R1.2; also elsewhere on the board
XSTEPIN: Q7.1 (G), R1.1, R10.2
XSTEPOUT: Q7.3 (D), X.2
YDIR: R48.2; also elsewhere on the board
YDIROUT: Q11.3 (D), Y.4
YENABLE: R49.2; also elsewhere on the board
YENABLEOUT: Q12.3 (D), Y.6
YSTEP: R47.2; also elsewhere on the board
YSTEPOUT: Q10.3 (D), Y.2
ZDIR: R51.2; also elsewhere on the board
ZDIROUT: Q14.3 (D), Z.4
ZENABLE: R50.2; also elsewhere on the board
ZENABLEOUT: Q15.3 (D), Z.6
ZSTEP: R52.2; also elsewhere on the board
ZSTEPOUT: Q13.3 (D), Z.2

Notes on the sheet:
STEP
DIR
ENABLE
STEPPER MOTOR HEADERS

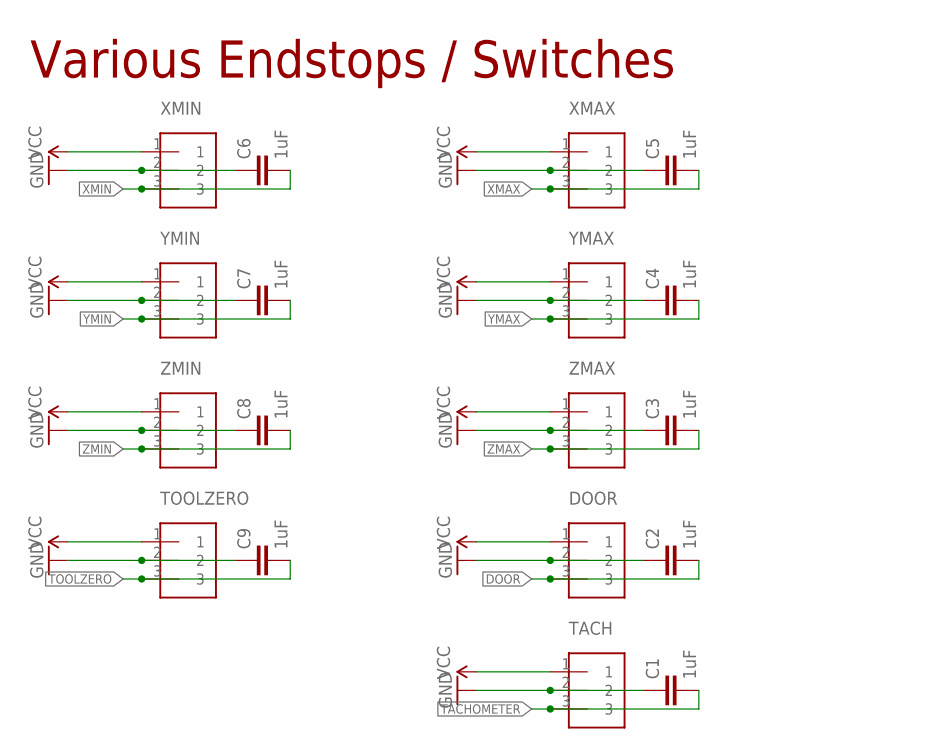
[picture p96: schematic cnc-controller.sch, sheet 8]

Parts:
C1, C2, C3, C4, C5, C6, C7, C8, C9: 1uF; 0603-RC
DOOR: CONN-3XH-3; XH-3
TACH: CONN-3XH-3; XH-3
TOOLZERO: CONN-3XH-3; XH-3
XMAX: CONN-3XH-3; XH-3
XMIN: CONN-3XH-3; XH-3
YMAX: CONN-3XH-3; XH-3
YMIN: CONN-3XH-3; XH-3
ZMAX: CONN-3XH-3; XH-3
ZMIN: CONN-3XH-3; XH-3

Connections:
DOOR: C2.2, DOOR.3; also elsewhere on the board
GND: C1.1, C2.1, C3.1, C4.1, C5.1, C6.1, C7.1, C8.1, C9.1, DOOR.2, TACH.2, TOOLZERO.2, XMAX.2, XMIN.2, YMAX.2, YMIN.2, ZMAX.2, ZMIN.2; also elsewhere on the board
TACHOMETER: C1.2, TACH.3; also elsewhere on the board
TOOLZERO: C9.2, TOOLZERO.3; also elsewhere on the board
VCC: DOOR.1, TACH.1, TOOLZERO.1, XMAX.1, XMIN.1, YMAX.1, YMIN.1, ZMAX.1, ZMIN.1; also elsewhere on the board
XMAX: C5.2, XMAX.3; also elsewhere on the board
XMIN: C6.2, XMIN.3; also elsewhere on the board
YMAX: C4.2, YMAX.3; also elsewhere on the board
YMIN: C7.2, YMIN.3; also elsewhere on the board
ZMAX: C3.2, ZMAX.3; also elsewhere on the board
ZMIN: C8.2, ZMIN.3; also elsewhere on the board

Notes on the sheet:
Various Endstops / Switches

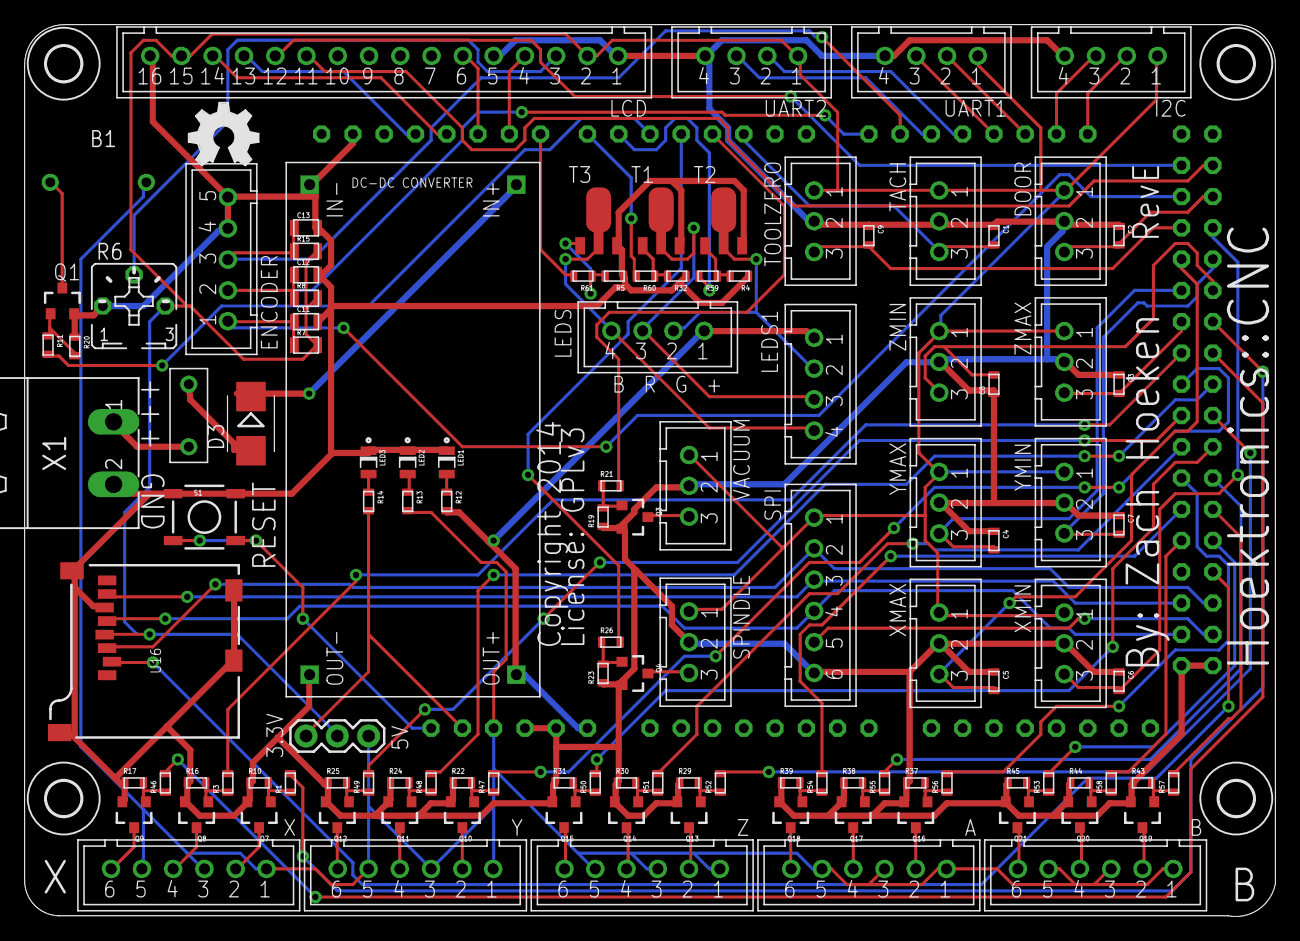
[picture p97: board cnc-controller.brd from above]

Board: 2 copper layers, 101.6 x 72.4 mm, 123 parts (0 on the bottom side), 105 nets.

Other parts of the board:
U$12: OSHW_FILLX200_NOTEXT
