Hoektronics/Shukongji/electronics/usb-to-5v/usb-to-5v.brd

## EAGLE design electronics/usb-to-5v/usb-to-5v.brd (2013-04-05)

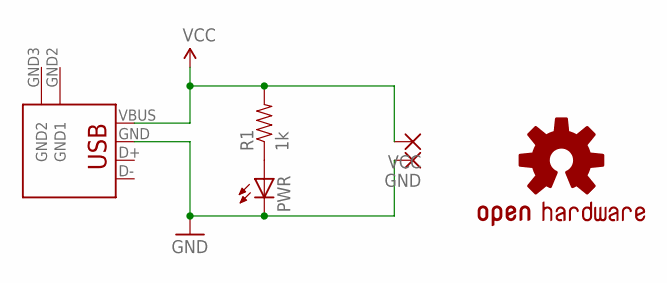
[picture p98: schematic usb-to-5v.sch]

Parts:
GND: 1,6/0,9
JP1: USB-A-H
LOGO1: OSHW-LOGOS; OSHW-LOGO-S
PWR: LED0805; 0805-LED
R1: 1k; 0805-RC
VCC: 1,6/0,9

Connections:
GND: GND.1, JP1.GND (VBUS), PWR.C
unnamed: PWR.A, R1.1
VCC: JP1.VBUS (GND), R1.2, VCC.1

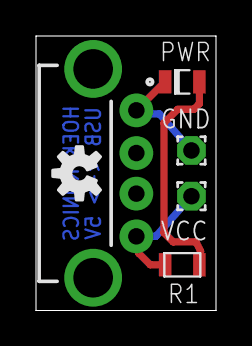
[picture p99: board usb-to-5v.brd from above]

Board: 2 copper layers, 10.0 x 15.2 mm, 6 parts (0 on the bottom side), 3 nets.
