Hoektronics/Shukongji/scripts/pcb-gcode-3.6.0.1/settings/pcb-machine.h

//
// For ease of use, and to avoid overwritting your settings,
// use pcb-gcode-setup to make changes to these settings.
//

real DEFAULT_Z_HIGH = 20.000000;
real DEFAULT_Z_UP = 1.000000;
real DEFAULT_Z_DOWN = -0.150000;
real DRILL_DEPTH = -1.800000;
real DRILL_DWELL = 1.000000;
real SPINDLE_ON_TIME = 1000.000000;
real MILLING_DEPTH = -1.800000;
real TEXT_DEPTH = -0.100000;
real TOOL_CHANGE_POS_X = 0.000000;
real TOOL_CHANGE_POS_Y = 0.000000;
real TOOL_CHANGE_POS_Z = 20.000000;
real FEED_RATE = 400.000000;
real FEED_RATE_Z = 150.000000;
real DEFAULT_WIDTH = 0.200000;
real X_OFFSET = 0.000000;
real Y_OFFSET = 0.000000;
real X_HOME = 0.000000;
real Y_HOME = 0.000000;
real EPSILON = 0.001000;
