Hoektronics/Shukongji/scripts/pcb-gcode-3.6.0.1/settings/pcb-gcode-options.h

//
// General Options // Your edits to this file will be overwritten by the setup program.
//
int SHOW_PROGRESS = NO;
string RESTORE_MENU_FILE = "pcb-gcode-menu.scr";
int NC_FILE_COMMENT_FROM_BOARD = NO;
int NC_FILE_COMMENT_DATE = NO;
int NC_FILE_COMMENT_MACHINE_SETTINGS = NO;
int NC_FILE_COMMENT_PCB_DEFAULTS_SETTINGS = NO;
int USER_GCODE = YES;
int g_debug_flag = NO;
int COMPACT_GCODE = NO;
int USE_LINE_NUMBERS = NO;
string LINE_NUMBER_FORMAT = "N%05d ";
int SHOW_PREVIEW = YES;
string FILENAME_BASE = "$BOARD_PATH/$BOARD_NAME";
string FILENAME_TOP_ETCH_FILE = ".$SIDE.$FILE.$EXT";
string FILENAME_TOP_DRILL_FILE = ".$SIDE.$FILE.$EXT";
string FILENAME_TOP_MILL_FILE = ".$SIDE.$FILE.$EXT";
string FILENAME_TOP_TEXT_FILE = ".$SIDE.$FILE.$EXT";
string FILENAME_TOP_FILL_FILE = "";
string FILENAME_BOT_ETCH_FILE = ".$SIDE.$FILE.$EXT";
string FILENAME_BOT_DRILL_FILE = ".$SIDE.$FILE.$EXT";
string FILENAME_BOT_MILL_FILE = ".$SIDE.$FILE.$EXT";
string FILENAME_BOT_TEXT_FILE = ".$SIDE.$FILE.$EXT";
string FILENAME_BOT_FILL_FILE = "";
string ETCH_FILE_NAME = "isolate";
string DRILL_FILE_NAME = "drill";
string MILL_FILE_NAME = "mill";
string TEXT_FILE_NAME = "text";
string TOP_FILE_NAME = "top";
string BOT_FILE_NAME = "bot";
string DEFAULT_EXTENSION = "gcode";
string DEFAULT_DRILL_FILE = "";
