Hoektronics/Shukongji/(commit log)

2012-06-29 added initial version of files.
    [botstep23-5axis-carrier.brd, botstep23-5axis-carrier.sch, botstep23.brd, botstep23.sch]
2012-06-30 added pin allocation worksheet to investigate feasibility.
    [pin-allocation.xlsx]
2012-06-30 brought over the library. created footprint for the mbed NXP LPC1768 dev board.
2012-07-01 hacked up the arduino mega motherboard to handle the mbed module.
    [mbed-motherboard.brd, mbed-motherboard.sch]
2012-07-02 added some datasheets and started wiring stuff up.
    [mbed-motherboard.brd, mbed-motherboard.sch, pin-allocation.xlsx]
2012-07-02 added ttl cable and started assigning more pins.
    [mbed-motherboard.brd, mbed-motherboard.sch, pin-allocation.xlsx]
2012-07-02 switched to the lpcxpresso based on arthurs suggestion.
    [mbed-motherboard.brd, mbed-motherboard.sch, pin-allocation.xlsx]
2012-07-02 added lpcxpresso schematic.
2012-07-02 did a lot of work laying out and fleshing out the board with the new lpcxpresso
    [botstep23.brd, botstep23.sch, mbed-motherboard.brd, mbed-motherboard.sch, pin-allocation.xlsx]
2012-07-02 made big progress on the parts and routing.
    [mbed-motherboard.brd, mbed-motherboard.sch, pin-allocation.xlsx]
2012-07-05 did a bunch of work on the controller board.
    [mbed-motherboard.brd, mbed-motherboard.sch, pin-allocation.xlsx]
2012-07-06 added buzzer
    [mbed-motherboard.brd, mbed-motherboard.sch, pin-allocation.xlsx]
2012-07-06 allocated pins to the rest of the features.
    [mbed-motherboard.brd, mbed-motherboard.sch, pin-allocation.xlsx]
2012-07-07 started routing power signals and shifted some parts around.
    [mbed-motherboard.brd, mbed-motherboard.sch, pin-allocation.xlsx]
2012-07-08 routed more of the board. a couple pin swaps.
    [mbed-motherboard.brd, mbed-motherboard.sch, pin-allocation.xlsx]
2012-07-09 more routing work.
    [mbed-motherboard.brd]
2012-07-11 added holes, and dealt with more power supply routing stuff. added power leds too.
    [mbed-motherboard.brd, mbed-motherboard.sch, pin-allocation.xlsx]
2012-07-12 cleaned up my library and rewired a bunch of stuff. ready for a rename now.
    [mbed-motherboard.brd, mbed-motherboard.sch, pin-allocation.xlsx]
2012-07-12 renamed until i get a better name.
    [lcpxpresso-mainboard.brd, lcpxpresso-mainboard.sch, mbed-motherboard.brd, pin-allocation.xlsx]
2012-07-12 removed old stepper directory.
    [botstep23-5axis-carrier.brd, botstep23-5axis-carrier.sch]
2012-07-12 started adding net classes.
    [lcpxpresso-mainboard.brd, lcpxpresso-mainboard.sch, pin-allocation.xlsx]
2012-07-12 routed all the important / critical signals.
    [lcpxpresso-mainboard.brd, lcpxpresso-mainboard.sch]
2012-07-12 100% routed.
    [lcpxpresso-mainboard.brd, lcpxpresso-mainboard.sch]
2012-07-16 added footprints for smaller pololu style drivers.
    [lcpxpresso-mainboard.brd, lcpxpresso-mainboard.sch]
2012-07-17 routed the smaller stepper driver... need to update the silkscreen on the modules now.
    [lcpxpresso-mainboard.brd]
2012-07-17 worked more on footprints and added to the hoekstep17 setup.
    [lcpxpresso-mainboard.brd, lcpxpresso-mainboard.sch, pin-allocation.xlsx]
2012-07-17 added mode set pins and started work on routing the AOUT signal.
    [lcpxpresso-mainboard.brd, lcpxpresso-mainboard.sch, pin-allocation.xlsx]
2012-07-19 toggled pins around, finished routing, tidied up silkscreen, and checked for drc errors.
    [lcpxpresso-mainboard.brd, lcpxpresso-mainboard.sch, pin-allocation.xlsx]
2012-07-19 renamed stepper driver board.
    [hoekstep23.brd, hoekstep23.sch]
2012-07-19 updated name in schematics and such
    [hoekstep23.brd, hoekstep23.sch]
2012-07-19 renamed the main controller board.
    [hoektronics-cnc-controller.brd, hoektronics-cnc-controller.sch, pin-allocation.xlsx]
2012-07-19 changed silkscreen and schematic with new name.
    [hoektronics-cnc-controller.brd, hoektronics-cnc-controller.sch]
2012-07-19 added allegro driver forked from https://github.com/mosfet/StepStick
    [hoekstep.brd, hoekstep.sch]
2012-07-19 started mods to the stepstick for conversion to A4982 chip
    [hoekstep.brd, hoekstep.sch]
2012-07-19 oops, bad naming.
    [hoekstep17.brd, hoekstep17.sch]
2012-07-19 wow, that was much easier than i was expecting. i remember this type of board being a nightmare to route last time i tried.
    [hoekstep17.brd, hoekstep17.sch]
2012-07-19 super minor changes.
    [hoektronics-cnc-controller.brd]
2012-07-20 tidied up the silkscreen on the hoekstep17 driver board.
    [hoekstep17.brd, hoekstep17.sch]
2012-07-20 more silkscreen tweaks and added more informational text to the schematic page.
    [hoekstep17.brd, hoekstep17.sch]
2012-07-21 a couple minor changes to hoekstep23, and added a new bluetooth module to the library.
    [hoekstep23.brd, hoekstep23.sch, hoektronics-cnc-controller.sch]
2012-07-21 modified the specs and design based on new ideas and conversations.
    [hoektronics-cnc-controller.brd, hoektronics-cnc-controller.sch, pin-allocation.xlsx]
2012-07-22 added wifi module.
    [hoektronics-cnc-controller.brd, hoektronics-cnc-controller.sch]
2012-07-22 started work on the carrier board footprints for wifi and bluetooth modules.
    [hoektronics-cnc-controller.brd, hoektronics-cnc-controller.sch]
2012-07-23 created carrier board for the bluetooth module. CNC millable! yeah!
    [RN-42-Carrier-Board.brd, RN-42-Carrier-Board.sch, hoektronics-cnc-controller.brd, hoektronics-cnc-controller.sch]
2012-07-23 first pass on RN131 carrier.
    [RN-131-Carrier-Board.brd, RN-131-Carrier-Board.sch, RN-42-Carrier-Board.sch]
2012-07-23 added silkscreen and documentation links.
    [RN-131-Carrier-Board.brd, RN-131-Carrier-Board.sch, RN-42-Carrier-Board.brd, hoekstep17.brd, hoekstep17.sch, hoekstep23.brd, hoekstep23.sch]
2012-07-23 updated the cnc controller with the new wireless modules.
    [hoektronics-cnc-controller.brd, hoektronics-cnc-controller.sch]
2012-07-24 started re-positioning of components from latest mods.
    [hoektronics-cnc-controller.brd, hoektronics-cnc-controller.sch]
2012-07-25 fixed fuse footprints, laid out a bunch of stuff, calculated power, added proper power connector, etc.
    [hoektronics-cnc-controller.brd, hoektronics-cnc-controller.sch, pin-allocation.xls, pin-allocation.xlsx, power-budget.xls]
2012-07-28 did a bunch of work on pin allocations. some swapping will likely need to happen before its 100% ready.
    [hoektronics-cnc-controller.brd, hoektronics-cnc-controller.sch, pin-allocation.xls]
2012-07-29 finished pin assignments, adding various peripherals, and adding 3.3v supply.
    [hoektronics-cnc-controller.brd, hoektronics-cnc-controller.sch, pin-allocation.xls, power-budget.xls]
2012-07-30 more layout and circuitry
    [hoektronics-cnc-controller.brd, hoektronics-cnc-controller.sch, pin-allocation.xls]
2012-07-31 lots of progress on routing the board. updated spec too.
    [hoektronics-cnc-controller.brd, hoektronics-cnc-controller.sch, pin-allocation.xls]
2012-07-31 updated protect pins in schematic
    [hoektronics-cnc-controller.brd, hoektronics-cnc-controller.sch, pin-allocation.xls]
2012-07-31 added mosfet to pwm output pin.
    [hoektronics-cnc-controller.brd, hoektronics-cnc-controller.sch, pin-allocation.xls]
2012-07-31 more routing on the mosfet / relay side.
    [hoektronics-cnc-controller.brd]
2012-08-01 routed everything except for a mystery airwire.
    [hoektronics-cnc-controller.brd, pin-allocation.xls]
2012-08-01 finished the layout!!!
    [hoektronics-cnc-controller.brd]
2012-08-01 more prepwork for an rc2
    [hoektronics-cnc-controller.brd, hoektronics-cnc-controller.sch, pin-allocation.xls]
2012-08-02 cleaned up the schematic and added a block level diagram
    [hoektronics-cnc-controller.brd, hoektronics-cnc-controller.sch, pin-allocation.xls]
2012-08-02 cleaned up the schematic nicely.
    [hoektronics-cnc-controller.brd, hoektronics-cnc-controller.sch, pin-allocation.xls]
2012-08-02 verified all the pin allocations are correct
    [hoektronics-cnc-controller.brd, pin-allocation.xls]
2012-08-02 fixed a bug with the powering of the lcpxpresso.
    [hoektronics-cnc-controller.brd, hoektronics-cnc-controller.sch]
2012-08-02 added frames to all circuits.
    [RN-131-Carrier-Board.sch, RN-42-Carrier-Board.sch, hoekstep17.sch, hoekstep23.sch]
2012-08-02 renamed boards.
    [hoekdrive17.brd, hoekdrive17.sch, hoekdrive23.brd, hoekdrive23.sch]
2012-08-02 finished the renaming process.
    [hoekdrive17.brd, hoekdrive17.sch, hoekdrive23.brd, hoekdrive23.sch]
2012-08-18 added pdfs in preparation for release to prototype.
    [hoekdrive23.sch, hoektronics-cnc-controller.brd, hoektronics-cnc-controller.sch]
2012-08-19 reverted to eagle 5 version of the hoekdrive23 board.
    [hoekdrive23.brd, hoekdrive23.sch]
2012-08-19 small cosmetic change.
    [hoekdrive23.sch]
2012-08-19 added all the drill files, and fixed a major error with the carrier boards and hole sizes.
    [RN-131-Carrier-Board.brd, RN-131-Carrier-Board.sch, RN-42-Carrier-Board.brd, RN-42-Carrier-Board.sch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]
2012-08-19 totally cleaned up the silkscreen on the cnc controller.
    [hoektronics-cnc-controller.brd, hoektronics-cnc-controller.sch]
2012-08-19 fixed a silkscreen issue.
    [hoektronics-cnc-controller.brd]
2012-08-28 added design rules file with shrunken cream pads for stencil creatin.
    [RN-131-Carrier-Board.brd, RN-42-Carrier-Board.brd, hoektronics-cnc-controller.brd]
2012-08-30 re-ran design rules and adjusted component spacing a bit.
    [hoekdrive17.brd]
2012-08-30 a bit more tweaking of design. want to get it right on the first try.
    [hoekdrive17.brd, hoekdrive17.sch]
2012-08-31 modified all smt chip passives pads and tweaked the hoekdrive 17 board to match.
    [hoekdrive17.brd, hoekdrive17.sch]
2012-09-03 updated the drill file.
    [hoekdrive17.drl]
2012-09-26 messed aroudn with a t-slot layout.
    [30x30x350.SLDPRT, 30x90x200.SLDPRT, 30x90x500.SLDPRT, Frame.SLDASM, hoekdrive17.brd, hoekdrive17.sch, nema23.SLDPRT]
2012-09-27 modeled a couple more parts.
    [30x30x350.SLDPRT, Frame.SLDASM, SC12UU.SLDPRT, flexible-coupling.SLDPRT, nema23.SLDPRT]
2012-10-03 added y front and back plates.
    [Frame.SLDASM, Y-Plate-Front.SLDPRT, Y-Plate-Rear.SLDPRT, nema23.SLDPRT]
2012-10-03 lots more fleshing out of the y stage.
    [606-Bearing-Mount.SLDPRT, 606ZZ.SLDPRT, Frame.SLDASM, SC12UU.SLDPRT, SHF12.SLDPRT, Y-Drive-Rod.SLDPRT, Y-Plate-Front.SLDPRT, Y-Plate-Rear.SLDPRT]
2012-10-03 added ball screw nut drawing.
    [Frame.SLDASM]
2012-10-03 added ball screw nut drawing. srsly.
    [SFU1204-Nut.SLDPRT]
2012-10-04 Y stage base almost complete.
    [30x30x350.SLDPRT, 30x90x500.SLDPRT, Frame-Base-Length.SLDPRT, Frame-Base-Width.SLDPRT, Frame.SLDASM, Main Assembly.SLDASM, SC12UU.SLDPRT, SFU1204-Nut-Mount.SLDPRT]
2012-10-05 started work on the x axis.
    [3030-Corner.SLDPRT, Frame-Base-Length.SLDPRT, Frame-Vertical-Column.SLDPRT, Frame.SLDASM, Main Assembly.SLDASM, SC12UU.SLDPRT, SK12.SLDPRT, X-Axis.SLDASM]
2012-10-05 lots of work... added z axis and spindle./slicers/slic3r-0.9.2/osx.app/Contents/MacOS/slic3r --load /var/folders/nw/g8r8sjk96zb9m6355kt5hxb40000gn/T/tmpZ7uwLh --output /var/folders/nw/g8r8sjk96zb9m63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
    [E240-Spindle.SLDPRT, Frame-Rear-Brace.SLDPRT, Frame-Vertical-Column.SLDPRT, Frame.SLDASM, Main Assembly.SLDASM, Spindle-Clamp.SLDPRT, X-Axis.SLDASM, X-Plate.SLDPRT]
2012-10-09 put some more work into the XYZ stages. modeled the spindle.
    [E240-Spindle.SLDPRT, Frame-Rear-Brace.SLDPRT, Frame.SLDASM, Main Assembly.SLDASM, Optical-Encoder.SLDPRT, SC12UU.SLDPRT, Y-Stage.SLDASM, Y-Stage.SLDPRT]
2012-10-09 started work on the test fixture.
    [Test Fixture.SLDASM, hoekdrive17-test-fixture.brd, hoekdrive17-test-fixture.sch, motor-mount.SLDPRT, test-fixture-pcb.SLDPRT]
2012-10-12 a bunch of stuff on the mechanical side. started on a text fixture for stepper driver.
    [Frame-Vertical-Column.SLDPRT, Frame.SLDASM, Main Assembly.SLDASM, Test Fixture.SLDASM, Y-Stage-Plate.SLDPRT, Y-Stage.SLDASM, Y-Stage.SLDPRT, Z-Axis.SLDASM]
2012-10-12 i think its close to viable prototype stage now. :)
    [30x90x200.SLDPRT, Frame.SLDASM, Main Assembly.SLDASM, Radial-Bearing-Vertical.SLDPRT, SFU1204-Nut-Mount-XZ.SLDPRT, SFU1204-Nut-Mount.SLDPRT, Spindle Assembly.SLDASM, Spindle-Clamp.SLDPRT]
2012-10-15 ready for prototype 1. :)
    [Frame-Front-Column.SLDPRT, Frame-Top-Column.SLDPRT, Frame.SLDASM, Main Assembly.SLDASM, PSU-12V-10A.SLDPRT, Spindle Assembly.SLDASM, X-Axis.SLDASM, X-Drive-Rod.SLDDRW]
2012-10-18 updated to revb design with 0603 and removed a couple caps.
    [hoekdrive17.brd, hoekdrive17.sch]
2012-10-18 updated lasercut designs. should be ready to rock now.
    [Frame.SLDASM, Main Assembly.SLDASM, Spindle Assembly.SLDASM, Spindle-Clamp.SLDPRT, X-Axis.SLDASM, X-Plate.SLDPRT, Y-Plate-Front.SLDPRT, Y-Plate-Rear.SLDPRT]
2012-10-19 rev b ready for quotation.
    [bill-of-materials.xls, hoekdrive17.brd, hoekdrive17.sch]
2012-10-19 fixed an error and updated the pdf.
    [hoekdrive17.brd]
2012-10-20 test rig ready for release.
    [hoekdrive17-test-fixture.brd, hoekdrive17-test-fixture.sch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]
2012-10-23 test fixture ready to order.
    [hoekdrive17-test-fixture.brd, hoekdrive17-test-fixture.sch]
2012-10-25 renamed file for arduino.
2012-10-25 fixed a milling issue with nema17 footprint
    [hoekdrive17-test-fixture.brd, hoekdrive17-test-fixture.sch]
2012-10-25 added power led.
    [hoekdrive17.brd, hoekdrive17.sch]
2012-10-26 some more polish on the stepper tester script.
2012-10-26 started on tester for nema23 boards.
    [hoekdrive23-test-fixture.brd, hoekdrive23-test-fixture.sch]
2012-10-28 added colors to many parts. ugly, but easier to differentiate.
    [3030-Corner.SLDPRT, E240-Spindle.SLDPRT, Frame-Base-Length.SLDPRT, Frame-Base-Width.SLDPRT, Frame-Rear-Brace.SLDPRT, Frame-Vertical-Column.SLDPRT, Frame.SLDASM, Main Assembly.SLDASM]
2012-10-28 added exterior assembly.
    [Exterior.SLDASM, hoekdrive23.brd]
2012-10-29 adjusted a couple hole sizes to get ready for laser cutting prototypes
    [Frame.SLDASM, Main Assembly.SLDASM, Spindle Assembly.SLDASM, X-Axis.SLDASM, X-Plate.SLDPRT, Y-Plate-Front.SLDPRT, Z-Axis.SLDASM, Z-Plate.SLDPRT]
2012-11-01 updated rev b for prototype run.
    [Test Fixture.SLDASM, bill-of-materials.xls, hoekdrive17.brd, hoekdrive17.sch, motor-mount.SLDPRT, test-fixture-pcb.SLDPRT]
2012-11-02 modified XY stages to use new style of connection.
    [Frame-Vertical-Column.SLDPRT, Frame.SLDASM, Main Assembly.SLDASM, SFU1204-Nut-Mount.SLDDRW, SFU1204-Nut-Mount.SLDPRT, Spindle Assembly.SLDASM, X-Axis.SLDASM, X-Plate.SLDPRT]
2012-11-04 removed test fixture directories.
    [Test Fixture.SLDASM, hoekdrive17-test-fixture.brd, hoekdrive17-test-fixture.sch, hoekdrive23-test-fixture.brd, hoekdrive23-test-fixture.sch, motor-mount.SLDPRT, test-fixture-pcb.SLDPRT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]
2012-11-06 switched to new, improved nut mounts.
    [F6-14-Thrust-Bearing.SLDPRT, Frame.SLDASM, Main Assembly.SLDASM, SFU1204-Nut-Mount.SLDPRT, SFU1204-Nut.SLDPRT, Spindle Assembly.SLDASM, X-Axis.SLDASM, X-Drive-Rod.SLDPRT]
2012-11-06 removed busted old file.
    [SFU1204-Nut-Mount-XZ.SLDPRT]
2012-11-06 upgraded all plates to 7mm.
    [Frame.SLDASM, Main Assembly.SLDASM, X-Axis.SLDASM, X-Plate.SLDPRT, Y-Drive-Rod.SLDPRT, Y-Stage-Plate.SLDPRT, Y-Stage.SLDASM, Z-Axis.SLDASM]
2012-11-06 added handwheels, thrust bearings, and other minor changes to make it nice and polished.
    [606-Bearing-Mount.SLDPRT, F6-14-Thrust-Bearing.SLDPRT, Hand-Wheel.SLDPRT, Main Assembly.SLDASM, X-Axis.SLDASM, XY-Bearing-Mount.SLDPRT, Y-Drive-Rod.SLDPRT, Y-Drive.SLDASM]
2012-11-06 lots of little tweaks for lasercutting and prototyping.
    [Hand-Wheel.SLDPRT, Main Assembly.SLDASM, X-Axis.SLDASM, X-Plate.SLDPRT, XY-Bearing-Mount.SLDPRT, XY-Motor-Mount.SLDPRT, Y-Drive.SLDASM, Y-Plate-Front.SLDPRT]
2012-11-06 lots of details for prototyping
    [Main Assembly.SLDASM, SFU1204-Nut-Mount.SLDDRW, SFU1204-Nut-Mount.SLDPRT, X-Axis.SLDASM, X-Plate.SLDPRT, Y-Drive.SLDASM, Y-Plate-Front.SLDPRT, Y-Stage-Plate.SLDPRT]
2012-11-08 more polish on the XYZ axes.
    [Main Assembly.SLDASM, SFU1204-Nut-Mount.SLDDRW, SFU1204-Nut-Mount.SLDPRT, X-Axis.SLDASM, Y-Stage.SLDASM, Z-Axis.SLDASM, Z-Stage.SLDASM]
2012-11-08 reworking the stepper driver with a new chip and horizontal layout
    [hoekdrive23.brd, hoekdrive23.sch]
2012-11-08 worked on stepper driver a bit more. proper hzip horizontal footprint
    [hoekdrive23.brd, hoekdrive23.sch]
2012-11-08 worked on new driver board.
    [hoekdrive23.brd, hoekdrive23.sch]
2012-11-09 split motor power and ground into A and B channels.
    [hoekdrive23.brd, hoekdrive23.sch]
2012-11-09 fixed a dumb erc error.
    [hoekdrive23.brd, hoekdrive23.sch]
2012-11-10 added pullup resistors to config pins for good defaults
    [hoekdrive23.brd, hoekdrive23.sch]
2012-11-10 updated footprint with better text and removed milling outline.
    [hoekdrive23.brd, hoekdrive23.sch]
2012-11-16 more work on the new motor driver.
    [hoekdrive23.brd, hoekdrive23.sch]
2012-11-16 started big overhaul of design to use 2 side pieces instead of aluminum frame extrusion.
    [Frame-Base-Width.SLDPRT, Frame-Rear-Brace.SLDPRT, Frame.SLDASM, Main Assembly.SLDASM, Right-Side.SLDPRT, SC16UU.SLDPRT, SHF16.SLDPRT, X-Axis.SLDASM]
2012-11-17 added pullup resistor on reset for easier operation.
    [hoekdrive23.brd, hoekdrive23.sch]
2012-11-20 updated the board to be ready for manufacture.
    [hoekdrive23.brd, hoekdrive23.sch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]
2012-11-20 the power of silkscreen compels you
    [hoekdrive23.brd, hoekdrive23.sch]
2012-11-27 hoekdrive23 ready for rev c
    [hoekdrive23.sch]
2012-11-27 added max6675 breakout board.
    [MAX6675-Breakout.brd, MAX6675-Breakout.sch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]
2012-11-27 fixed offset issue in layout.
    [MAX6675-Breakout.brd]
2012-11-27 fixed all outstanding issues with XYZ stages, some more tweaks still needed
    [Frame.SLDASM, Main Assembly.SLDASM, Right-Side.SLDPRT, X-Axis.SLDASM, Y-Stage-Plate.SLDPRT, Y-Stage.SLDASM, Y-Stage.SLDPRT, Z-Axis.SLDASM]
2012-11-27 more tweaks to the machine. bigger x bearing distance, better build plate.
    [Main Assembly.SLDASM, XY-Bearing-Mount.SLDPRT, XY-Motor-Mount.SLDPRT, Y-Stage.SLDASM, Y-Stage.SLDPRT, Z-Axis.SLDASM, Z-Plate.SLDPRT]
2012-12-04 finished the Z rod ends and updated both acrylic sides plates.
    [Frame-Base-Width.SLDPRT, Frame.SLDASM, Main Assembly.SLDASM, X-Axis.SLDASM, X-Drive-Rod.SLDPRT, XY-Bearing-Mount.SLDPRT, XY-Motor-Mount.SLDPRT, Z-Axis.SLDASM]
2012-12-17 ready for rev2 of lasercut prototypes.
    [3-Axis-Driver.SLDPRT, 626-Bearing-Mount.SLDPRT, 626ZZ.SLDPRT, Electronics-Board.SLDPRT, Frame.SLDASM, Main Assembly.SLDASM, Side-Panel.SLDPRT, Spindle-PSU.SLDPRT]
2012-12-18 fixed motors, worked on ballscrews, etc.
    [Hand-Wheel.SLDPRT, Main Assembly.SLDASM, X-Axis.SLDASM, X-Drive-Rod.SLDPRT, Y-Drive-Rod.SLDPRT, Y-Drive.SLDASM, Y-Stage-Plate.SLDDRW, Y-Stage-Plate.SLDPRT]
2012-12-18 updated a couple component values.
    [hoekdrive23.brd, hoekdrive23.sch]
2012-12-18 fully modeled ball screws
    [SFUXXXX-Ball-Screw.SLDPRT, X-Axis.SLDASM, Y-Drive.SLDASM, Z-Axis.SLDASM, Z-Drive-Rod.SLDDRW, Z-Drive-Rod.SLDPRT]
2012-12-18 removed obsolete drive rod parts.
    [X-Drive-Rod.SLDDRW, X-Drive-Rod.SLDPRT, Y-Drive-Rod.SLDDRW, Y-Drive-Rod.SLDPRT, Z-Drive-Rod.SLDDRW, Z-Drive-Rod.SLDPRT]
2012-12-19 did a bunch of work on fleshing out the details of the design.
    [Frame-Base-Width.SLDPRT, Hand-Wheel.SLDASM, Hand-Wheel.SLDPRT, SFU1204-Nut-Mount.SLDDRW, SFU1204-Nut-Mount.SLDPRT, SFUXXXX-Ball-Screw.SLDDRW, Side-Panel.SLDPRT, X-Axis.SLDASM]
2012-12-20 more work to add screws and such.
    [Spindle Assembly.SLDASM, Spindle-Clamp.SLDPRT, X-Axis.SLDASM, XY-Bearing-Mount.SLDPRT, XY-Motor-Mount.SLDPRT, Y-Stage.SLDASM, Z-Axis.SLDASM, Z-Plate.SLDPRT]
2012-12-20 more work on adding screws
    [X-Axis.SLDASM, Y-Drive.SLDASM, Y-Plate-Front.SLDPRT, Y-Plate-Rear.SLDPRT, Y-Stage.SLDASM, Z-Axis.SLDASM, Z-Stage.SLDASM]
2012-12-22 worked on the mechanical switch
    [switch.brd, switch.sch]
2012-12-22 added pcb assembly
    [D2F-Switch.SLDPRT, Mechanical Switch.SLDASM, Side-Panel.SLDPRT, Switch-PCB.SLDPRT, X-Axis.SLDASM, Y-Drive.SLDASM, switch.brd]
2012-12-22 x, z, and tool zeroing switches are looking nice and ready to rock.
    [E240-Spindle.SLDPRT, Hand-Wheel.SLDASM, Mechanical Switch.SLDASM, Side-Panel.SLDPRT, Spindle Assembly.SLDASM, Switch-PCB.SLDPRT, X-Axis.SLDASM, XY-Bearing-Mount.SLDPRT]
2012-12-22 forgot hex standoff.
    [Hex-Standoff.SLDPRT]
2012-12-23 modeled y endstops fully.
    [626ZZ.SLDPRT, Hand-Wheel.SLDASM, Hand-Wheel.SLDPRT, Hex-Standoff.SLDPRT, X-Axis.SLDASM, Y-Drive.SLDASM, Y-Endstop-Trigger.SLDPRT, Y-Plate-Front.SLDPRT]
2012-12-23 worked on spec and made drawing of side panel for quotation.
    [Side-Panel.SLDDRW, Side-Panel.SLDPRT, X-Axis.SLDASM, Y-Drive.SLDASM, hoektronics-cnc-controller.brd, hoektronics-cnc-controller.sch, switch.brd]
2012-12-25 switch is ready?
    [switch.brd, switch.sch]
2012-12-25 specs updated and clarified a bit.
    [hoektronics-cnc-controller.sch]
2012-12-25 big redesign for arduino mega / due.
    [hoektronics-cnc-controller.brd, hoektronics-cnc-controller.sch, mega-pin-allocation.xls, pin-allocation.xls, power-budget.xls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]
2012-12-25 worked on teh cnc machine a bit more.
    [Frame-Base-Width.SLDPRT, SFUXXXX-Ball-Screw.SLDDRW, SK12.SLDPRT]
2012-12-26 updated switch for first prototype.
    [switch.brd, switch.sch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]
2012-12-26 the cnc shield is about ready to rock and roll.
    [hoektronics-cnc-controller.brd, hoektronics-cnc-controller.sch, switch.brd]
2012-12-27 cnc controller rev c ready for liftoff.
    [cnc-controller.brd, cnc-controller.sch, hoektronics-cnc-controller.brd, hoektronics-cnc-controller.sch, mega-pin-allocation.xls, pin-allocation.xls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]
2012-12-27 updated power module. really ready this time.
    [cnc-controller.brd, cnc-controller.sch]
2012-12-30 updated drawings of aluminum plates.
    [Side-Panel.SLDDRW, X-Axis.SLDASM, Y-Plate-Front.SLDDRW, Y-Plate-Rear.SLDDRW, Y-Stage-Plate.SLDDRW, Y-Stage-Plate.SLDPRT, Y-Stage.SLDASM, Z-Plate.SLDDRW]
2013-01-04 added the stepper tester board.
    [Hand-Wheel.SLDASM, Hand-Wheel.SLDPRT, X-Axis.SLDASM, Y-Drive.SLDASM, Y-Endstop-Trigger.SLDPRT, Y-Stage.SLDASM, Y-Stage.SLDPRT, Z-Axis.SLDASM]
2013-01-04 changed to 0805
    [stepper-tester.brd, stepper-tester.sch]
2013-01-04 added pcb to gcode script.
    [04151_lcdi2c.brd, 04151_lcdi2c.sch, enabtmr.brd, enabtmr.sch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]
2013-01-04 fixed start/end problems. should get this working soon. :)
    [pcb-defaults.h, pcb-machine.h, user-gcode.h]
2013-01-05 tester board tweaks.
    [stepper-tester.brd]
2013-01-05 added y stage drawing.
    [Y-Stage.SLDDRW]
2013-01-05 started work on adding separate milling feedrate.
2013-01-06 minor tweaks to get v2 machine working.
    [Hand-Wheel.SLDPRT, Y-Stage.SLDASM, stepper-tester.brd, stepper-tester.sch]
2013-01-07 tweaked the milling profile a bit based on tonights experimentation.
2013-01-11 forgot to commit some stuff. changed to 16mm rods on Y axis, improved bearing holes, added bottom + rubber feet.
    [30mm-Rubber-Foot.SLDPRT, Bottom-Plate.SLDPRT, Hand-Wheel.SLDASM, Side-Panel.SLDPRT, X-Axis.SLDASM, XY-Bearing-Mount.SLDPRT, Y-Drive.SLDASM, Y-Plate-Front.SLDPRT]
2013-01-11 ignoring stl files now.
2013-01-11 added 45 degree angles to the bot. looking hawt.
    [Side-Panel.SLDPRT, X-Axis.SLDASM]
2013-01-11 updated pcb milling settings.
2013-01-11 added electronics cover plate.
    [Bottom-Plate.SLDPRT, Frame-Base-Width.SLDPRT, Side-Panel.SLDPRT, X-Axis.SLDASM]
2013-01-11 got animations working and tweaked the look and feel a bit.
    [Frame-Base-Width.SLDPRT, Power-Socket.SLDPRT, X-Axis.SLDASM]
2013-01-12 lots of changes for v3.
    [Bottom-Plate.SLDPRT, Rear-Panel.SLDPRT, Side-Panel.SLDPRT, X-Axis.SLDASM]
2013-01-14 tweaked X and Y motor rotations to make things nicer.
    [XY-Bearing-Mount.SLDPRT, XY-Motor-Mount.SLDPRT, Y-Drive.SLDASM, Y-Plate-Front.SLDPRT, Z-Axis.SLDASM, Z-Plate.SLDPRT]
2013-01-14 added power socket, removed y max switch, tweaked a few things.
    [Rear-Panel.SLDPRT, Side-Panel.SLDPRT, X-Axis.SLDASM, Y-Drive.SLDASM, Y-Plate-Front.SLDPRT, Y-Plate-Rear.SLDPRT]
2013-01-15 added led models, covers, and holes.
    [30mm-Rubber-Foot.SLDPRT, LED-Cover.SLDPRT, LED-Strip.SLDPRT, Side-Panel.SLDPRT, X-Axis.SLDASM]
2013-01-15 added vacuum socket to the rear panel design.
    [Power-Socket.SLDPRT, Rear-Panel.SLDPRT, Side-Panel.SLDPRT, Vacuum-AC-Socket.SLDPRT, X-Axis.SLDASM]
2013-01-17 added front panel from bent acrylic.
    [Hand-Wheel.SLDASM, Interface-Panel.SLDPRT, Mechanical Switch.SLDASM, Rear-Panel.SLDPRT, Side-Panel.SLDPRT, Spindle Assembly.SLDASM, X-Axis.SLDASM, Y-Drive.SLDASM]
2013-02-01 added the tachometer board for measuring rotation speed.
    [tachometer.brd, tachometer.sch]
2013-02-14 updated tachometer silk for production.
    [Spindle Assembly.SLDASM, tachometer.brd, tachometer.sch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]
2013-02-19 updated electronics, tachometer ready for 1st rev.
    [cnc-controller.brd, cnc-controller.sch, tachometer.sch]
2013-02-20 added new interface board.
    [interface-board.brd, interface-board.sch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]
2013-02-21 updated cnc controller. close to next prototype release.
    [cnc-controller.brd, cnc-controller.sch, interface-board.brd, mega-pin-allocation.xls]
2013-02-21 routed pcb + updated pin allocaiton doc.
    [cnc-controller.brd, cnc-controller.sch, mega-pin-allocation.xls]
2013-02-21 removed old/stale cnc controller directory.
    [hoektronics-cnc-controller.brd, hoektronics-cnc-controller.sch, pin-allocation.xls, power-budget.xls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]
2013-02-23 prepped cnc controller for rev d.
    [cnc-controller.brd, cnc-controller.sch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]
2013-03-01 tweaked the setting on pcb-gcode.
2013-03-01 added LCD screen part.
    [LCD.SLDPRT]
2013-03-01 added my milling prefs to pycam.
2013-03-05 upgraded to solidworks 2013.
    [3-Axis-Driver.SLDPRT, 30mm-Rubber-Foot.SLDPRT, 626-Bearing-Mount.SLDPRT, 626ZZ.SLDPRT, Bottom-Plate.SLDPRT, D2F-Switch.SLDPRT, E240-Spindle.SLDPRT, F6-14-Thrust-Bearing.SLDPRT]
2013-03-05 added tachometer pcb stuff.
    [Tachometer-Mount.SLDPRT, Tachometer-PCB.SLDPRT]
2013-03-19 added caps to endstops.
    [cnc-controller.brd, cnc-controller.sch]
2013-03-19 added meshcam stuff for awesome milling.
    [double-side-frame.SLDPRT]
2013-03-29 added usb to 5v adaptor board.
    [usb-to-5v.brd, usb-to-5v.sch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]
2013-04-03 added scad for cutting frame holes.
    [material-holes.scad]
2013-04-05 small tweaks to toolpathing stuff.
    [material-holes.scad, usb-to-5v.brd]
2013-04-14 lots of tweaking to settings for machining and usage.
    [2-side-frame.scad, material-holes.scad]
2013-12-12 updated cnc driver shield and various tweaks to milling config.
    [cnc-controller.brd, cnc-controller.sch, interface-board.brd, interface-board.sch, material-holes.scad]
2013-12-12 added preliminary spindle driver circuit.
    [spindle-driver.brd, spindle-driver.sch]
2013-12-12 a few more cleanups before the Rev E release.
    [cnc-controller.sch, mega-pin-allocation.xls, pin-allocation.xls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]
